MurderBot1/apriltag-processor/site/img/parts/usbc.webp

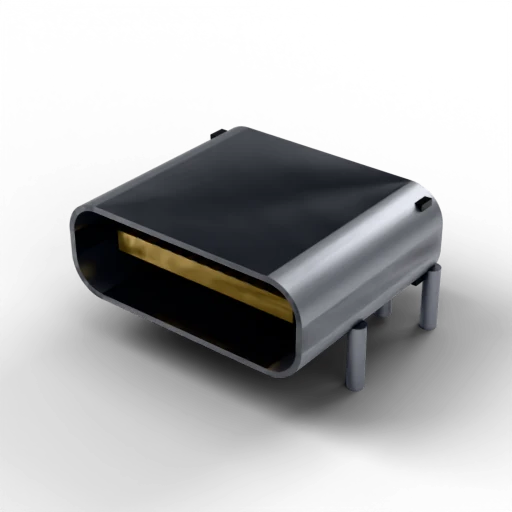
site/img/parts/usbc.webp
