MurderBot1/apriltag-processor/docs/RESUME.md

# Project state (rewritten 2026-11-01)

Rules for agents and the manager are in `CLAUDE.md`. This file is the current state of the project: what is done, how well each item is known, what can still go wrong, and what remains before a production run. Numbers come from the files named next to them; regenerate them with the tool named there.

## 1. What the product is

OV9281 global-shutter sensor (1280x800, 120 fps, 2-lane MIPI) -> ECP5 **LFE5U-25F-8BG381I** (custom RTL: D-PHY/CSI-2 receive, adaptive threshold, despeckle, connected-component labelling, `mask_stream`) -> 8-bit strobed frame bus (21.4 MB/s) -> RP2350A (PIO + DMA into 3 frame buffers, tag unit in C `firmware/core/attpu.c`, pose solve, field map and calibration in flash, USB CDC) -> host. This is architecture "A3" (`docs/architecture.md`, `docs/costdown.md`). The old FPGA processor (TPU) is kept only as the bit-exact reference in `ref/tpu`. All of A3, the sourcing changes, the PCB fixes and the lowcon register are merged into `main` (PRs #9 to #18).

## 2. Done, by how well it is known

### Verified by tests in CI (`tests.yml`, `tests/run_all.py`; about 230 tests, see `docs/verification.md`)

- RTL blocks are bit-exact against Python golden models (threshold, despeckle, labeller, CSI-2, D-PHY with lane skew, mask stream packet format and byte timing, I2C sensor init).
- The C tag unit `attpu.c` equals the instruction-set simulator of the old FPGA processor word for word on all 100 dataset frames.
- Whole-chip RTL chain on the 100-frame dataset at 120 fps timing: 501 of 570 detectable tags detected (87.9 %), no false positives (`results/rtl_chain_results.json`); the reference detector finds 560 of 570. The dataset is rendered with the shipping CIL023 camera model (section 6 of the risks).
- Firmware logic on the PC: COBS/CRC framing, flash storage with simulated power loss at every byte, command handling, host library end to end, pose solver (`test_pose_solver.py`).
- Board data (`tests/test_pcb.py`, `tests/test_pcb_erc.py`): every net has at least two pins, every FPGA power ball is on the right rail (the floating power pads of the earlier layout are connected), pin plan rules, BOM designators agree with `pcb/output/bom.csv`.
- Housing (`tests/test_housing.py`): watertight STLs, screw posts against PCB holes, FOV cone clearance for the 82.2 degree lens.
- Per-category dataset workflows report N/10 per category on PRs.
- Firmware image: `.github/workflows/firmware.yml` builds `apriltag_cam.uf2/.elf/.bin` on Linux with Pico SDK 2.1.1 and arm-none-eabi-gcc 13.2.1 and checks the size. Do not build firmware on Windows (msys `ld` fails).

### Estimated by tools, not signoff (treat as ± a margin)

- FPGA timing and area, LFE5U-25F speed 8 (nextpnr estimates, pinned OSS CAD Suite 2025-09-01, `results/fpga_speed_grades.md`): 13,389 LUT4 (55 %), 56 of 56 block RAM (100 %), core 92.27 - 94.91 MHz against 85.714 MHz needed, D-PHY 206.06 - 226.71 MHz against 200, 7 of 7 seeds close. Only speed grade 8 closes; grades 6 and 7 fail on both clocks. Numbers marked 45F in `docs/fpga.md` (12,227 LUT4, 56 of 108 block RAM, 4 of 6 seeds) are older RTL and older tools on the 45F.
- Tag unit and pose time on the Cortex-M33: emulated cycle counts, not silicon (`results/tpu_c_m33_cycles.md`, `results/pose_m33_cycles.json`): tag unit median about 1.6 ms, worst about 9.3 ms (nominal, 150 MHz, one core). Frame drop model (`results/frame_budget.md`): 3 buffers with early release, 0 % nominal and 1 % pessimistic drops. SRAM about 480 to 488 KB of 520 KiB (computed, not linked here).
- Cost per board (`docs/bom/PRODUCTION.md` section 4, generated by `tools/bom_cost_table.py`): 249.49 USD at 1 board, 106.98 at 10, 85.37 at 100 with the DigiKey 25F. This is a floor: no bare PCB, no OV9281, no shipping or taxes.
- Lens field of view: 82.2 degrees rectilinear HFOV from the focal length and sensor width; with the stated -5 % TV distortion the real value is about 84 to 85 degrees (one published data point). The simulated dataset uses fx 733.33 px, k1 -0.126 (my reading of -5 % TV); calibrate the real lens.

### Needs hardware (nothing below has been run on a real board)

- No board has been built or powered. No bitstream has been loaded on an ECP5; no firmware has run on an RP2350.
- PIO capture of the frame bus and the 21.4 MB/s timing margin (the PIO input synchroniser adds about 13 ns; the data window is 11.7 ns before and 35 ns after the strobe edge, from the model). DMA and CPU SRAM contention while the tag unit runs.
- Bus timing between FPGA and MCU, 3.3 V LVCMOS33 at DRIVE=8, trace delays.
- D-PHY at 800 Mb/s lane rate on the real sensor (the RTL receiver is only tested against a bit-level model), sensor register set and I2C bring-up on a real OV9281.
- Boot chain: flash, ECP5 configuration from SPI flash, MCU boot, power sequencing of the 1.2 V, 1.8 V, 2.5 V, 2.8 V, 3.3 V rails, USB enumeration.
- Real accuracy: the dataset is simulated.

## 3. Remaining risks

1. **25F block RAM is 100 % full (56 of 56).** Any RTL growth in block RAM needs the 45F or 85F. Both are pin- and footprint-compatible (`tools/pin_compat.py`: 31 used balls identical), the 85F closes timing on 6 of 7 seeds (seed 3 fails the D-PHY clock). The 45F speed 8 is out of stock.
2. **U1 supply.** Only 108 authorised LFE5U-25F-8BG381I pieces on 2026-11-01 (DigiKey 18, Mouser 90). Lead time for more is 40 weeks. A 100-board run cannot be built from stock today. Second source: 85F-8BG381C (about 2.5 times the price, DigiKey 17 / Mouser 10 / LCSC 8). Speed 6 and 7 parts do not close timing. The UM (SERDES) variant is not a drop-in (SERDES supply balls are tied to GND on this PCB).
3. **U6/U8 ME6211.** The datasheet was fetched on 2026-11-01 (MICRONE ME6211 V20, PDF copies from chipdip.ru and elecfans.com; the LCSC-hosted PDF could not be downloaded). Verified from it: SOT23-5 pinout 1 VIN, 2 VSS, 3 CE, 4 NC, 5 VOUT (matches the board), maximum output current 400 mA (2.5 V) and 450 mA (2.8 V), dropout typical 110 mV at 100 mA and 220 mV at 200 mA, VIN maximum 6.5 V. Still open: compare the revision with the LCSC-hosted datasheet at order time; the OV9281 AVDD/EVDD current from the OmniVision datasheet is not read, so the 450 mA margin on the 2.8 V rail is unchecked.
4. **OV9281 price is unverified.** No priced seller found (quote-only listings). It blocks a priced production BOM. Fallback: the Camemake module, which needs a PCB re-spin.
5. **Bare PCB price is unverified.** The JLCPCB 4-layer quote page could not be read; the BOM excludes it. Get a live quote (ENIG, impedance control for MIPI).
6. **Simulated dataset uses a modelled lens, not a calibrated one.** Since this update the 100 frames are rendered for CIL023 on the OV9281 (fx 733.33 px at 1280x800, HFOV 82.2 degrees, k1 = -0.126 for -5 % TV distortion, `tools/geom.py`, `config/camera_calibration.json`). The k1 value depends on how TV distortion is defined (see `docs/verification.md`); real optics (focus, vignetting, MTF, tangential error, sensor noise) will still differ. Detection moved from 562 / 647 (86.9 %, 90 degree camera) to 501 / 570 (87.9 %).
7. **lowcon ratio trade-off.** The THRESH `ratio` register fixes `lowcon` (ratio 2: 54 of 54 tags) but costs the `noise` category (19 of 50 at ratio 2) because speckle floods the labeller, so the reset value stays 0 (501 of 570 overall). A per-frame automatic choice is being built by another agent (firmware, host, API); it is not part of this state.
8. **No hardware tests at all** (see the needs-hardware list above): a first board bring-up will find problems that simulation cannot.
9. Y1 crystal (ABM8-272-T3, 10 pF) is out of stock at LCSC (5 at JLC) with the 15 pF load capacitors C15/C16: confirm the load capacitance or change C15/C16, and pick a second source.
10. Y2 oscillator is low stock (114 at LCSC and JLC). LH1 holder CLA021-LCP is in stock (1074 at Commonlands), the earlier CLA020-PC is sold out.
11. Simulation pages (`site/simout/`) were regenerated for the 100-frame dataset in PR #13; they need Icarus Verilog to regenerate (`iverilog`, not installed on the manager machine).
12. Release workflow (`release.yml`) has a dry-run input but no real release has been published. Pushing to `deploy` publishes one; default seed in `tools/build_all.sh` is 1 (closes on the 25F).

## 4. Production checklist (in order)

1. Re-check U1 stock and price at DigiKey, Mouser and LCSC; decide quantity against the 108 piece stock and the 40 week lead time; place the order or choose the 85F fallback.
2. Get a live JLCPCB 4-layer quote for the 48x48 mm board (ENIG, impedance control, 5 or more pieces) and put it in `bom.json` as a verified line.
3. Get a quote for the OV9281 (OmniVision distributor, CSP, MOQ) or decide on the module re-spin.
4. Read the OmniVision datasheet: sensor supply currents (U8 margin), ordering code (H64A or other), MIPI rate, register set.
5. Compare the ME6211 datasheet revision from LCSC with V20 used here; check the C15/C16 against the Y1 load capacitance; choose a Y1 second source.
6. Re-run DRC on the final board, regenerate gerbers, BOM and pick-and-place with the repo scripts; check `pcb/output/bom.csv` against `docs/bom/bom.json` (`tests/test_pcb_erc.py`).
7. Order a small run (5 boards). Before power-up: check rail resistances, then bring up rails one at a time (3.3 V, 1.2 V, 1.8 V, 2.5 V, 2.8 V).
8. Bring-up: JTAG to the ECP5, load the bitstream from the release (`tools/build_all.sh` output), flash the UF2 to the RP2350, enumerate USB, read the sensor ID 0x9281 over I2C, check the D-PHY clock lane, capture one frame, check the PIO capture and packet counters (frames dropped), run the host library.
9. Measure on hardware what is now estimated: FPGA clocks and margin, frame bus timing, tag unit and pose time, drop rate at 120 fps, power.
10. Calibrate the real lens (fx, fy, cx, cy, k1 to k3), recompute HFOV, and build a real image set with ground truth to replace or add to the simulated one (the simulated set already uses the nominal fx and a modelled -5 % TV k1).
11. Tag the release: merge `main` into `deploy` (`git push origin main:deploy`), which builds everything and creates a new GitHub Release; check the release assets.

## 5. Working notes

- Windows `git push` hangs on the credential manager; use the command in `CLAUDE.md` (empty `credential.helper` first, then the `gh` helper).
- Windows reports an agent folder as busy when an agent left a hung `git` process behind: kill only those `git` / `git-credential-manager` processes, then delete the folder.
- `todo.md` in the manager repo is untracked.
- BOM or site changes: edit `docs/bom/bom.json`, run `python docs/bom/build_bom.py` and `py -3.12 site/build_site.py`, commit the generated files, keep `pcb/output/bom.csv` consistent. Cost table: `python tools/bom_cost_table.py`.
