MurderBot1/apriltag-processor/render/out/pcb_layers/pcb_bottom_8192.png

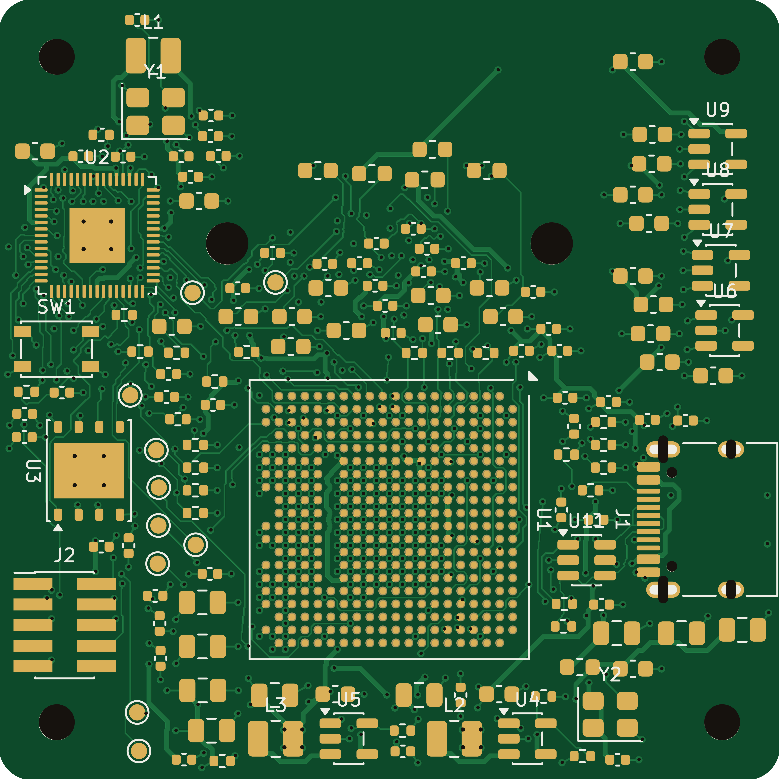
render/out/pcb_layers/pcb_bottom_8192.png
