MurderBot1/apriltag-processor/render/out/pcb_layers/tiles/bcu/3/0_0.png

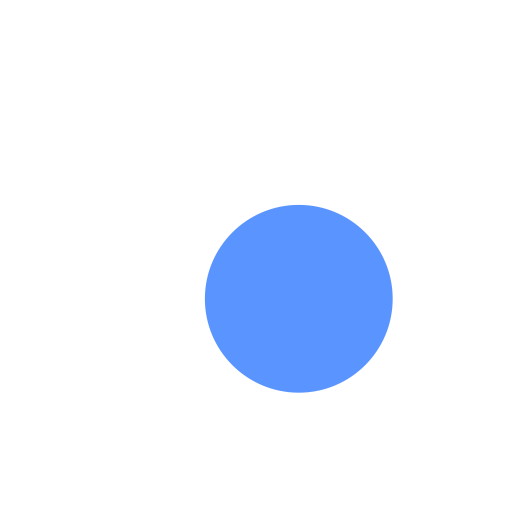
render/out/pcb_layers/tiles/bcu/3/0_0.png
