MurderBot1/apriltag-processor/render/out/pcb_layers/tiles/bcu/3/1_6.png

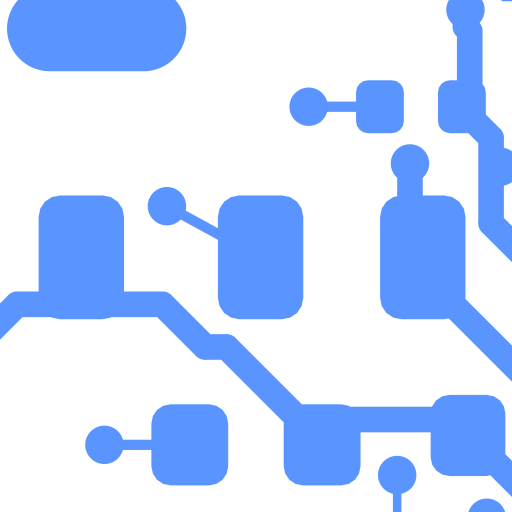
render/out/pcb_layers/tiles/bcu/3/1_6.png
