MurderBot1/apriltag-processor/render/out/pcb_layers/tiles/bcu/3/2_1.png

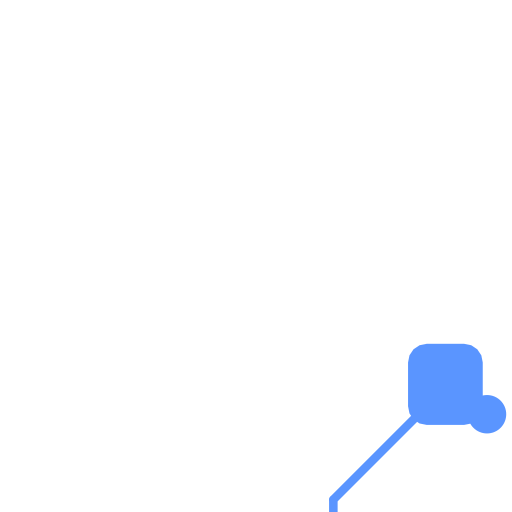
render/out/pcb_layers/tiles/bcu/3/2_1.png
