MurderBot1/apriltag-processor/render/out/pcb_layers/tiles/bcu/3/4_7.png

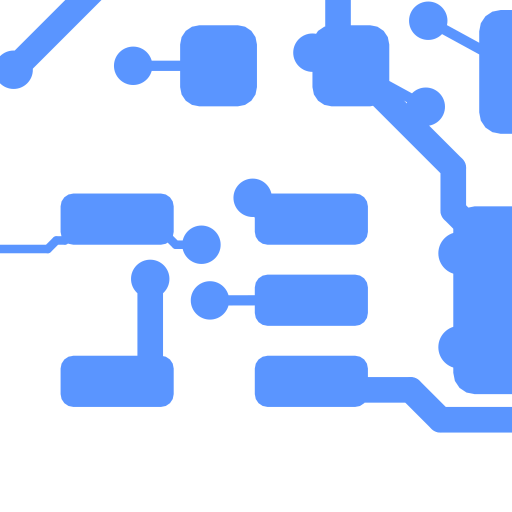
render/out/pcb_layers/tiles/bcu/3/4_7.png
