MurderBot1/apriltag-processor/render/out/pcb_layers/tiles/bmask/3/6_0.png

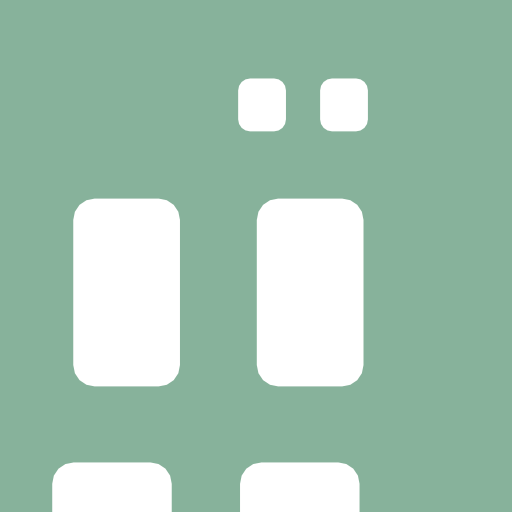
render/out/pcb_layers/tiles/bmask/3/6_0.png
