MurderBot1/apriltag-processor/render/out/pcb_layers/tiles/bmask/3/7_2.png

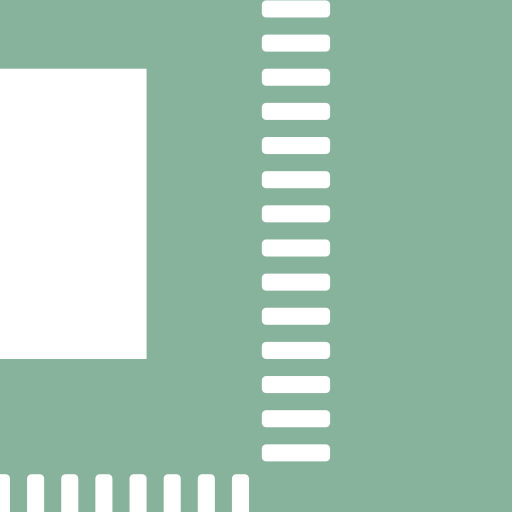
render/out/pcb_layers/tiles/bmask/3/7_2.png
