MurderBot1/apriltag-processor/render/out/pcb_layers/tiles/bsilk/1/1_0.png

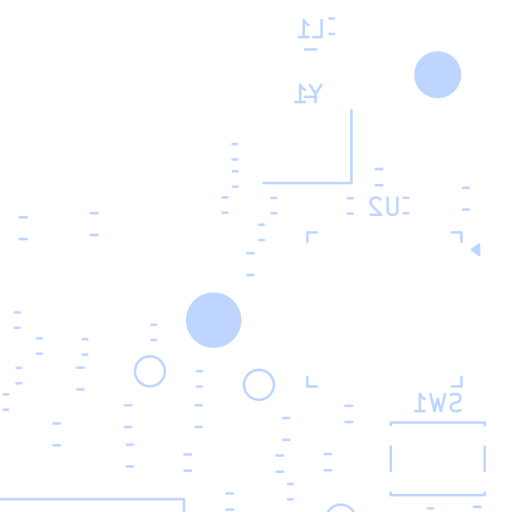
render/out/pcb_layers/tiles/bsilk/1/1_0.png
