MurderBot1/apriltag-processor/render/out/pcb_layers/tiles/bsilk/2/1_3.png

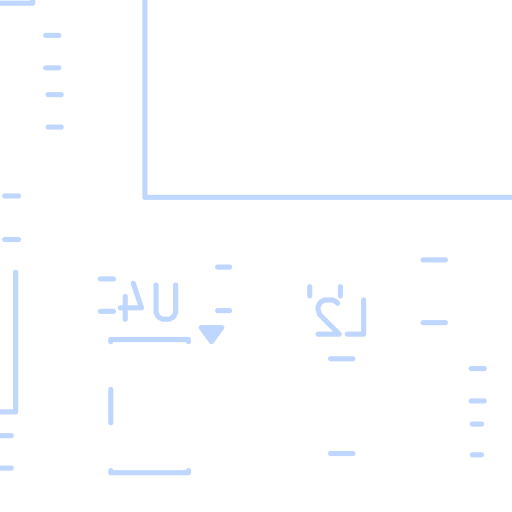
render/out/pcb_layers/tiles/bsilk/2/1_3.png
