MurderBot1/apriltag-processor/render/out/pcb_layers/tiles/bsilk/3/2_4.png

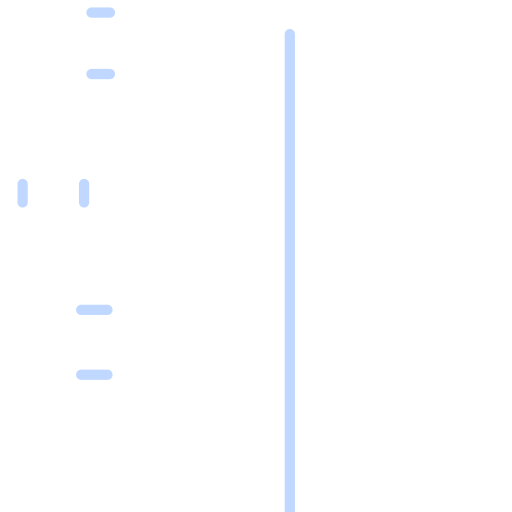
render/out/pcb_layers/tiles/bsilk/3/2_4.png
