MurderBot1/apriltag-processor/render/out/pcb_layers/tiles/bsilk/3/5_5.png

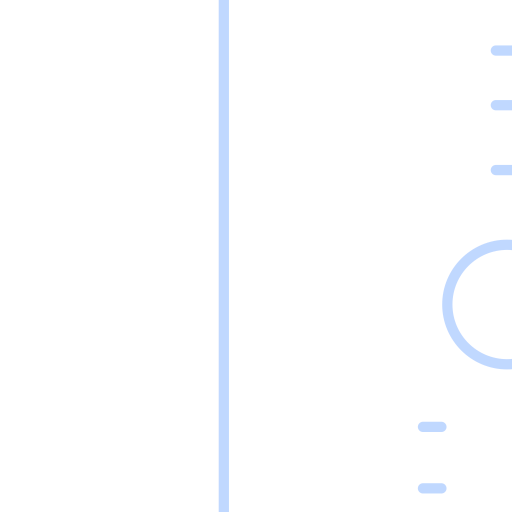
render/out/pcb_layers/tiles/bsilk/3/5_5.png
