MurderBot1/apriltag-processor/render/out/pcb_layers/tiles/bsilk/3/6_1.png

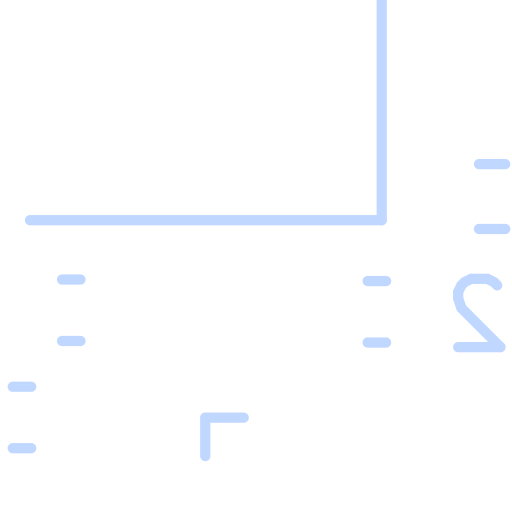
render/out/pcb_layers/tiles/bsilk/3/6_1.png
