MurderBot1/apriltag-processor/render/out/pcb_layers/tiles/fcu/2/2_0.png

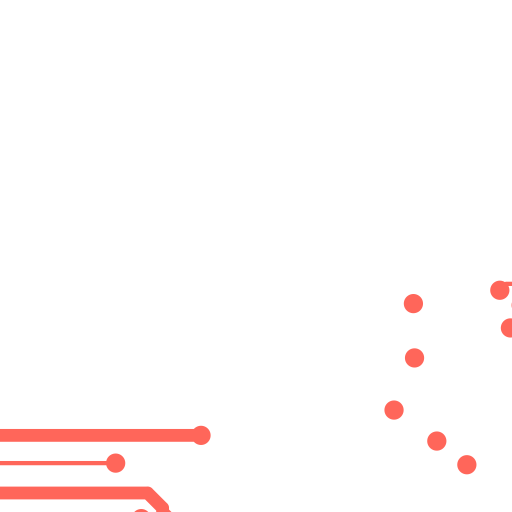
render/out/pcb_layers/tiles/fcu/2/2_0.png
