MurderBot1/apriltag-processor/render/out/pcb_layers/tiles/fcu/2/3_3.png

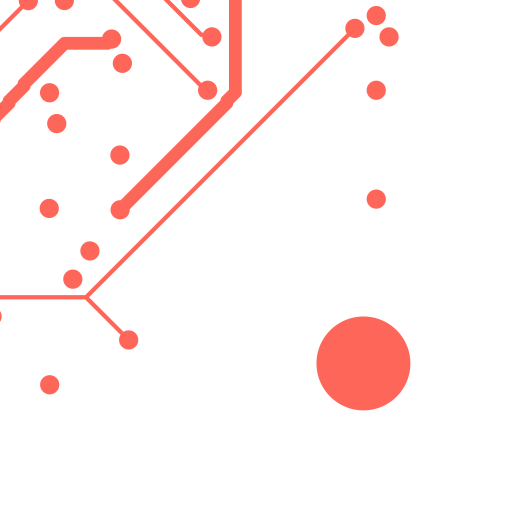
render/out/pcb_layers/tiles/fcu/2/3_3.png
