MurderBot1/apriltag-processor/render/out/pcb_layers/tiles/fcu/3/0_5.png

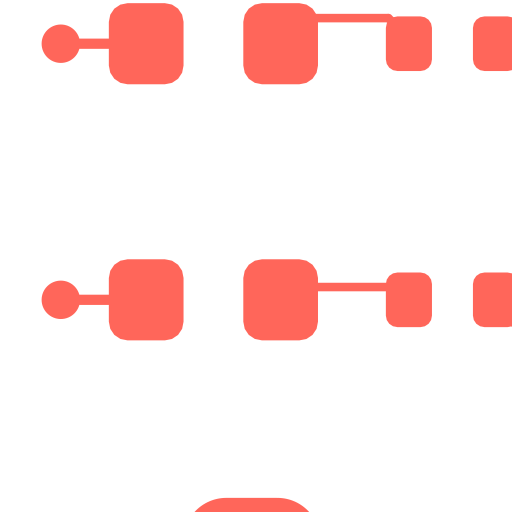
render/out/pcb_layers/tiles/fcu/3/0_5.png
