MurderBot1/apriltag-processor/render/out/pcb_layers/tiles/fcu/3/3_7.png

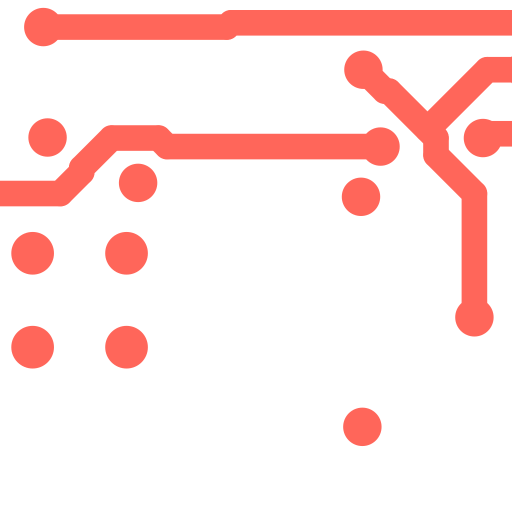
render/out/pcb_layers/tiles/fcu/3/3_7.png
