MurderBot1/apriltag-processor/render/out/pcb_layers/tiles/fcu/3/6_7.png

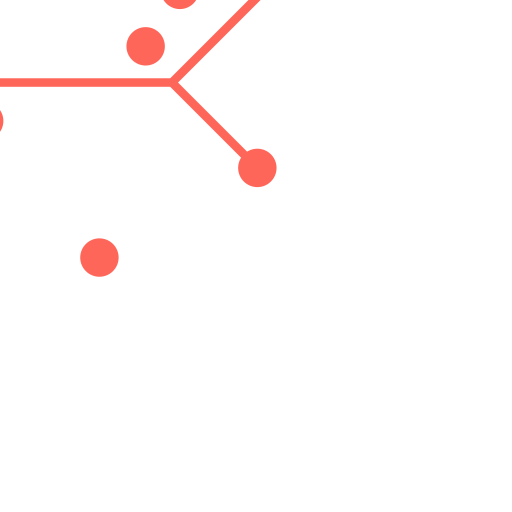
render/out/pcb_layers/tiles/fcu/3/6_7.png
