MurderBot1/apriltag-processor/render/out/pcb_layers/tiles/fmask/3/0_5.png

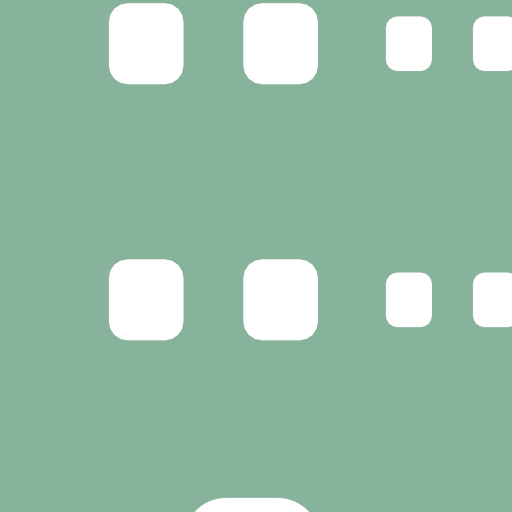
render/out/pcb_layers/tiles/fmask/3/0_5.png
