MurderBot1/apriltag-processor/render/out/pcb_layers/tiles/fsilk/0/0_0.png

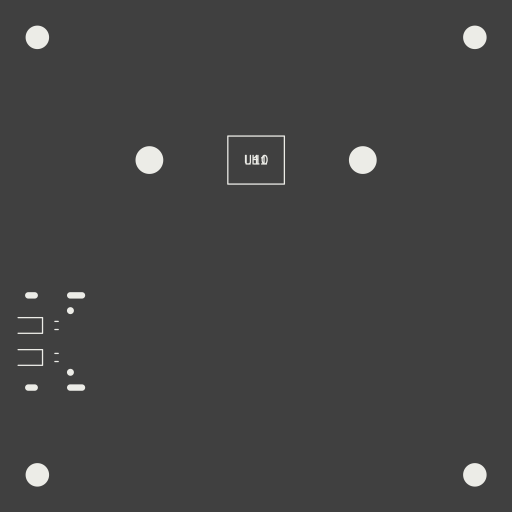
render/out/pcb_layers/tiles/fsilk/0/0_0.png
