MurderBot1/apriltag-processor/render/out/pcb_layers/tiles/fsilk/2/0_2.png

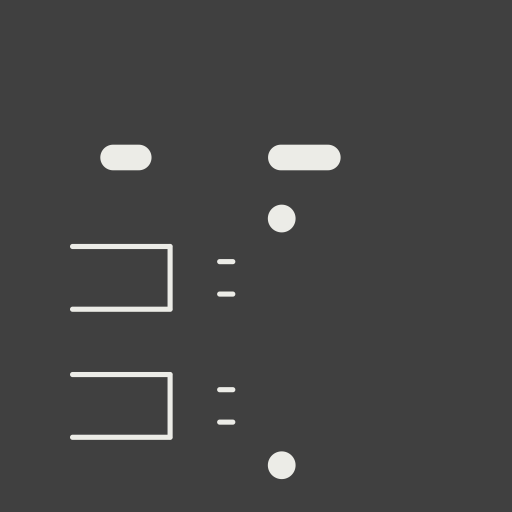
render/out/pcb_layers/tiles/fsilk/2/0_2.png
