MurderBot1/apriltag-processor/render/out/pcb_layers/tiles/fsilk/2/3_0.png

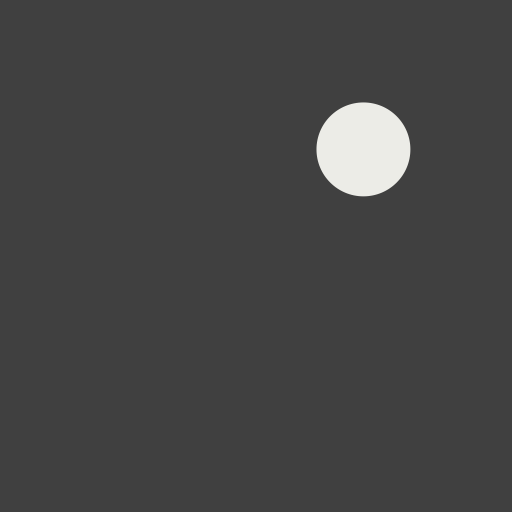
render/out/pcb_layers/tiles/fsilk/2/3_0.png
