MurderBot1/apriltag-processor/render/out/pcb_layers/tiles/fsilk/3/0_7.png

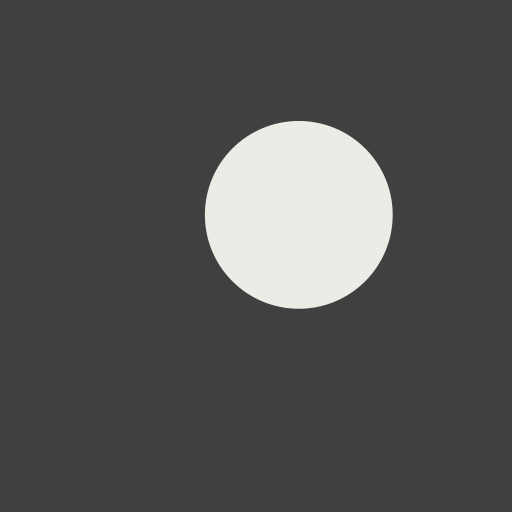
render/out/pcb_layers/tiles/fsilk/3/0_7.png
