MurderBot1/apriltag-processor/render/out/pcb_layers/tiles/fsilk/4/0_15.png

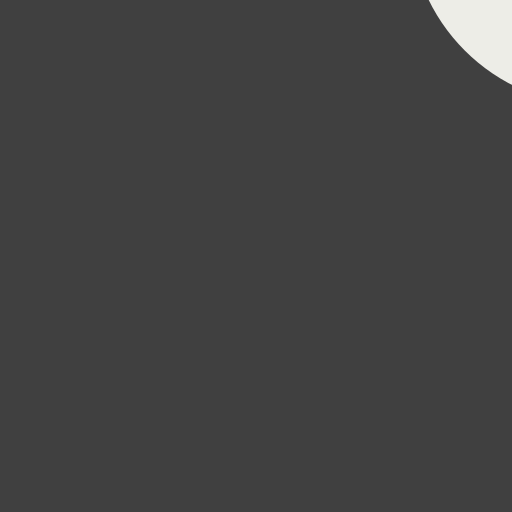
render/out/pcb_layers/tiles/fsilk/4/0_15.png
