MurderBot1/apriltag-processor/render/out/pcb_layers/tiles/fsilk/4/8_5.png

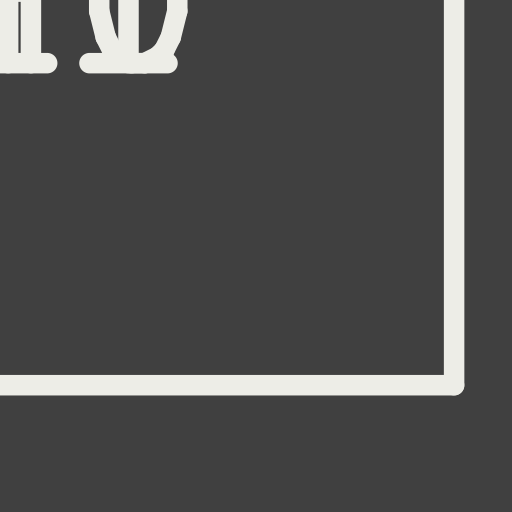
render/out/pcb_layers/tiles/fsilk/4/8_5.png
