MurderBot1/apriltag-processor/render/out/pcb_layers/tiles/fsilk/4/11_4.png

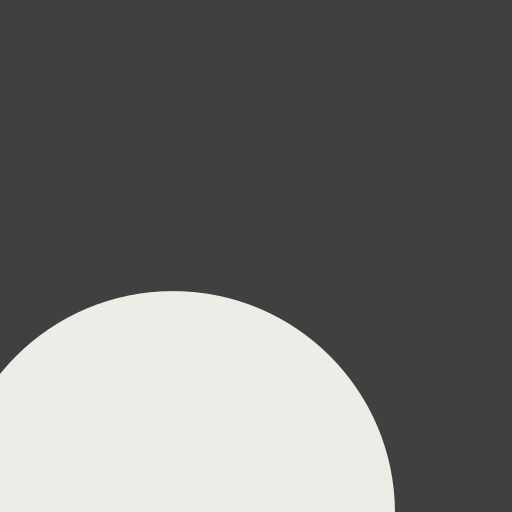
render/out/pcb_layers/tiles/fsilk/4/11_4.png
