MurderBot1/apriltag-processor/render/out/pcb_layers/tiles/in1/3/1_3.png

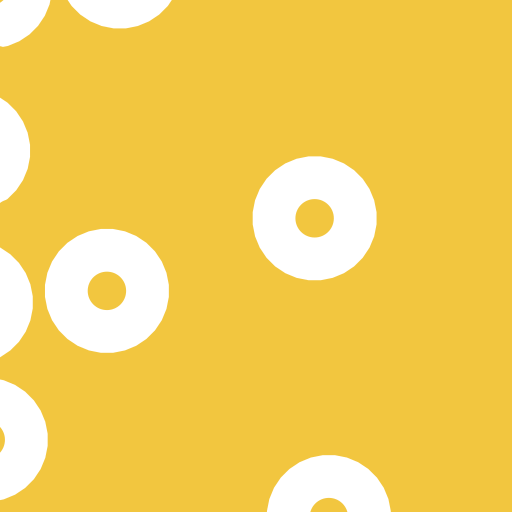
render/out/pcb_layers/tiles/in1/3/1_3.png
