MurderBot1/apriltag-processor/render/out/pcb_layers/tiles/in1/3/2_7.png

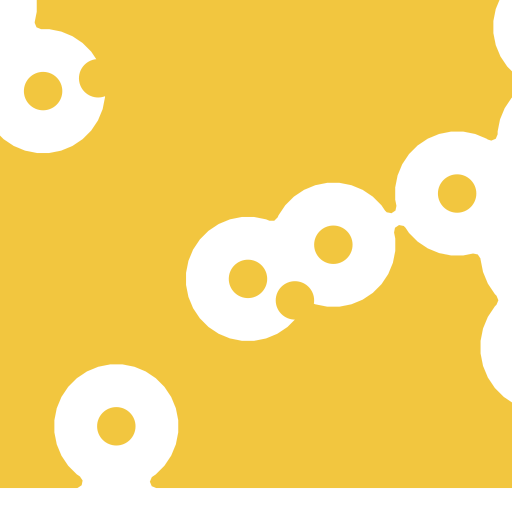
render/out/pcb_layers/tiles/in1/3/2_7.png
