MurderBot1/apriltag-processor/render/out/pcb_layers/tiles/in1/3/3_6.png

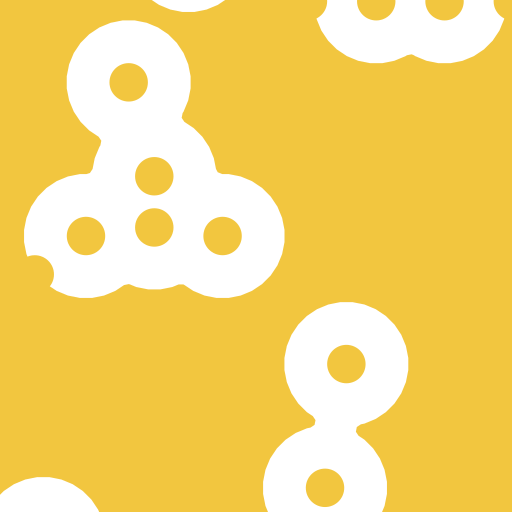
render/out/pcb_layers/tiles/in1/3/3_6.png
