MurderBot1/apriltag-processor/render/out/pcb_layers/tiles/in1/3/4_4.png

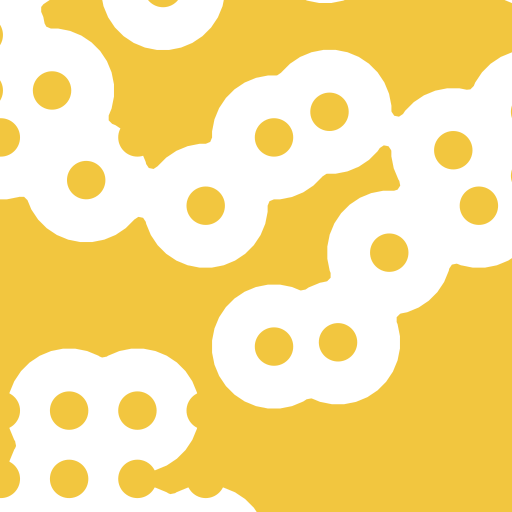
render/out/pcb_layers/tiles/in1/3/4_4.png
