MurderBot1/apriltag-processor/render/out/pcb_layers/tiles/in1/3/6_6.png

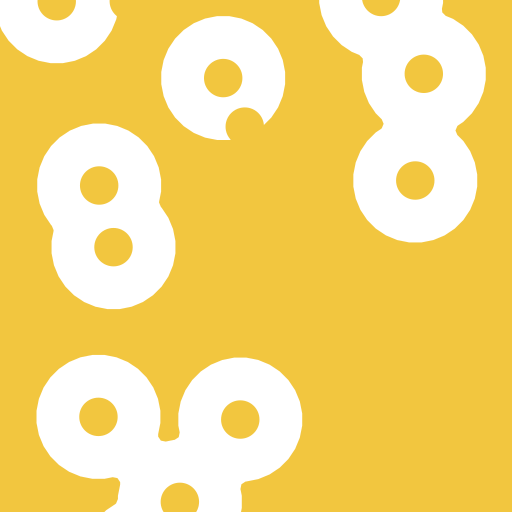
render/out/pcb_layers/tiles/in1/3/6_6.png
