MurderBot1/apriltag-processor/render/out/pcb_layers/tiles/in1/3/7_0.png

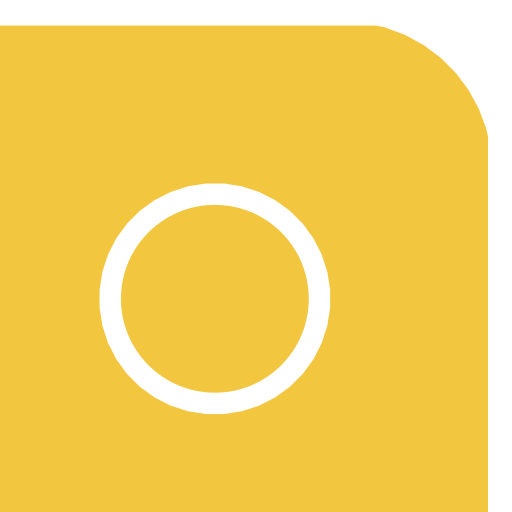
render/out/pcb_layers/tiles/in1/3/7_0.png
