MurderBot1/apriltag-processor/render/out/pcb_layers/tiles/in2/1/0_0.png

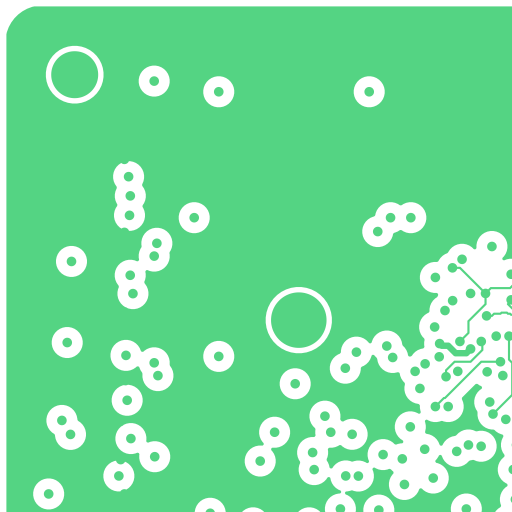
render/out/pcb_layers/tiles/in2/1/0_0.png
