MurderBot1/apriltag-processor/render/out/pcb_layers/tiles/in2/1/1_1.png

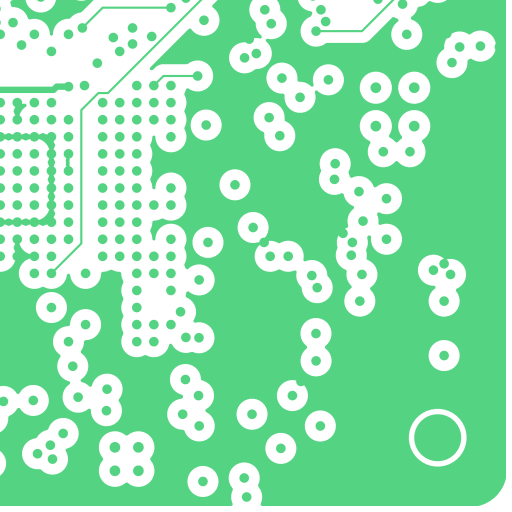
render/out/pcb_layers/tiles/in2/1/1_1.png
