MurderBot1/apriltag-processor/render/out/pcb_layers/tiles/in2/3/0_2.png

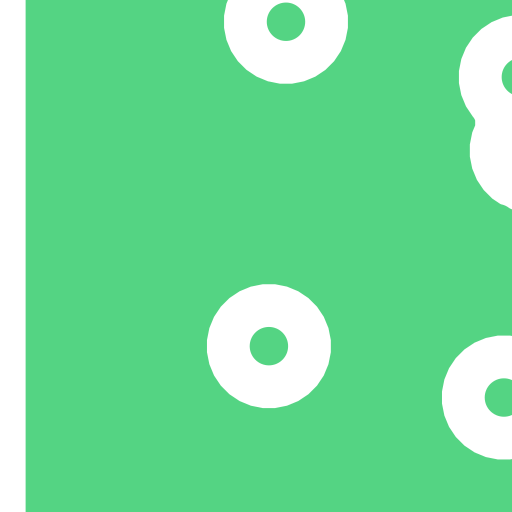
render/out/pcb_layers/tiles/in2/3/0_2.png
