MurderBot1/apriltag-processor/render/out/pcb_layers/tiles/in2/3/2_3.png

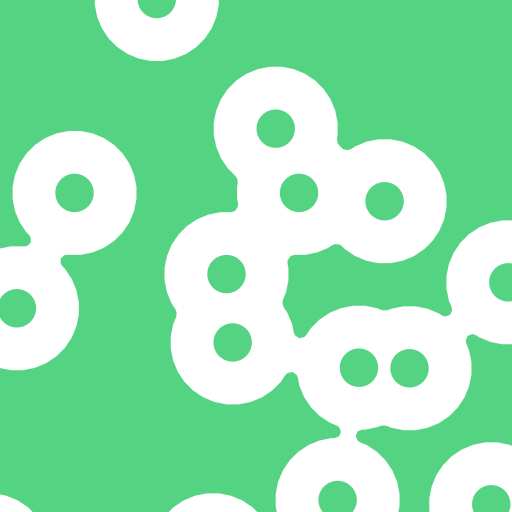
render/out/pcb_layers/tiles/in2/3/2_3.png
