MurderBot1/apriltag-processor/render/out/pcb_layers/tiles/in2/3/7_4.png

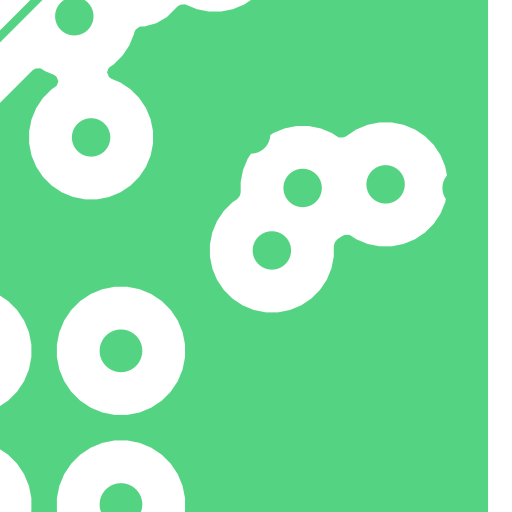
render/out/pcb_layers/tiles/in2/3/7_4.png
