MurderBot1/apriltag-processor/render/out/pcb_layers/tiles/rbot/2/0_1.png

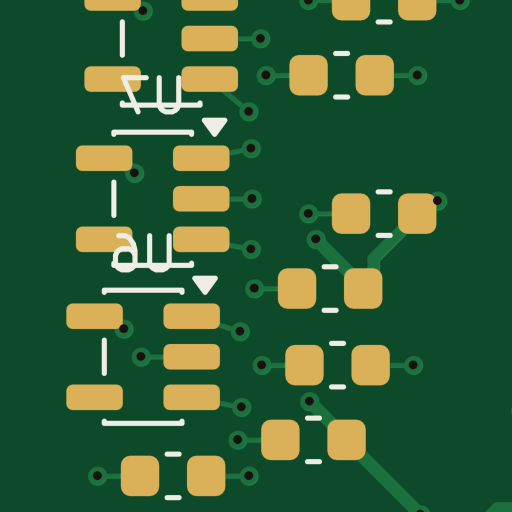
render/out/pcb_layers/tiles/rbot/2/0_1.png
