MurderBot1/apriltag-processor/render/out/pcb_layers/tiles/rbot/3/1_7.png

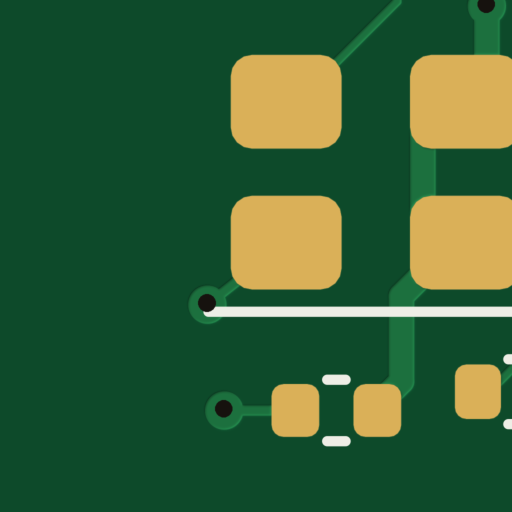
render/out/pcb_layers/tiles/rbot/3/1_7.png
