MurderBot1/apriltag-processor/render/out/pcb_layers/tiles/rbot/3/4_5.png

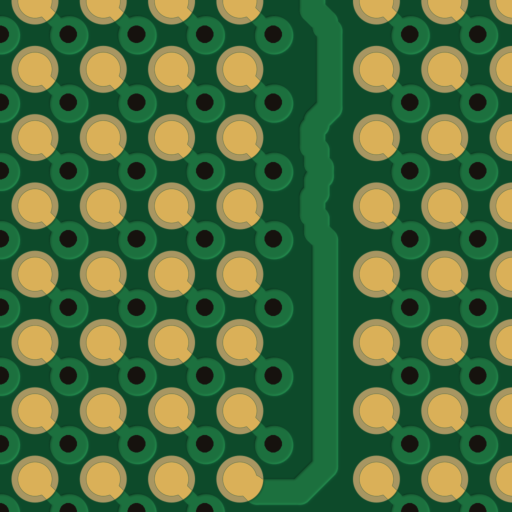
render/out/pcb_layers/tiles/rbot/3/4_5.png
