MurderBot1/apriltag-processor/render/out/pcb_layers/tiles/rbot/3/5_3.png

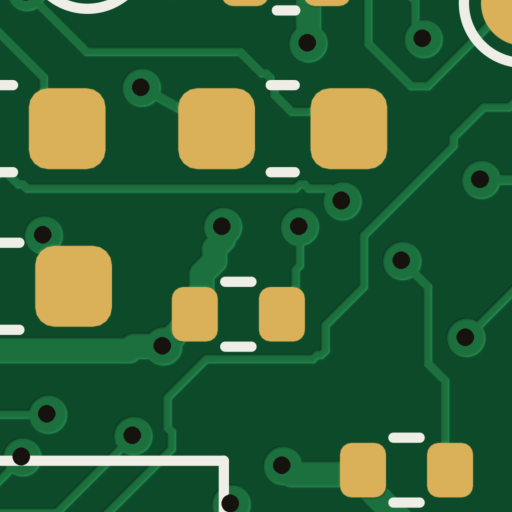
render/out/pcb_layers/tiles/rbot/3/5_3.png
