MurderBot1/apriltag-processor/render/out/pcb_layers/tiles/rbot/3/5_6.png

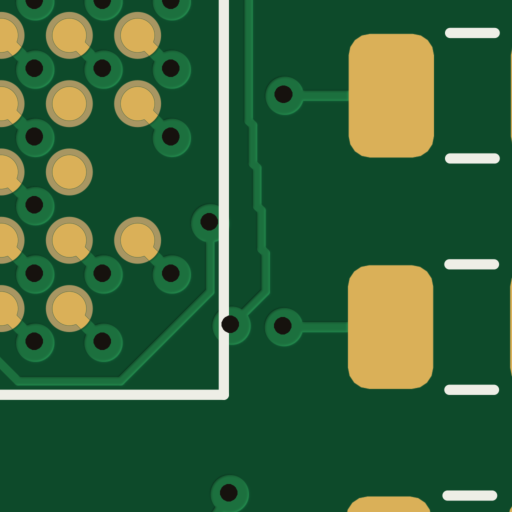
render/out/pcb_layers/tiles/rbot/3/5_6.png
