MurderBot1/apriltag-processor/render/out/pcb_layers/tiles/rtop/2/2_1.png

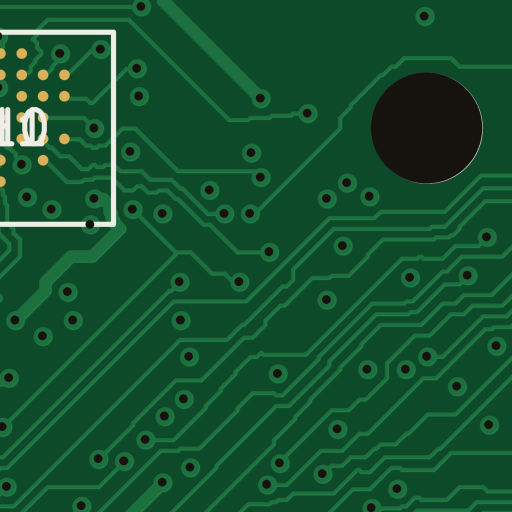
render/out/pcb_layers/tiles/rtop/2/2_1.png
