MurderBot1/apriltag-processor/render/out/pcb_layers/tiles/rtop/3/0_1.png

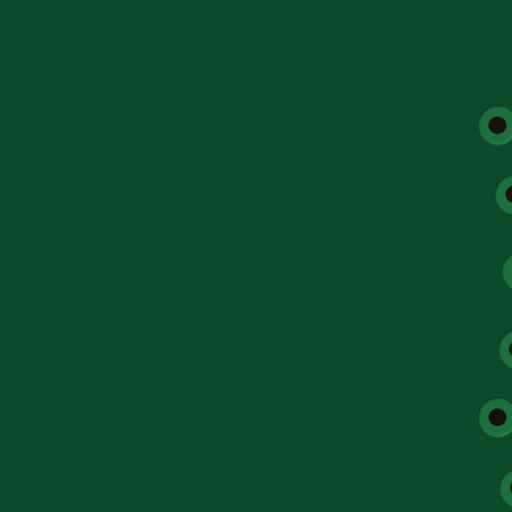
render/out/pcb_layers/tiles/rtop/3/0_1.png
