MurderBot1/apriltag-processor/render/out/pcb_layers/tiles/rtop/3/4_3.png

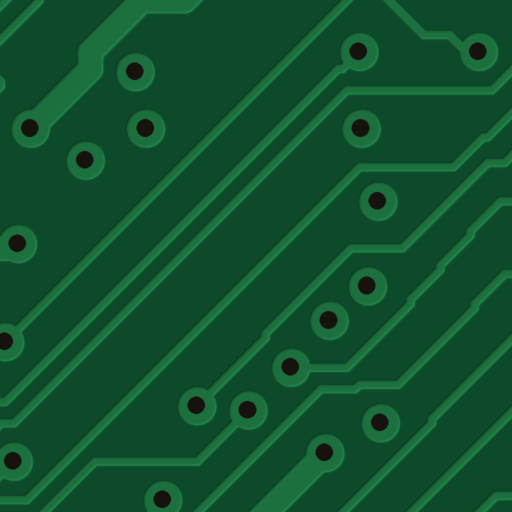
render/out/pcb_layers/tiles/rtop/3/4_3.png
