MurderBot1/apriltag-processor/render/out/pcb_layers/tiles/rtop/3/6_7.png

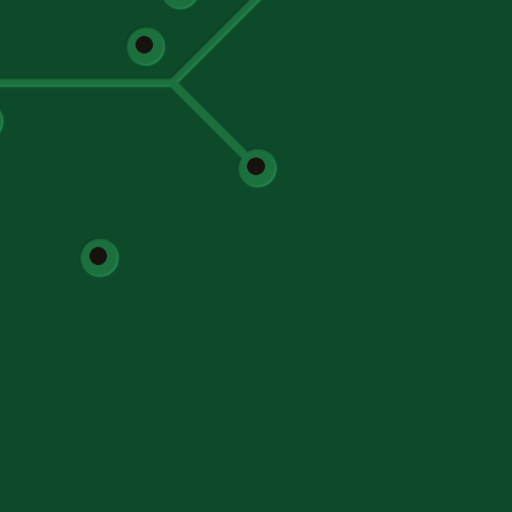
render/out/pcb_layers/tiles/rtop/3/6_7.png
