MurderBot1/apriltag-processor/render/out/turntable.webp

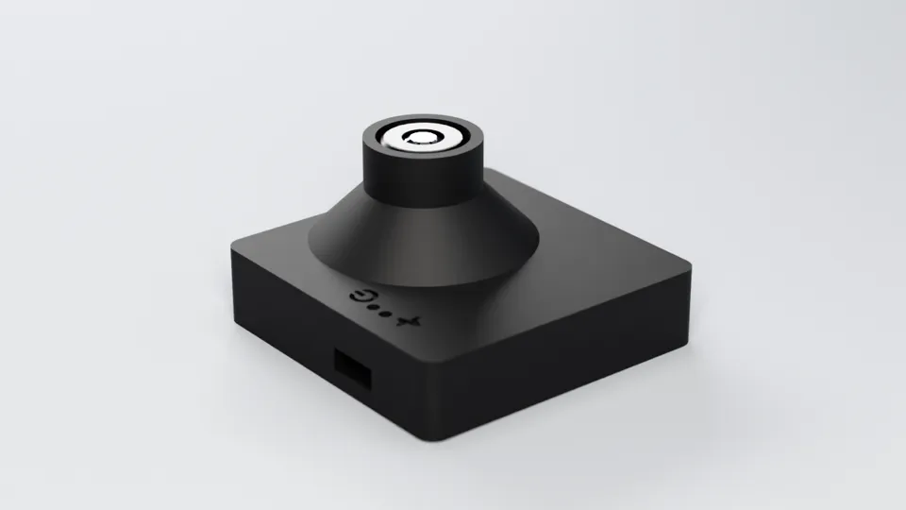
render/out/turntable.webp
