MurderBot1/apriltag-processor/site/img/r_section.png

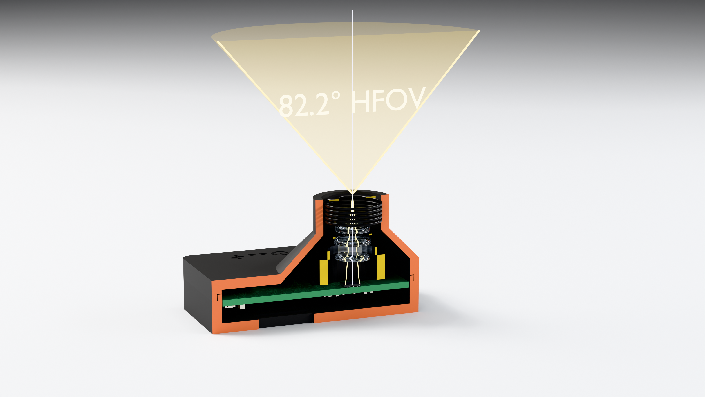
site/img/r_section.png
