MurderBot1/apriltag-processor/pcb/output/bom.csv

Qty | Value | Footprint | References
46 | 100n | C_0402_1005Metric | C1 C2 C3 C4 C5 C6 C7 C8 C9 C13 C14 C17 C38 C39 C40 C41 C42 C43 C44 C45 C46 C47 C48 C49 C50 C51 C52 C53 C54 C55 C56 C57 C58 C59 C60 C61 C62 C63 C64 C65 C70 C72 C74 C76 C77 C78
9 | 4u7 | C_0603_1608Metric | C10 C11 C12 C36 C37 C66 C67 C68 C69
2 | 15p | C_0402_1005Metric | C15 C16
4 | 10u | C_0805_2012Metric | C18 C19 C21 C24
12 | 1u | C_0603_1608Metric | C20 C28 C30 C32 C34 C71 C73 C75 C79 C80 C81 C82
5 | 22u | C_0805_2012Metric | C22 C23 C25 C26 C27
4 | 2u2 | C_0603_1608Metric | C29 C31 C33 C35
1 | PWR | LED_0603_1608Metric | D1
1 | STAT | LED_0603_1608Metric | D2
1 | BLM18 600R | L_0603_1608Metric | FB1
5 | BLM18 120R | L_0603_1608Metric | FB2 FB3 FB4 FB5 FB6
1 | USB-C | USB_C_Receptacle_HRO_TYPE-C-31-M-12 | J1
1 | JTAG | PinHeader_2x05_P1.27mm_Vertical_SMD | J2
1 | 3u3 | L_1008_2520Metric | L1
2 | 2u2 | L_1008_2520Metric | L2 L3
2 | 33R | R_0402_1005Metric | R1 R2
1 | 453k | R_0402_1005Metric | R10
2 | 100k | R_0402_1005Metric | R11 R13
1 | 82k5 | R_0402_1005Metric | R12
3 | 4k7 | R_0402_1005Metric | R16 R17 R18
3 | 100R | R_0402_1005Metric | R24 R25 R26
2 | 2k2 | R_0402_1005Metric | R27 R28
6 | 10k | R_0402_1005Metric | R3 R19 R20 R21 R22 R23
4 | 1k | R_0402_1005Metric | R4 R5 R14 R15
2 | 5k1 | R_0402_1005Metric | R6 R7
2 | 27R | R_0402_1005Metric | R8 R9
1 | BOOTSEL | SW_SPST_PTS810 | SW1
1 | LFE5U-25F-8BG381I | Lattice_caBGA-381_17x17mm_Layout20x20_P0.8mm | U1
1 | USBLC6-2SC6 | SOT-23-6 | U11
1 | RP2350A | QFN-60-1EP_7x7mm_P0.4mm_EP3.4x3.4mm | U2
1 | W25Q128JVPIQ | WSON-8-1EP_6x5mm_P1.27mm_EP3.4x4.3mm | U3
2 | TLV62569 | SOT-23-5 | U4 U5
1 | ME6211C25 | SOT-23-5 | U6
1 | TLV75518 | SOT-23-5 | U7
1 | ME6211C28 | SOT-23-5 | U8
1 | TLV75512 | SOT-23-5 | U9
1 | 12MHz 10pF | Crystal_SMD_3225-4Pin_3.2x2.5mm | Y1
1 | 24MHz 1.8V | Oscillator_SMD_Abracon_ASE-4Pin_3.2x2.5mm | Y2
