MurderBot1/apriltag-processor/render/out/parts/c0402.webp

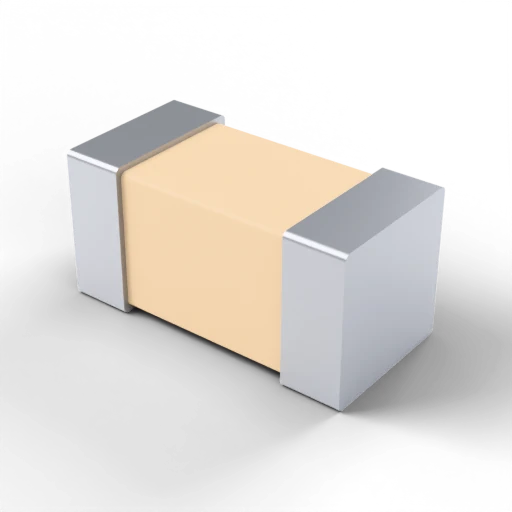
render/out/parts/c0402.webp
