MurderBot1/apriltag-processor/render/out/parts/c0805.webp

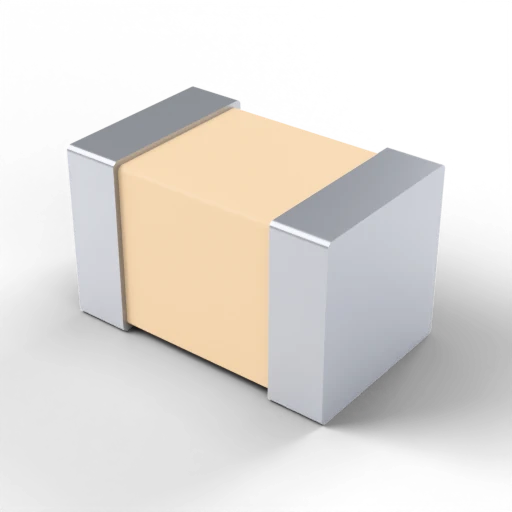
render/out/parts/c0805.webp
