MurderBot1/apriltag-processor/render/out/parts/ecp5.webp

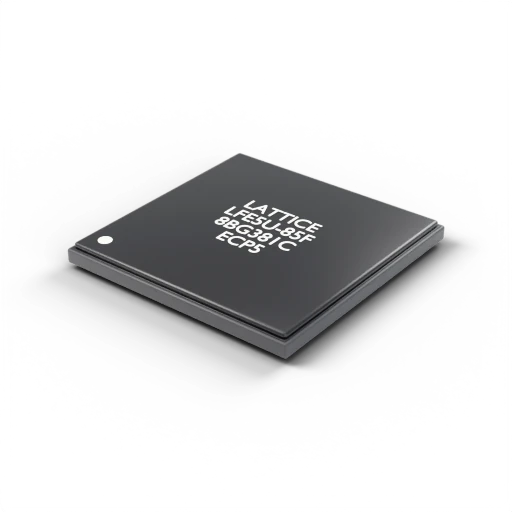
render/out/parts/ecp5.webp
