MurderBot1/apriltag-processor/render/out/parts/filament.webp

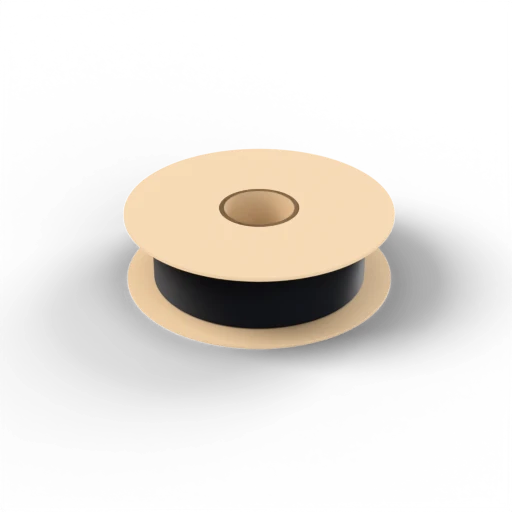
render/out/parts/filament.webp
