MurderBot1/apriltag-processor/render/out/parts/flash.webp

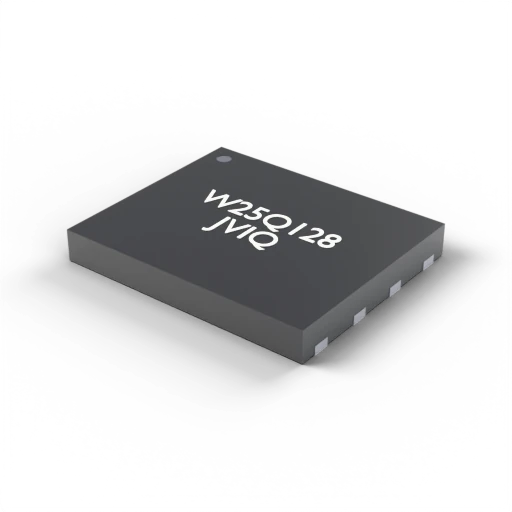
render/out/parts/flash.webp
