MurderBot1/apriltag-processor/render/out/parts/hdr.webp

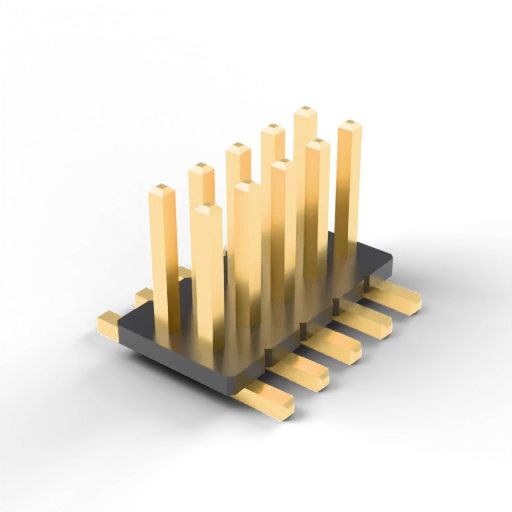
render/out/parts/hdr.webp
