MurderBot1/apriltag-processor/render/out/parts/holder.webp

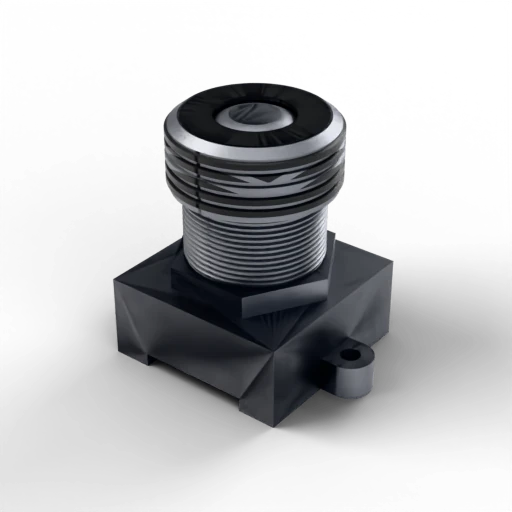
render/out/parts/holder.webp
