MurderBot1/apriltag-processor/render/out/parts/insert.webp

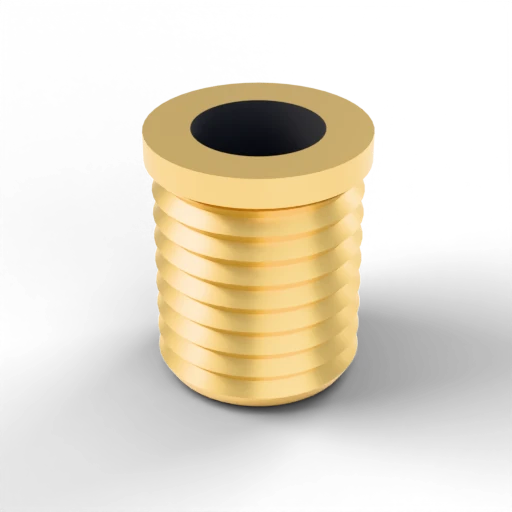
render/out/parts/insert.webp
