MurderBot1/apriltag-processor/render/out/parts/l0603.webp

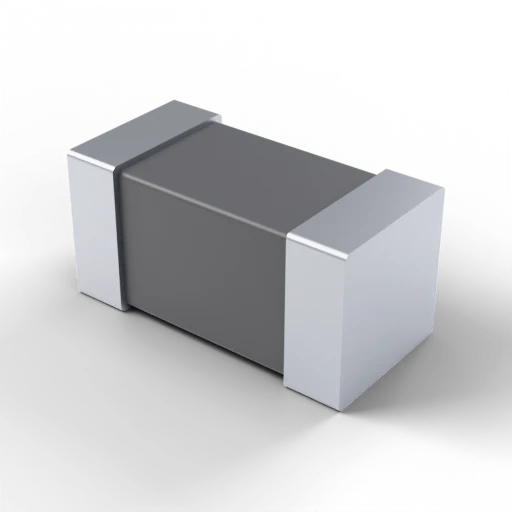
render/out/parts/l0603.webp
