MurderBot1/apriltag-processor/render/out/parts/l1008.webp

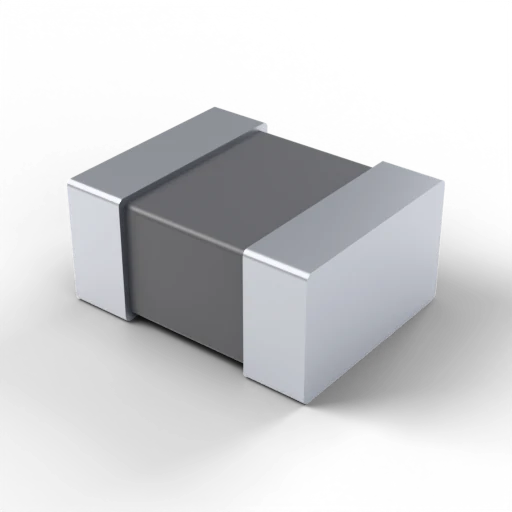
render/out/parts/l1008.webp
