MurderBot1/apriltag-processor/render/out/parts/led.webp

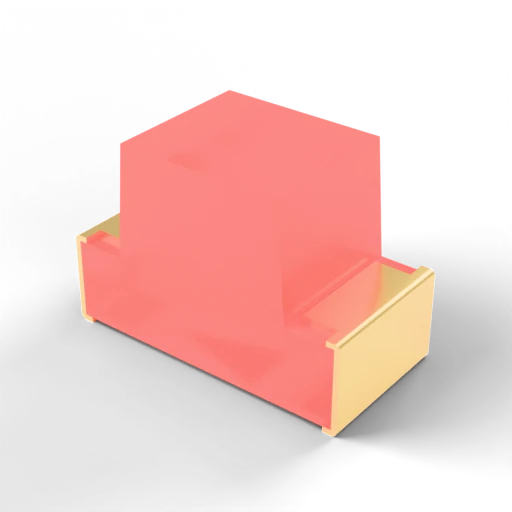
render/out/parts/led.webp
