MurderBot1/apriltag-processor/render/out/parts/lens.webp

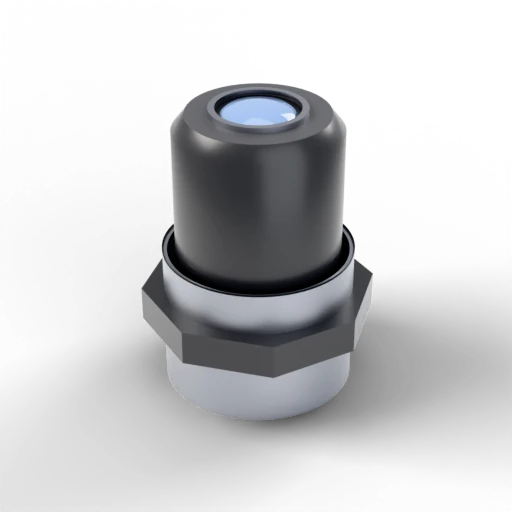
render/out/parts/lens.webp
