MurderBot1/apriltag-processor/render/out/parts/osc.webp

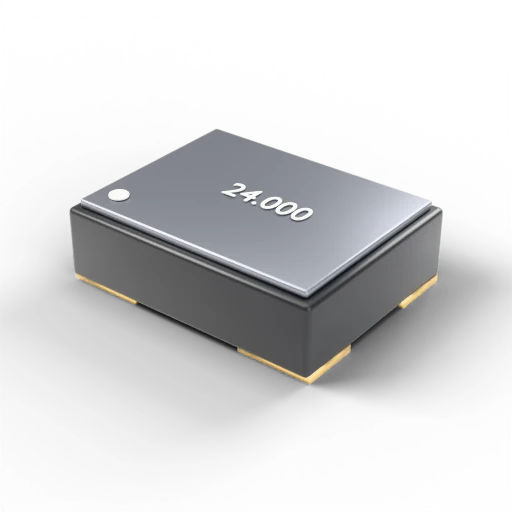
render/out/parts/osc.webp
