MurderBot1/apriltag-processor/render/out/parts/ov9281.webp

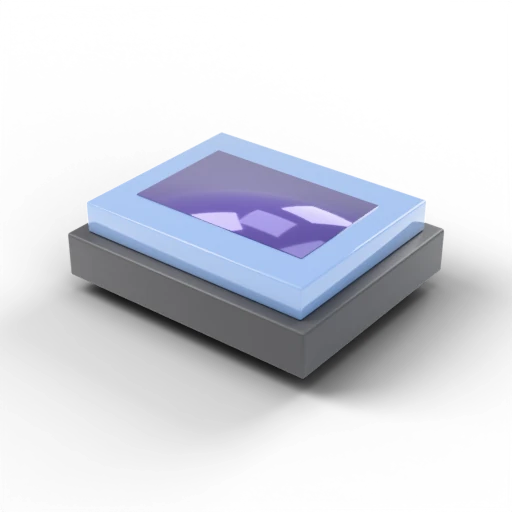
render/out/parts/ov9281.webp
