MurderBot1/apriltag-processor/render/out/parts/pcb.webp

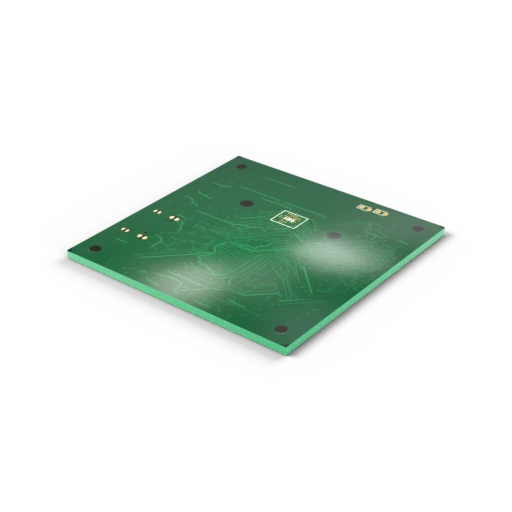
render/out/parts/pcb.webp
