MurderBot1/apriltag-processor/render/out/parts/r0402.webp

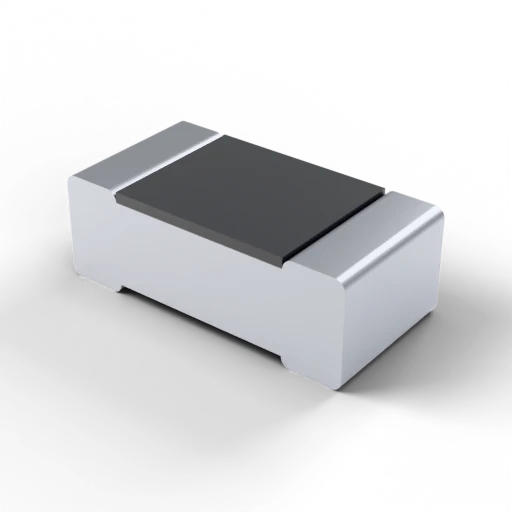
render/out/parts/r0402.webp
