MurderBot1/apriltag-processor/render/out/parts/rp2350.webp

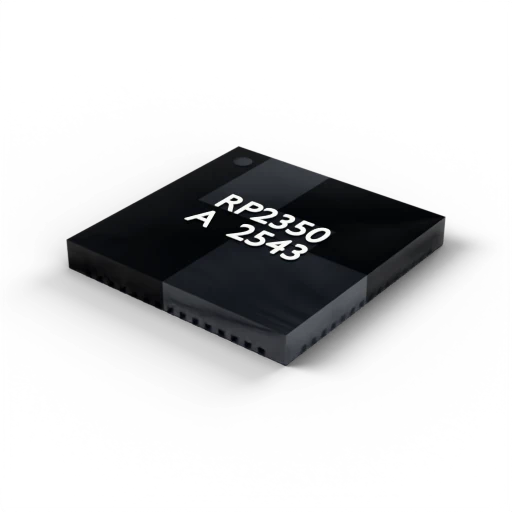
render/out/parts/rp2350.webp
