MurderBot1/apriltag-processor/render/out/parts/screw.webp

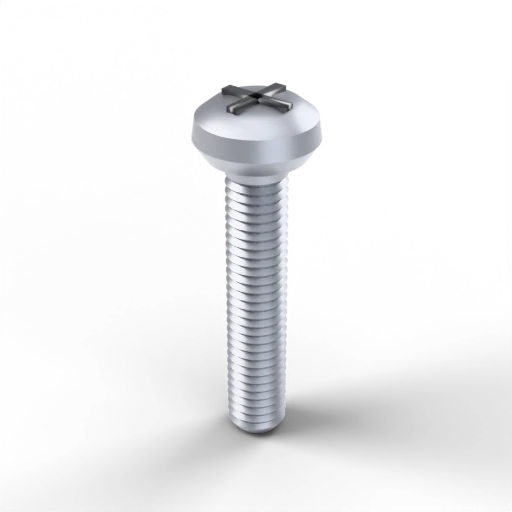
render/out/parts/screw.webp
