MurderBot1/apriltag-processor/render/out/parts/sw.webp

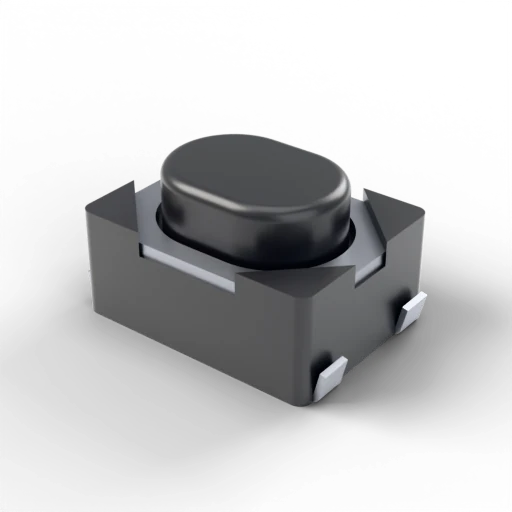
render/out/parts/sw.webp
