MurderBot1/apriltag-processor/render/out/parts/tlv62569.webp

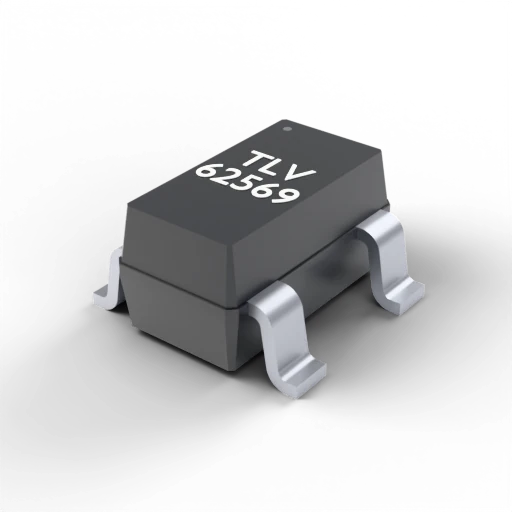
render/out/parts/tlv62569.webp
