MurderBot1/apriltag-processor/render/out/parts/xtal.webp

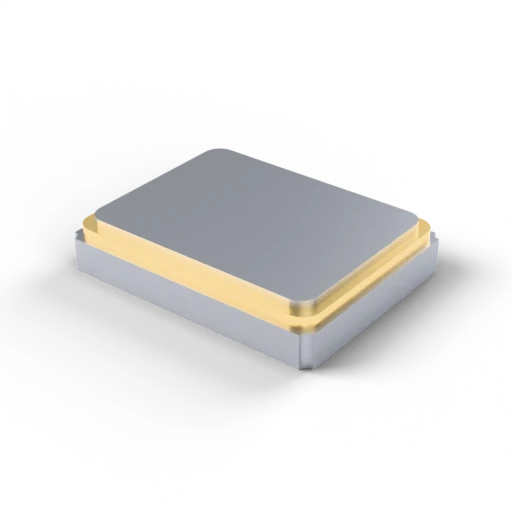
render/out/parts/xtal.webp
