MurderBot1/apriltag-processor/site/screenshots/bom2/bom-desktop-dark-cards.png

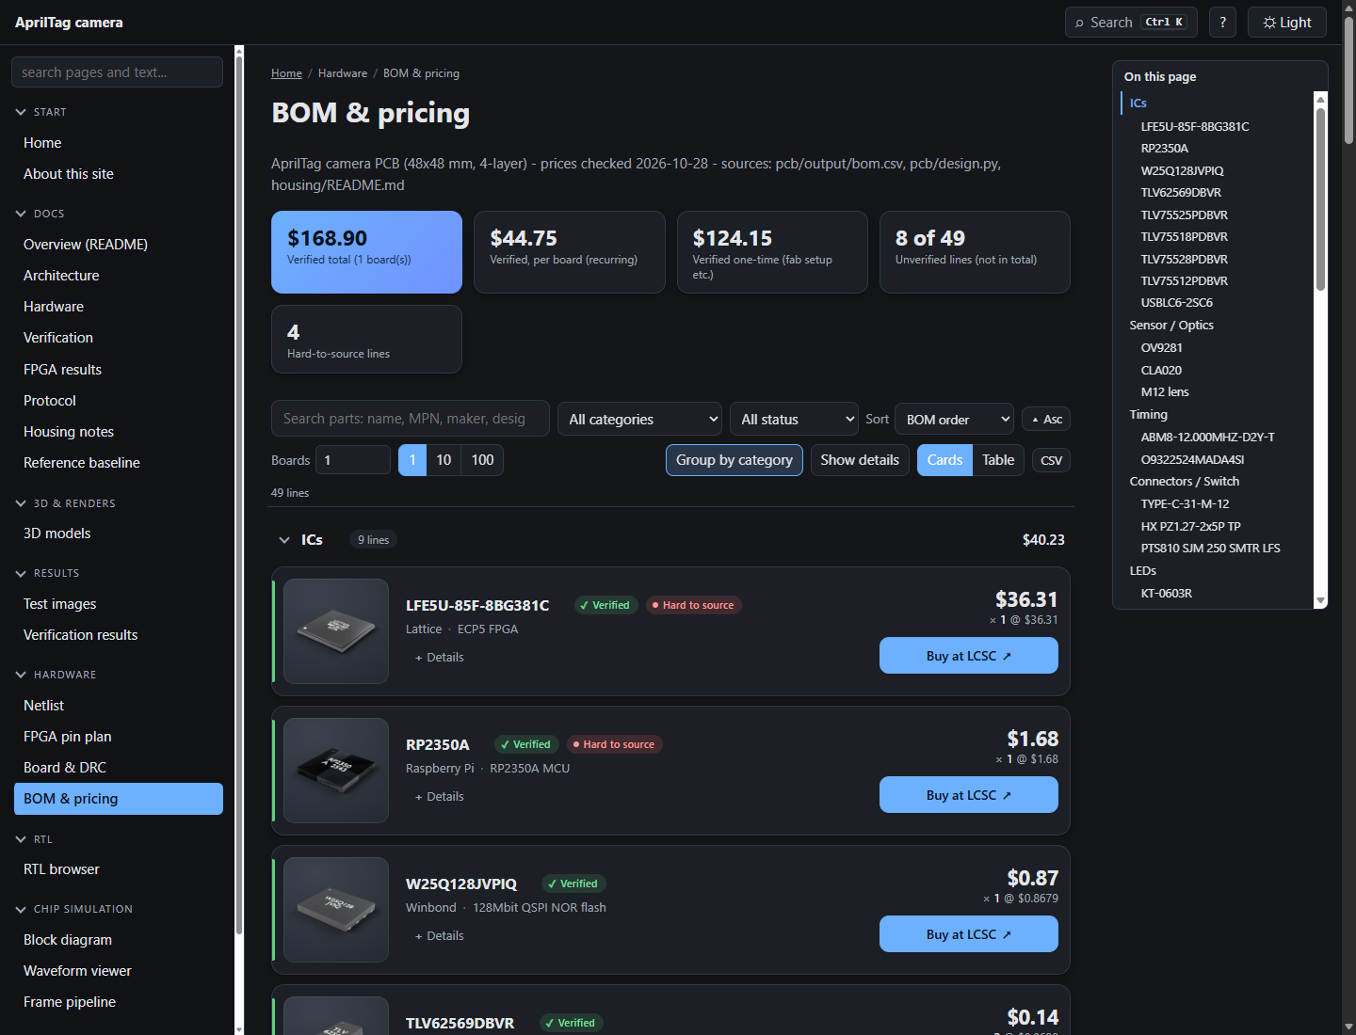
site/screenshots/bom2/bom-desktop-dark-cards.png
