MurderBot1/apriltag-processor/site/screenshots/bom2/bom-desktop-dark-table.png

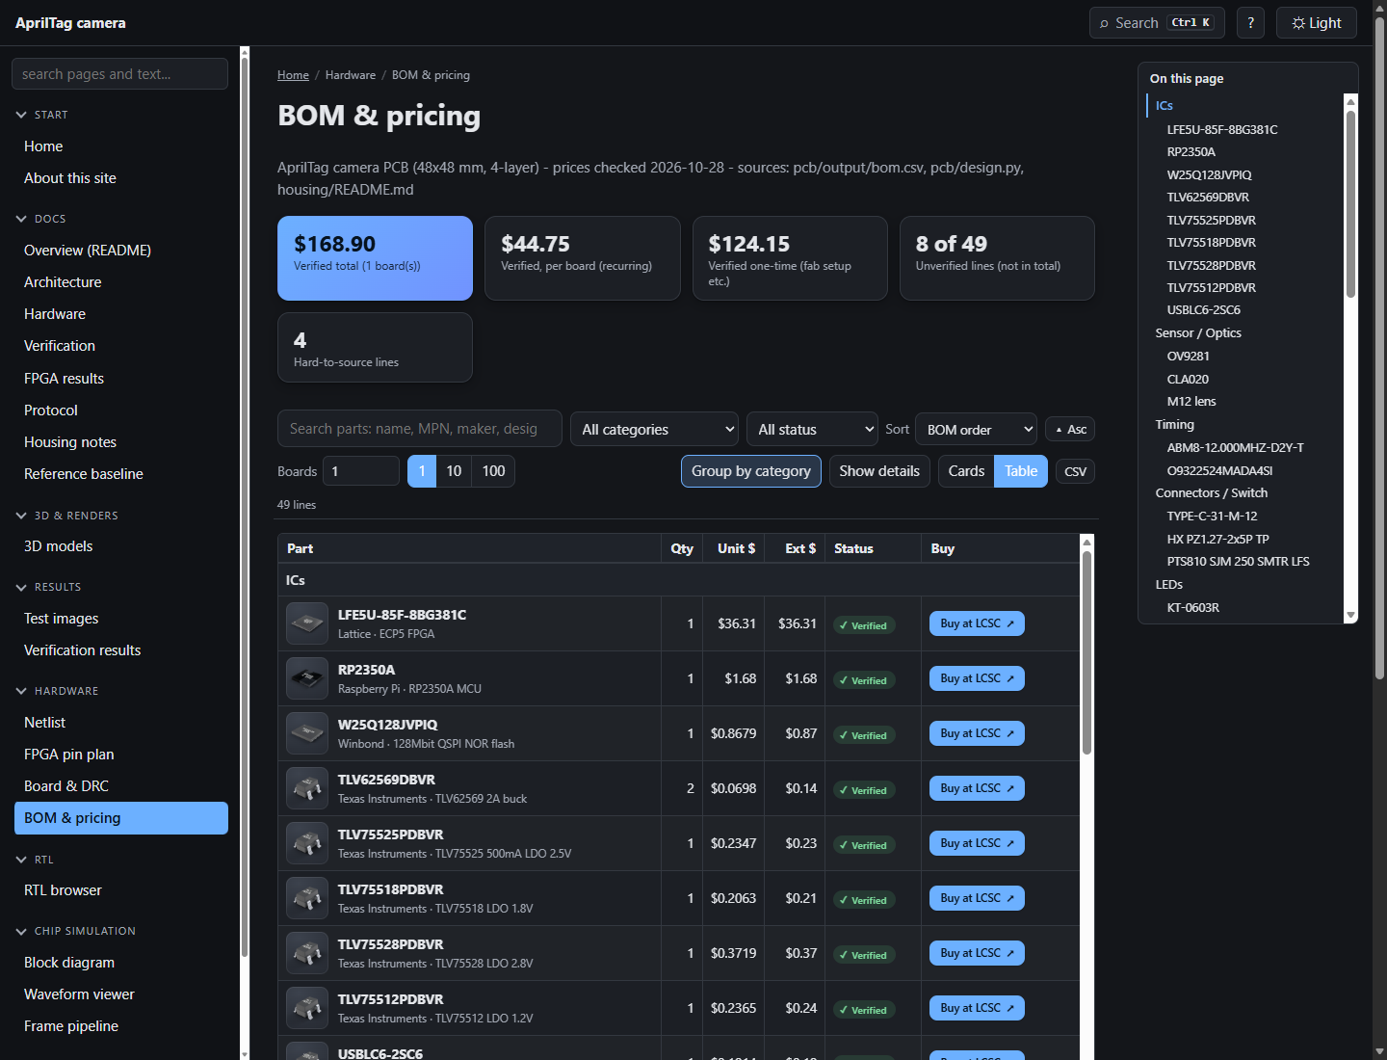
site/screenshots/bom2/bom-desktop-dark-table.png
