MurderBot1/apriltag-processor/site/screenshots/bom2/bom-desktop-light.png

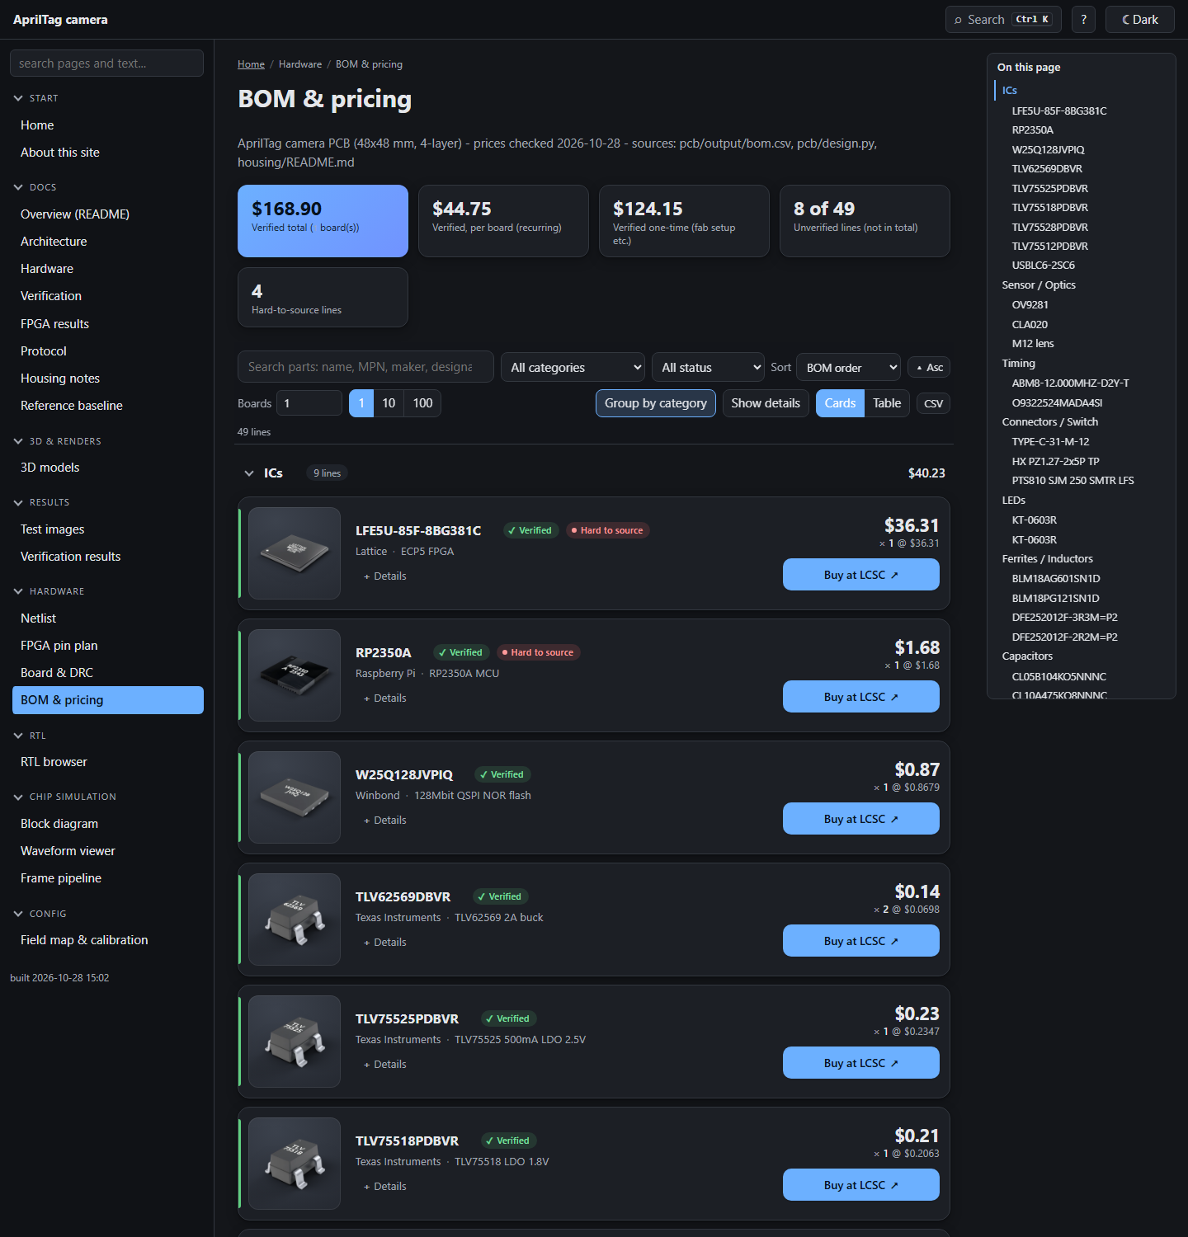
site/screenshots/bom2/bom-desktop-light.png
