MurderBot1/apriltag-processor/site/screenshots/bom2/bom-phone-dark-cards.png

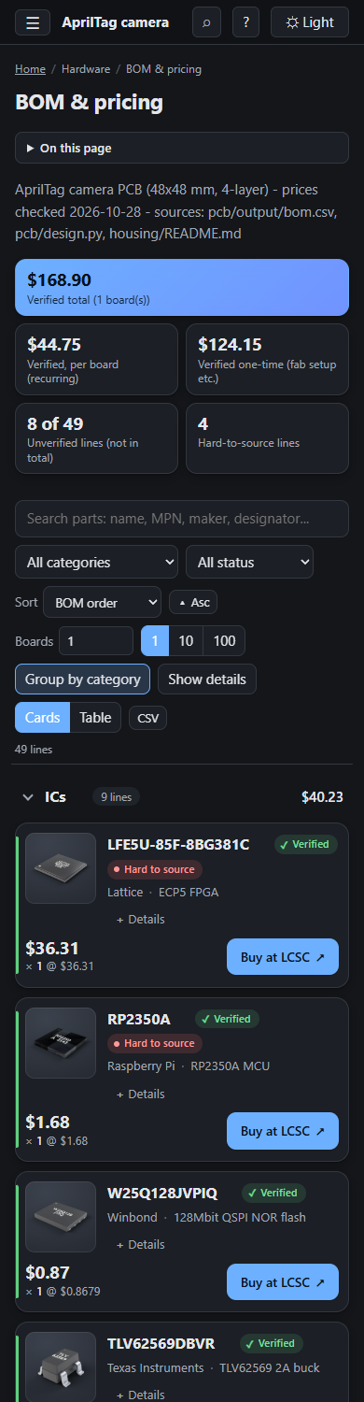
site/screenshots/bom2/bom-phone-dark-cards.png
