MurderBot1/apriltag-processor/site/screenshots/bom2/bom-phone-dark-table.png

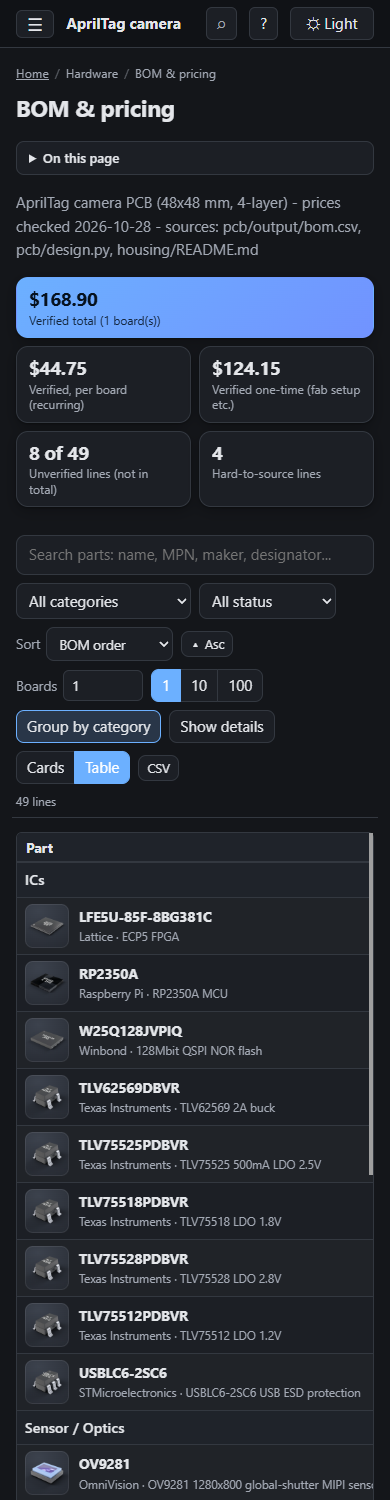
site/screenshots/bom2/bom-phone-dark-table.png
