MurderBot1/apriltag-processor/site/screenshots/bom2/bom-phone-light-cards.png

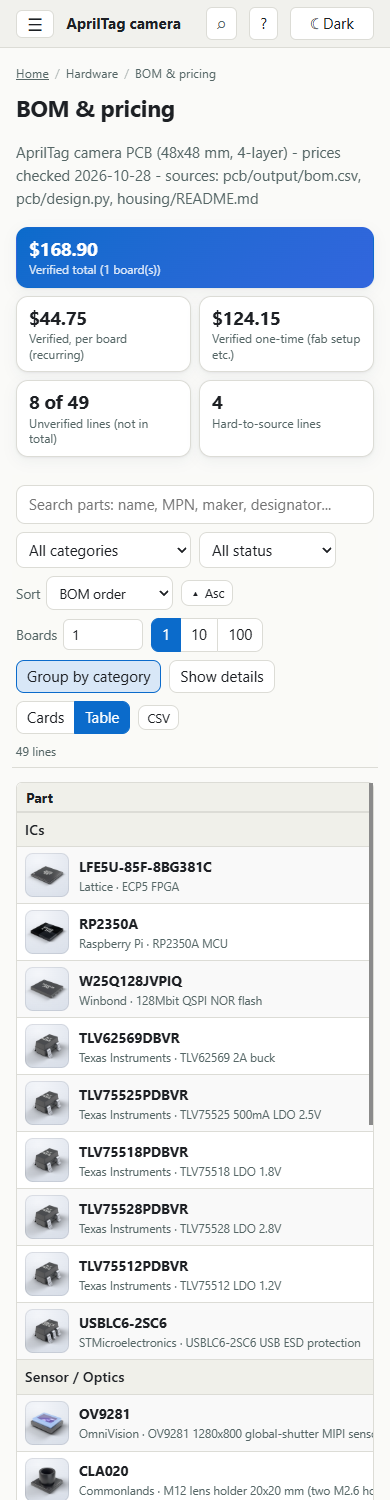
site/screenshots/bom2/bom-phone-light-cards.png
