MurderBot1/apriltag-processor/site/screenshots/bom2/bom-phone-light.png

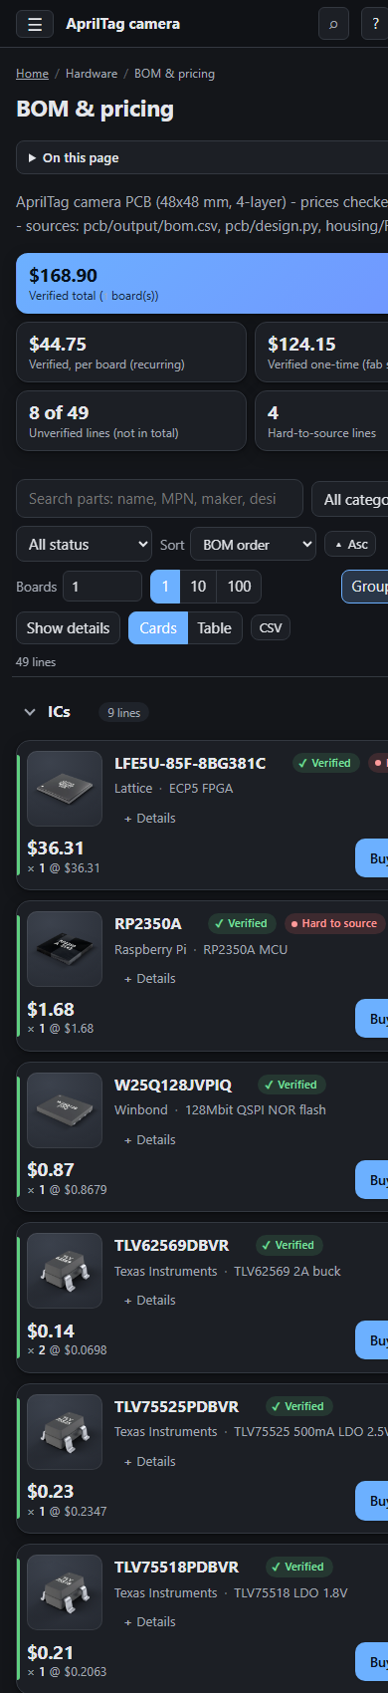
site/screenshots/bom2/bom-phone-light.png
