MurderBot1/apriltag-processor/site/screenshots/bom2/pcb-info-desktop-cap.png

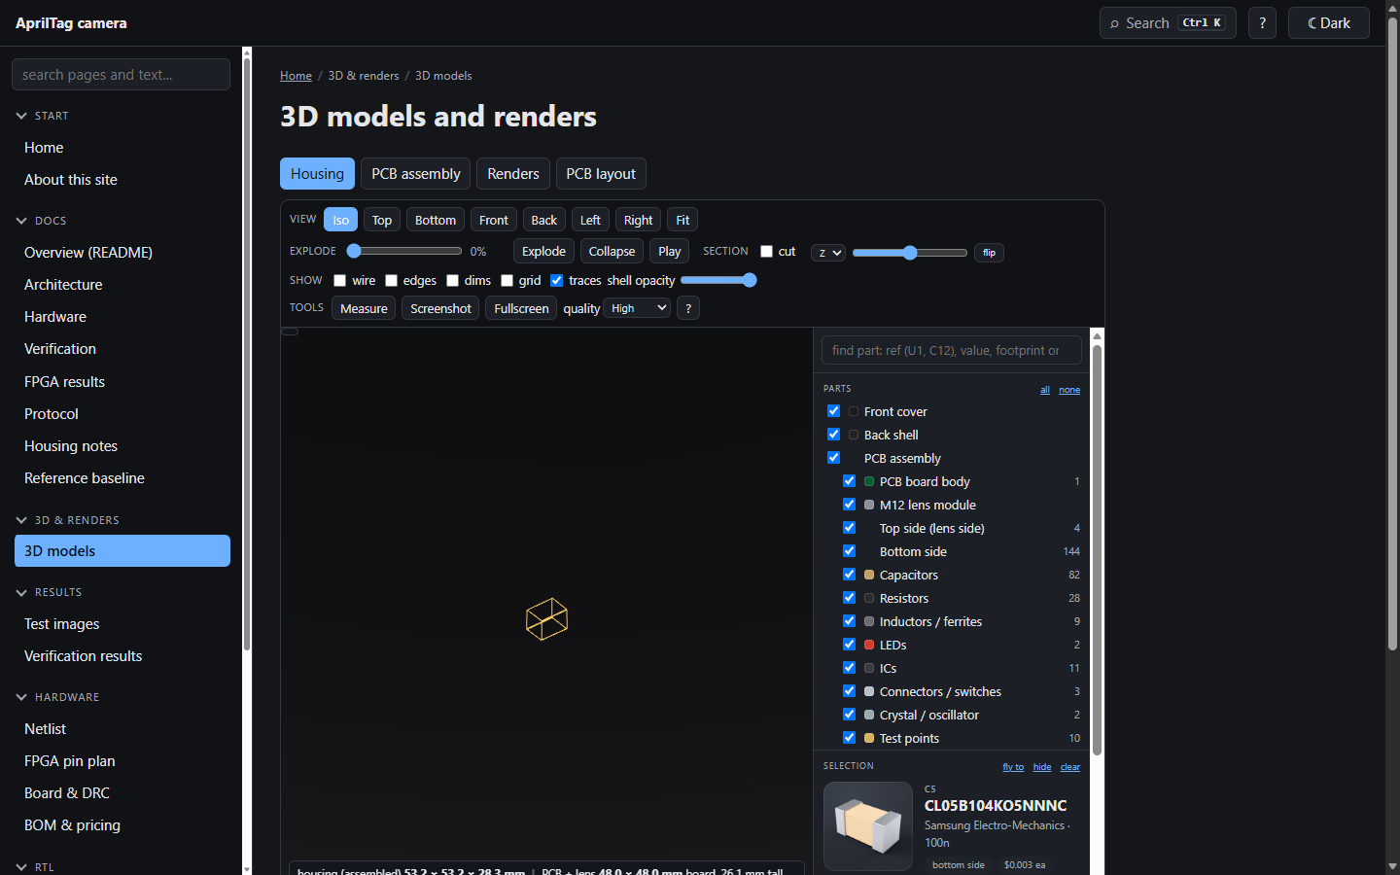
site/screenshots/bom2/pcb-info-desktop-cap.png
