MurderBot1/apriltag-processor/site/screenshots/bom2/pcb-info-desktop-dark.png

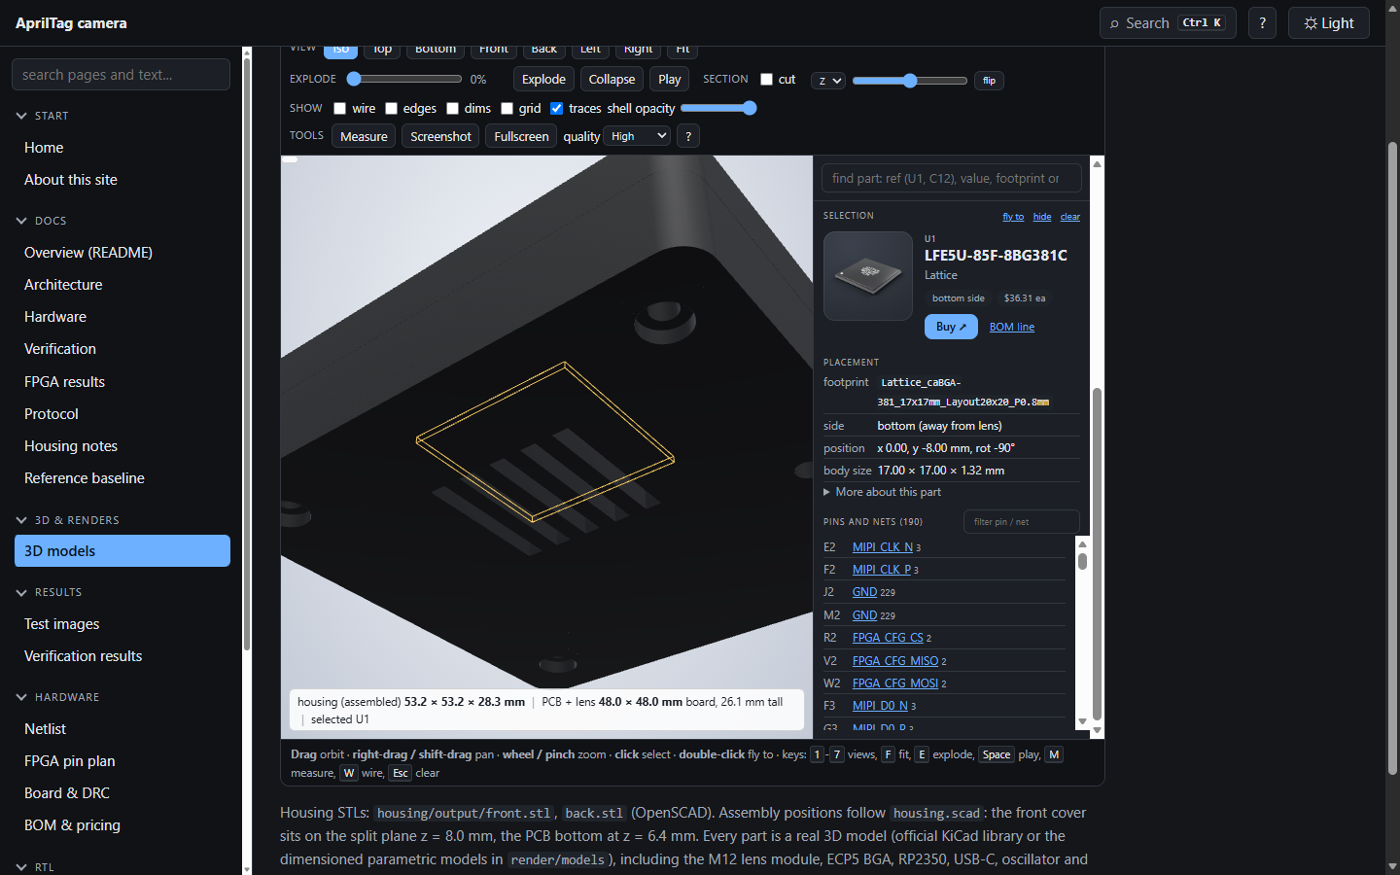
site/screenshots/bom2/pcb-info-desktop-dark.png
