MurderBot1/apriltag-processor/site/screenshots/bom2/pcb-info-desktop-light.png

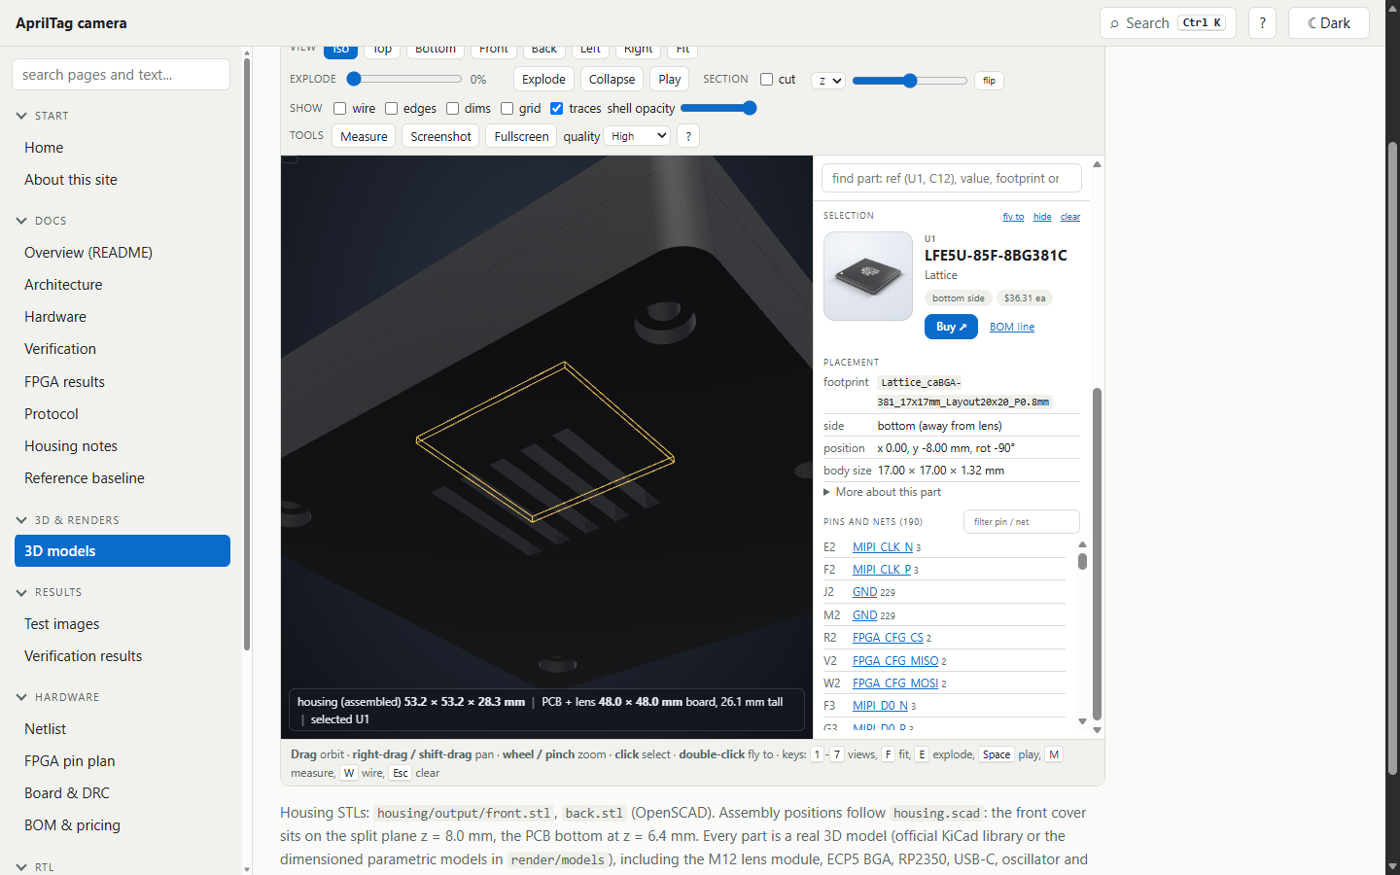
site/screenshots/bom2/pcb-info-desktop-light.png
