MurderBot1/apriltag-processor/site/screenshots/bom2/pcb-info-phone-dark.png

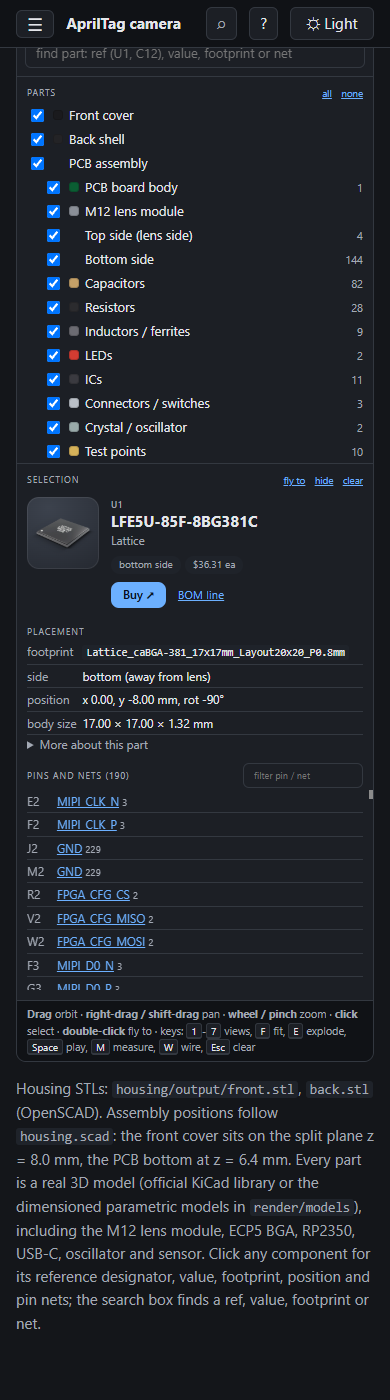
site/screenshots/bom2/pcb-info-phone-dark.png
