MurderBot1/apriltag-processor/site/screenshots/bom2/pcb-info-phone-light.png

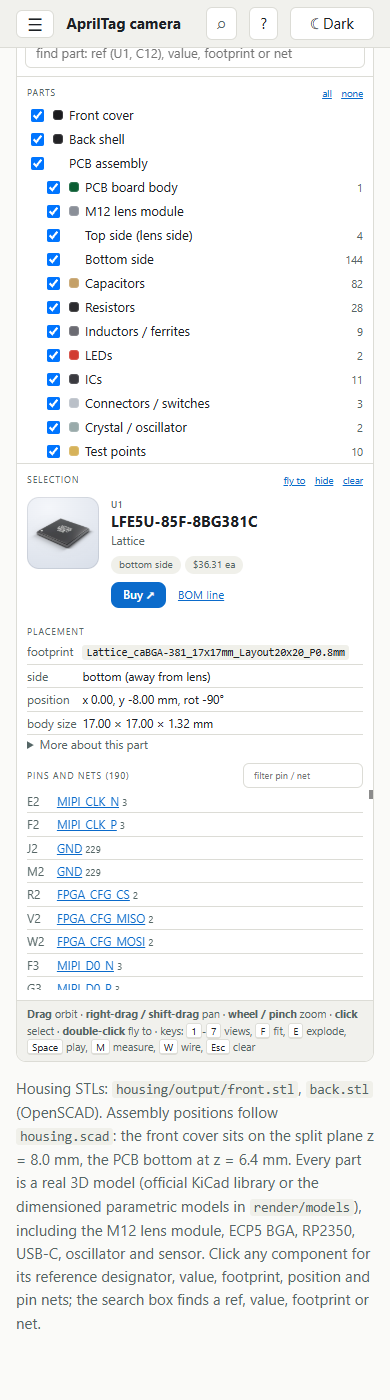
site/screenshots/bom2/pcb-info-phone-light.png
