MurderBot1/apriltag-processor/site/screenshots/bom-390.png

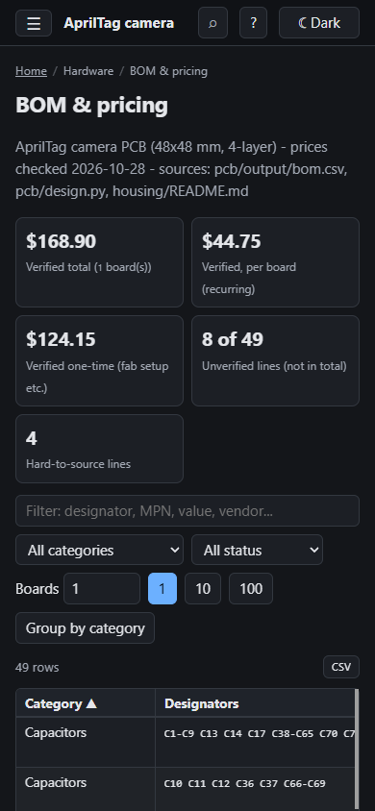
site/screenshots/bom-390.png
