MurderBot1/apriltag-processor/site/screenshots/bom-1440.png

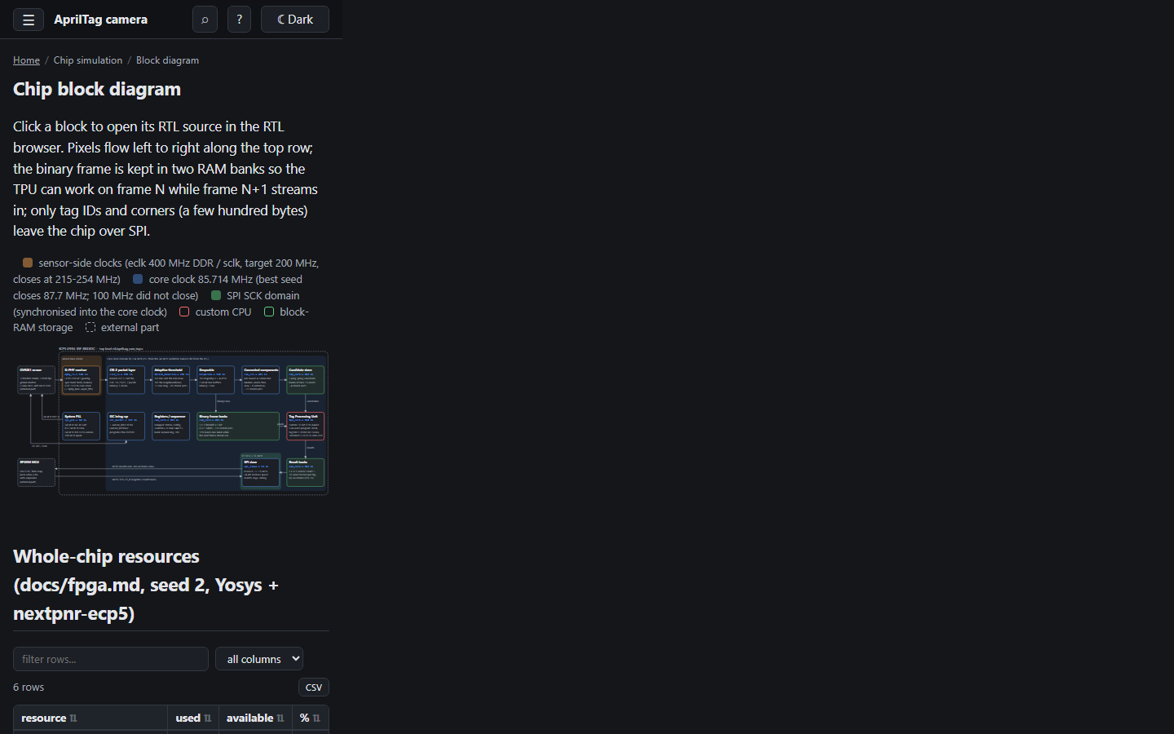
site/screenshots/bom-1440.png
