MurderBot1/apriltag-processor/housing/output/front.stl

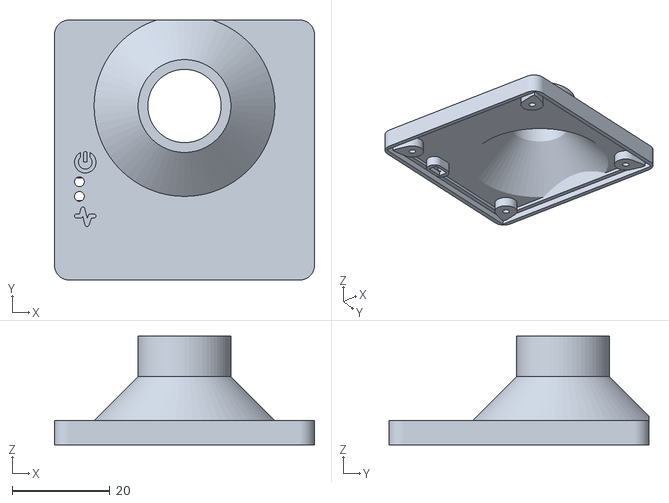
[picture p137: CAD file, 2026-11-01]
housing/output/front.stl
53.2 x 53.2 x 22.3
