MurderBot1/apriltag-processor/render/models/M12_LENS_MOUNT.step

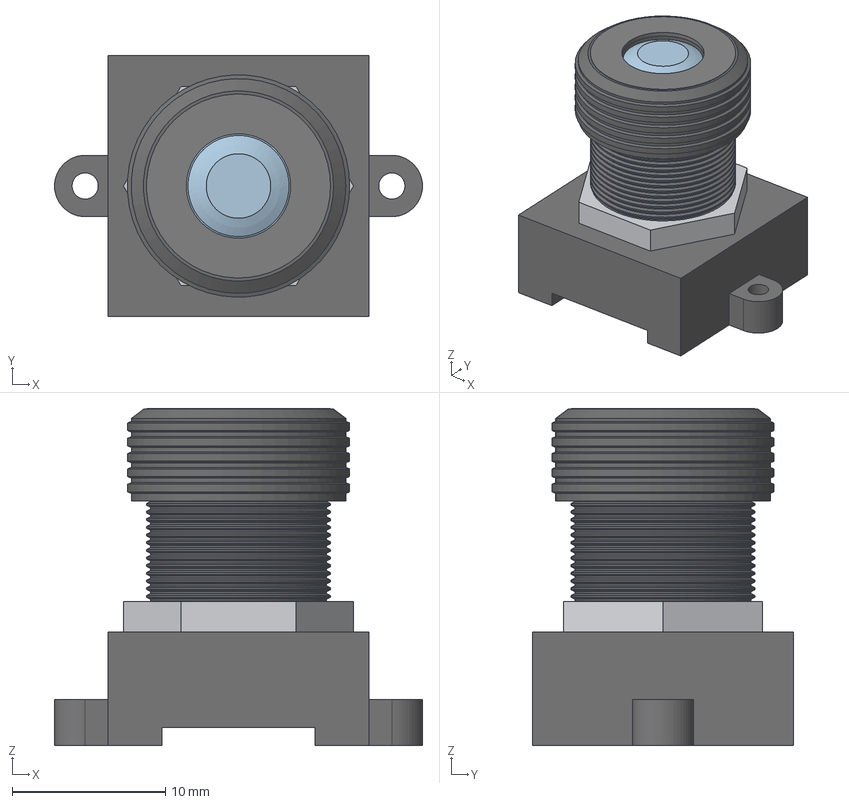
[picture p139: CAD file, 2026-11-01]
render/models/M12_LENS_MOUNT.step
24.0 x 17.0 x 22.0 mm
c0
c1
c2
c3
c4
c5
