MurderBot1/apriltag-processor/render/out/apriltag_housing_pcb_lens.step

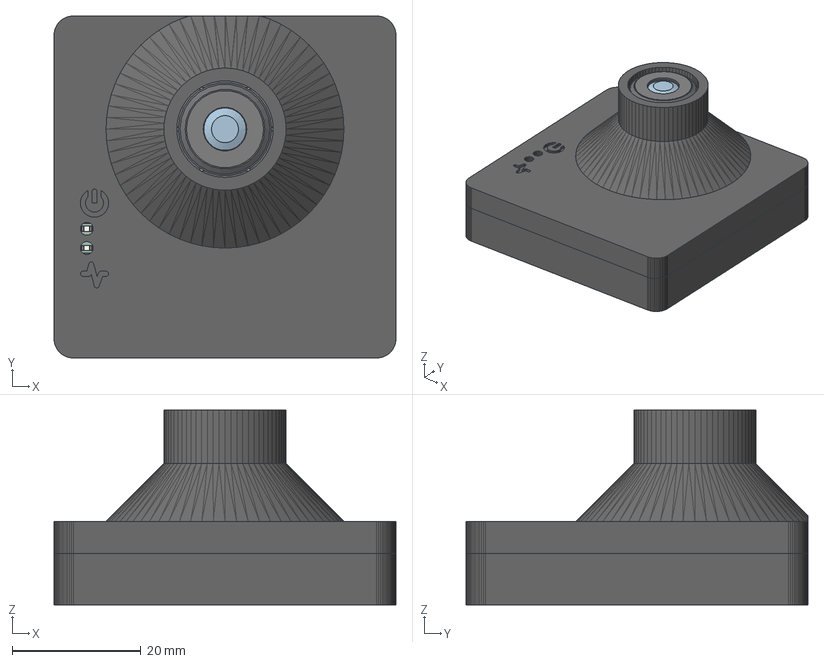
[picture p140: CAD file, 2026-11-01]
render/out/apriltag_housing_pcb_lens.step
53.2 x 53.2 x 30.3 mm
c0 x 16
c1 x 6
c2 x 6
c3 x 6
c4 x 2
c5
LED_0603_1608Metric x 2
R_0402_1005Metric x 28
SOT-23-5 x 6
C_0402_1005Metric x 48
L_0603_1608Metric x 6
SOT-23-6
C_0603_1608Metric x 25
Crystal_SMD_3225-4Pin_3.2x2.5mm
WSON-8-1EP_6x5mm_P1.27mm_EP3.4x4.3mm
C_0805_2012Metric x 9
L_1008_2520Metric x 3
SW_SPST_PTS810
PinHeader_2x05_P127mm_Vertical_SMD
apriltag_cam_assembly_PCB
