MurderBot1/apriltag-processor/housing/output/housing_back.step

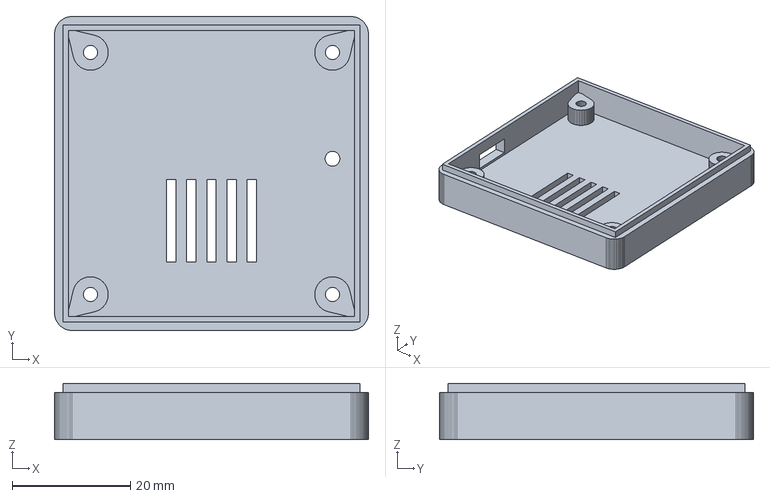
[picture p141: CAD file, 2026-11-01]
housing/output/housing_back.step
53.2 x 53.2 x 9.50 mm
