MurderBot1/apriltag-processor/render/models/OV9281_CSP.step

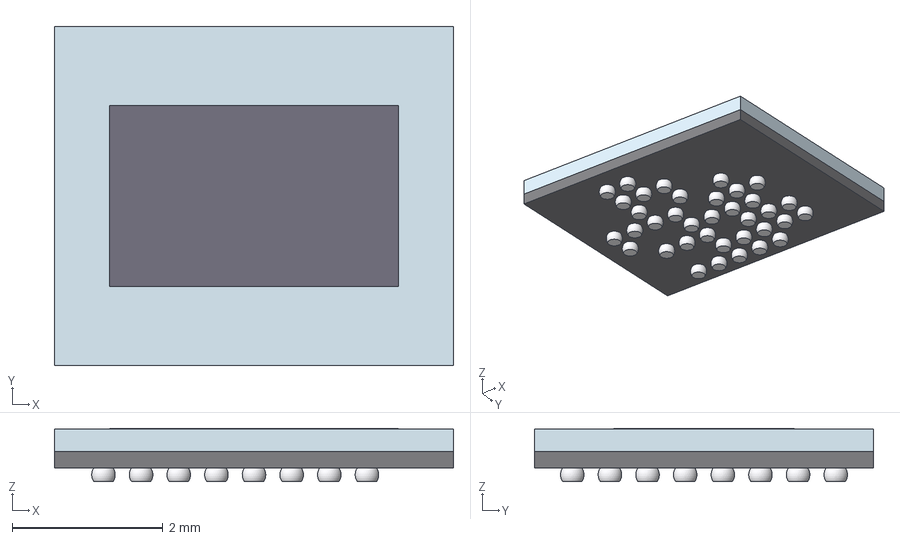
[picture p142: CAD file, 2026-10-31]
render/models/OV9281_CSP.step
5.30 x 4.50 x 0.705 mm
c0
c1
c2
c3
