MurderBot1/apriltag-processor/housing/output/housing.step

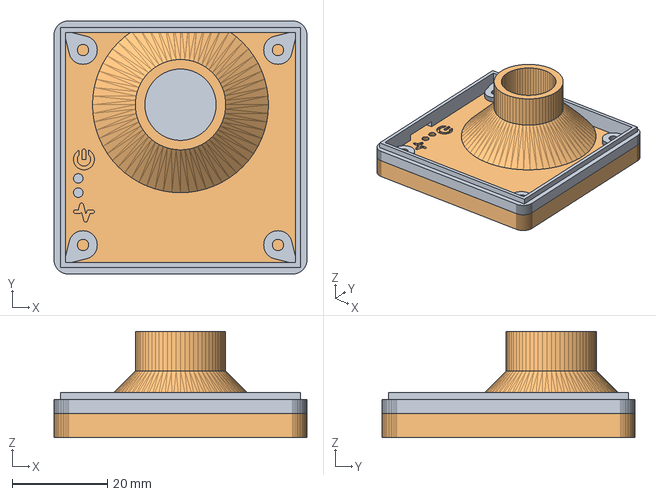
[picture p143: CAD file, 2026-11-01]
housing/output/housing.step
53.2 x 53.2 x 22.3 mm
