MurderBot1/apriltag-processor/render/models/QFN-60-1EP_7x7mm_P0.4mm_EP3.4x3.4mm.step

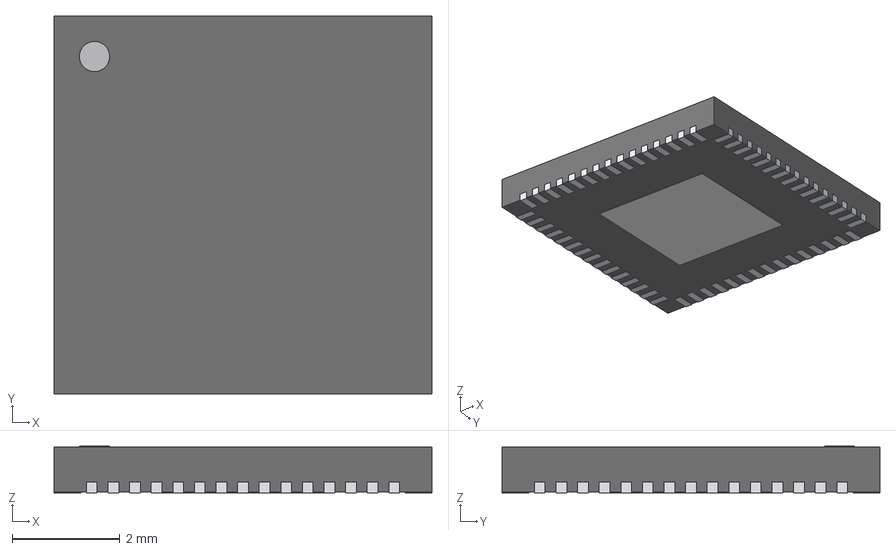
[picture p144: CAD file, 2026-10-31]
render/models/QFN-60-1EP_7x7mm_P0.4mm_EP3.4x3.4mm.step
7.00 x 7.00 x 0.87 mm
c0
c1
c2
c3
