MurderBot1/apriltag-processor/render/models/USB_C_Receptacle_HRO_TYPE-C-31-M-12.step

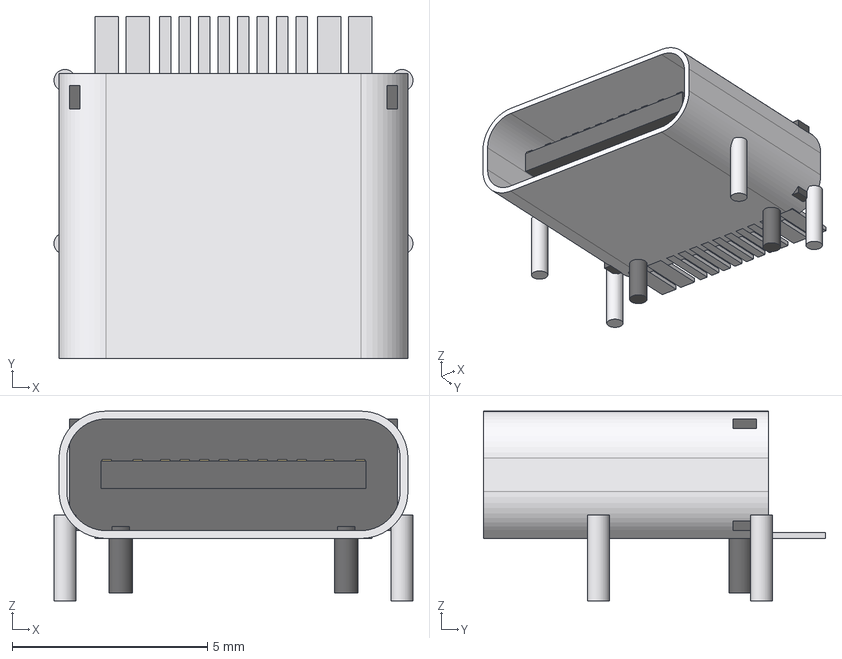
[picture p145: CAD file, 2026-10-31]
render/models/USB_C_Receptacle_HRO_TYPE-C-31-M-12.step
9.20 x 8.77 x 4.86 mm
c0
c1
c2
c3
c4
