MurderBot1/apriltag-processor/render/models/Oscillator_SMD_Abracon_ASE-4Pin_3.2x2.5mm.step

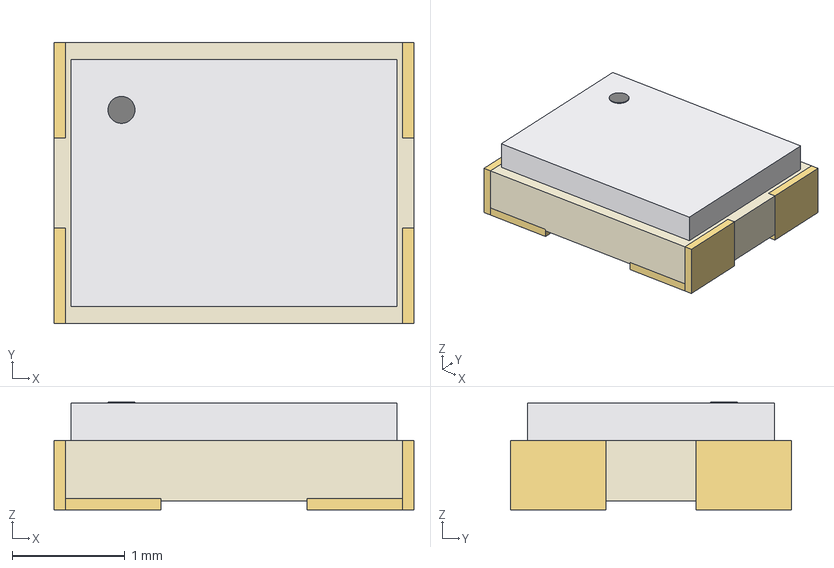
[picture p146: CAD file, 2026-10-31]
render/models/Oscillator_SMD_Abracon_ASE-4Pin_3.2x2.5mm.step
3.20 x 2.50 x 0.96 mm
c0
c1
c2
c3
