MurderBot1/apriltag-processor/render/models/Lattice_caBGA-381_17x17mm_Layout20x20_P0.8mm.step

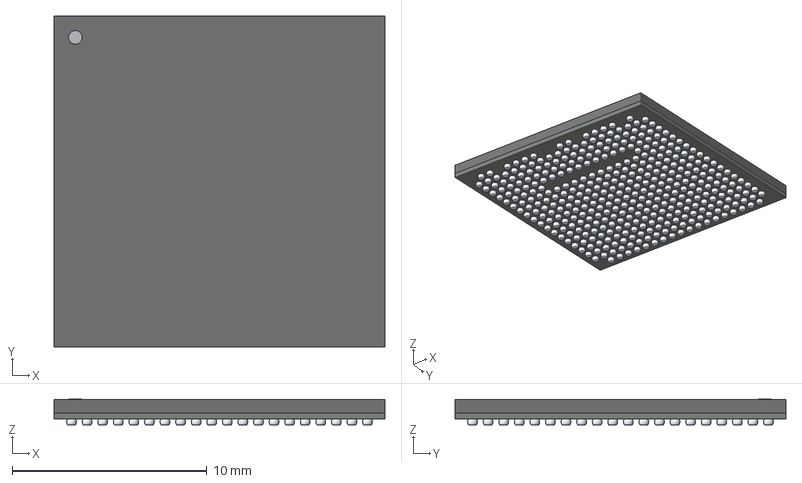
[picture p147: CAD file, 2026-10-31]
render/models/Lattice_caBGA-381_17x17mm_Layout20x20_P0.8mm.step
17.0 x 17.0 x 1.32 mm
c0
c1
c2
c3
