MurderBot1/apriltag-processor/render/models/TestPoint_Pad_D1.0mm.step

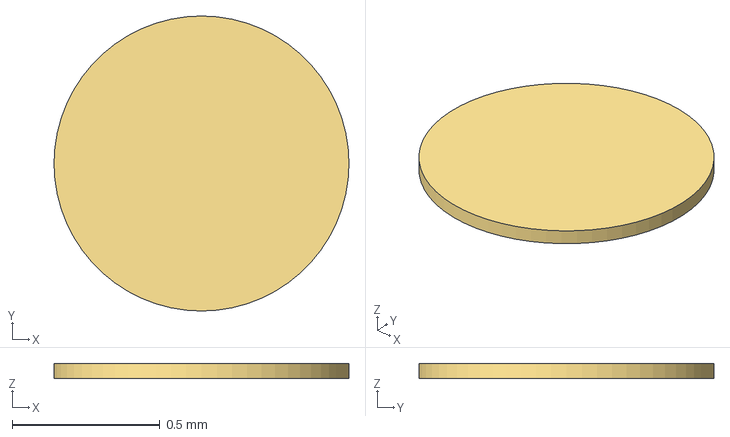
[picture p148: CAD file, 2026-10-31]
render/models/TestPoint_Pad_D1.0mm.step
1.00 x 1.00 x 0.05 mm
