MurderBot1/apriltag-processor/housing/pcb_params.scad

// AUTO-GENERATED by gen_params.py from pcb/pcb_params.json - do not edit
pcb_w = 48.0; pcb_h = 48.0; pcb_t = 1.6;
hole_xy = 20.5; hole_d = 2.2; pad_d = 4.2;
sensor_c = [0.0, 9.0];
sensor_pkg = [5.3, 4.5, 0.7];
holder = [17.0, 17.0, 7.4];
holder_ears = [23.0, 6.0];
barrel_d = 14.0; barrel_h = 14.6;
bot_h = 3.2;
usb_w = 8.94; usb_h = 3.26; usb_c = [-24.0, -8.0];
led_pos = [[-21.5, -6.5], [-21.5, -9.5]];
boot_pos = [20.5, 2.5];
