MurderBot1/apriltag-processor/(list of files, cad)

Other CAD files:
housing/output/housing_front.step
housing/output/back.stl
