MurderBot1/apriltag-processor/housing/output/assembly.png

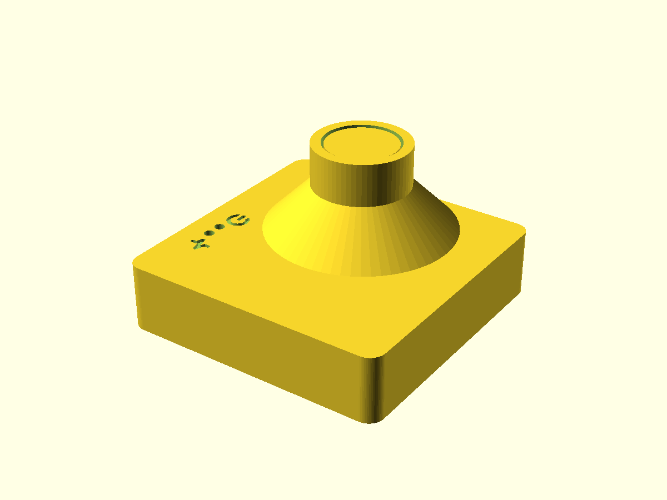
housing/output/assembly.png
