MurderBot1/apriltag-processor/results/ci/bright.md

### category bright: 10/10 detected

over-exposed (light x2-x5.5). Reference detector (pupil-apriltags tag36h11 after undistortion); a frame passes when every ground-truth-detectable tag is found and no false id is reported. The RTL chain is not run in CI (about 40 s per frame).

| image | detectable tags | found | false ids | corner err px | pose err mm | result |
|---|---|---|---|---|---|---|
| bright_000 | 8 | 8 | 0 | 0.40 | 0.7 | pass |
| bright_001 | 9 | 9 | 0 | 0.49 | 0.7 | pass |
| bright_002 | 8 | 8 | 0 | 0.60 | 1.8 | pass |
| bright_003 | 8 | 8 | 0 | 0.67 | 1.2 | pass |
| bright_004 | 8 | 8 | 0 | 0.70 | 1.7 | pass |
| bright_005 | 4 | 4 | 0 | 0.70 | 0.8 | pass |
| bright_006 | 7 | 7 | 0 | 0.91 | 1.1 | pass |
| bright_007 | 9 | 9 | 0 | 0.86 | 1.2 | pass |
| bright_008 | 8 | 8 | 0 | 0.88 | 3.0 | pass |
| bright_009 | 9 | 9 | 0 | 0.95 | 2.6 | pass |
