MurderBot1/apriltag-processor/results/ci/grad.md

### category grad: 10/10 detected

uneven illumination (strong left/right gradient). Reference detector (pupil-apriltags tag36h11 after undistortion); a frame passes when every ground-truth-detectable tag is found and no false id is reported. The RTL chain is not run in CI (about 40 s per frame).

| image | detectable tags | found | false ids | corner err px | pose err mm | result |
|---|---|---|---|---|---|---|
| grad_000 | 6 | 6 | 0 | 0.28 | 0.6 | pass |
| grad_001 | 8 | 8 | 0 | 0.28 | 0.5 | pass |
| grad_002 | 4 | 4 | 0 | 0.29 | 0.4 | pass |
| grad_003 | 8 | 8 | 0 | 0.29 | 0.6 | pass |
| grad_004 | 8 | 8 | 0 | 0.29 | 0.5 | pass |
| grad_005 | 9 | 9 | 0 | 0.31 | 0.6 | pass |
| grad_006 | 6 | 6 | 0 | 0.29 | 0.7 | pass |
| grad_007 | 4 | 4 | 0 | 0.27 | 0.3 | pass |
| grad_008 | 6 | 6 | 0 | 0.27 | 0.2 | pass |
| grad_009 | 7 | 7 | 0 | 0.29 | 0.7 | pass |
