MurderBot1/apriltag-processor/results/ci/normal.md

### category normal: 10/10 detected

clean baseline, nominal light, 0.8-3.8 m. Reference detector (pupil-apriltags tag36h11 after undistortion); a frame passes when every ground-truth-detectable tag is found and no false id is reported. The RTL chain is not run in CI (about 40 s per frame).

| image | detectable tags | found | false ids | corner err px | pose err mm | result |
|---|---|---|---|---|---|---|
| normal_000 | 3 | 3 | 0 | 0.30 | 0.3 | pass |
| normal_001 | 1 | 1 | 0 | 0.23 | 4.8 | pass |
| normal_002 | 2 | 2 | 0 | 0.24 | 5.0 | pass |
| normal_003 | 2 | 2 | 0 | 0.27 | 6.1 | pass |
| normal_004 | 4 | 4 | 0 | 0.29 | 0.5 | pass |
| normal_005 | 8 | 8 | 0 | 0.26 | 0.6 | pass |
| normal_006 | 6 | 6 | 0 | 0.28 | 0.5 | pass |
| normal_007 | 8 | 8 | 0 | 0.27 | 0.8 | pass |
| normal_008 | 9 | 9 | 0 | 0.29 | 0.8 | pass |
| normal_009 | 9 | 9 | 0 | 0.28 | 2.0 | pass |
