MurderBot1/apriltag-processor/results/reference_baseline.md

# Reference pipeline baseline

undistort -> pupil-apriltags tag36h11 -> SQPnP + LM over all detected tag corners.

A tag is *detectable* when it faces the camera, is fully inside the frame, is >= 10 px wide, is within 75 deg of the camera axis, is <= 50 % occluded and is not washed out / flat in the image (tools/dataset_gt.py). Rates are detected / detectable; `vis` = legacy geometric visibility (facing + inside the frame) is kept for comparison with the old geometric-visibility numbers.

Overall: 560 / 570 detectable tags detected (98.2%); legacy vis: 560 / 575; false-ID detections 5.

## Per category

| cat | imgs | detectable | det | rate (detectable) | vis | rate (vis) | false | corner mean/med/max px | pose imgs | t mean/max mm | rot mean/max deg |
|---|---|---|---|---|---|---|---|---|---|---|---|
| blur | 10 | 52 | 49 | 0.94 | 52 | 0.94 | 0 | 0.35/0.29/1.65 | 10 | 2.0/7.9 | 0.065/0.257 |
| bright | 10 | 78 | 78 | 1.00 | 78 | 1.00 | 0 | 0.72/0.72/2.32 | 10 | 1.5/3.0 | 0.026/0.061 |
| clutter | 10 | 51 | 51 | 1.00 | 52 | 0.98 | 2 | 0.29/0.28/0.74 | 10 | 1.7/8.7 | 0.057/0.296 |
| dark | 10 | 59 | 59 | 1.00 | 59 | 1.00 | 1 | 0.28/0.27/0.65 | 10 | 0.7/2.6 | 0.023/0.137 |
| grad | 10 | 66 | 66 | 1.00 | 66 | 1.00 | 0 | 0.29/0.29/0.70 | 10 | 0.5/0.7 | 0.012/0.019 |
| lowcon | 10 | 54 | 54 | 1.00 | 54 | 1.00 | 1 | 0.33/0.31/0.75 | 10 | 1.8/8.7 | 0.064/0.392 |
| noise | 10 | 50 | 50 | 1.00 | 50 | 1.00 | 0 | 0.30/0.30/0.91 | 10 | 1.6/4.0 | 0.058/0.176 |
| normal | 10 | 52 | 52 | 1.00 | 52 | 1.00 | 0 | 0.28/0.28/0.61 | 10 | 2.1/6.1 | 0.079/0.254 |
| persp | 10 | 66 | 62 | 0.94 | 70 | 0.89 | 1 | 0.32/0.31/2.55 | 10 | 1.1/3.7 | 0.030/0.144 |
| shadow | 10 | 42 | 39 | 0.93 | 42 | 0.93 | 0 | 0.30/0.28/1.22 | 10 | 5.7/19.8 | 0.134/0.368 |

## Detectable tags the reference missed (10)

| image | tag | px width | incidence deg | occ | sat | contrast |
|---|---|---|---|---|---|---|
| blur_009 | 3 | 40.0 | 41.5 | 0.00 | 0.00 | 102 |
| blur_009 | 77 | 39.8 | 43.4 | 0.00 | 0.00 | 97 |
| blur_009 | 101 | 50.4 | 31.1 | 0.00 | 0.00 | 103 |
| persp_008 | 17 | 16.4 | 74.5 | 0.00 | 0.00 | 145 |
| persp_008 | 101 | 12.2 | 74.0 | 0.00 | 0.00 | 136 |
| persp_009 | 77 | 42.1 | 73.9 | 0.00 | 0.00 | 141 |
| persp_009 | 101 | 40.0 | 74.1 | 0.00 | 0.00 | 138 |
| shadow_002 | 311 | 44.2 | 49.4 | 0.00 | 0.00 | 176 |
| shadow_006 | 58 | 54.6 | 35.9 | 0.13 | 0.00 | 138 |
| shadow_008 | 250 | 67.7 | 33.6 | 0.00 | 0.00 | 183 |

## Detections of tags not geometrically visible / unknown ids (n_false > 0): [('clutter_000', 1), ('clutter_007', 1), ('dark_004', 1), ('lowcon_003', 1), ('persp_000', 1)]

Tags flagged undetectable but still found by the reference: 0

## Per image

| image | vis | detectable | det | corner mean px | rms px | t err mm | rot err deg |
|---|---|---|---|---|---|---|---|
| blur_000 | 8 | 8 | 8 | 0.33 | 0.32 | 0.6 | 0.016 |
| blur_001 | 2 | 2 | 2 | 0.19 | 0.21 | 0.9 | 0.040 |
| blur_002 | 7 | 7 | 7 | 0.37 | 0.32 | 0.4 | 0.015 |
| blur_003 | 5 | 5 | 5 | 0.28 | 0.27 | 0.7 | 0.019 |
| blur_004 | 8 | 8 | 8 | 0.36 | 0.32 | 1.1 | 0.027 |
| blur_005 | 3 | 3 | 3 | 0.55 | 0.39 | 7.9 | 0.257 |
| blur_006 | 2 | 2 | 2 | 0.19 | 0.20 | 1.9 | 0.093 |
| blur_007 | 2 | 2 | 2 | 0.24 | 0.22 | 2.2 | 0.087 |
| blur_008 | 7 | 7 | 7 | 0.32 | 0.35 | 0.7 | 0.013 |
| blur_009 | 8 | 8 | 5 | 0.47 | 0.50 | 3.3 | 0.084 |
| bright_000 | 8 | 8 | 8 | 0.40 | 0.40 | 0.7 | 0.014 |
| bright_001 | 9 | 9 | 9 | 0.49 | 0.50 | 0.7 | 0.012 |
| bright_002 | 8 | 8 | 8 | 0.60 | 0.61 | 1.8 | 0.030 |
| bright_003 | 8 | 8 | 8 | 0.67 | 0.67 | 1.2 | 0.020 |
| bright_004 | 8 | 8 | 8 | 0.70 | 0.71 | 1.7 | 0.035 |
| bright_005 | 4 | 4 | 4 | 0.70 | 0.71 | 0.8 | 0.016 |
| bright_006 | 7 | 7 | 7 | 0.91 | 0.80 | 1.1 | 0.024 |
| bright_007 | 9 | 9 | 9 | 0.86 | 0.86 | 1.2 | 0.015 |
| bright_008 | 8 | 8 | 8 | 0.88 | 0.89 | 3.0 | 0.061 |
| bright_009 | 9 | 9 | 9 | 0.95 | 0.98 | 2.6 | 0.037 |
| clutter_000 | 4 | 4 | 4 | 0.28 | 0.29 | 0.6 | 0.012 |
| clutter_001 | 2 | 2 | 2 | 0.22 | 0.21 | 8.7 | 0.296 |
| clutter_002 | 5 | 5 | 5 | 0.32 | 0.28 | 0.4 | 0.008 |
| clutter_003 | 6 | 6 | 6 | 0.27 | 0.26 | 0.4 | 0.005 |
| clutter_004 | 2 | 2 | 2 | 0.37 | 0.37 | 5.2 | 0.204 |
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
| shadow_005 | 9 | 9 | 9 | 0.32 | 0.31 | 0.3 | 0.002 |
| shadow_006 | 6 | 6 | 5 | 0.29 | 0.28 | 0.6 | 0.010 |
| shadow_007 | 8 | 8 | 8 | 0.27 | 0.28 | 0.6 | 0.009 |
| shadow_008 | 2 | 2 | 1 | 0.26 | 0.05 | 6.4 | 0.227 |
| shadow_009 | 1 | 1 | 1 | 0.30 | 0.02 | 6.5 | 0.054 |
