MurderBot1/apriltag-processor/results/dataset_contact_sheet.png

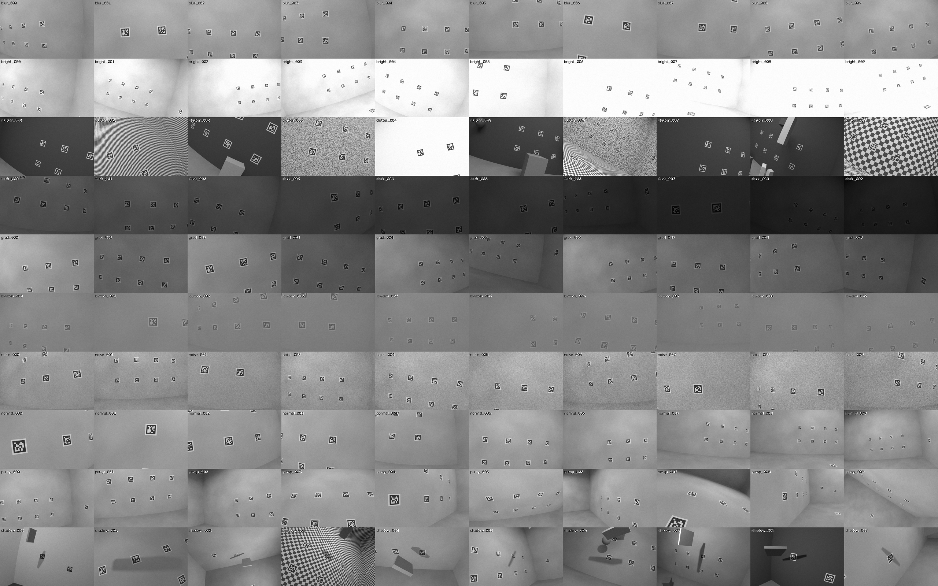
results/dataset_contact_sheet.png
