MurderBot1/apriltag-processor/test_images/sensor/blur_000.png

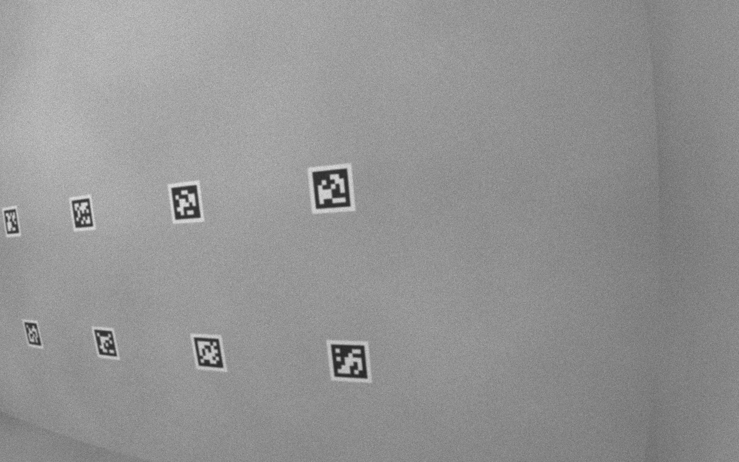
test_images/sensor/blur_000.png
