MurderBot1/apriltag-processor/test_images/sensor/blur_001.png

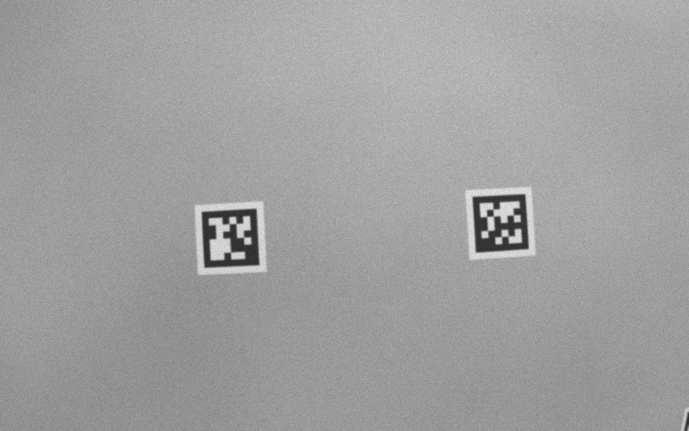
test_images/sensor/blur_001.png
