MurderBot1/apriltag-processor/test_images/sensor/blur_002.png

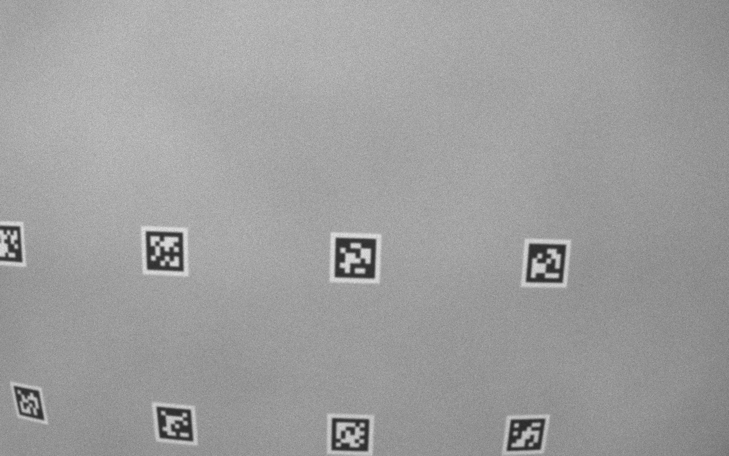
test_images/sensor/blur_002.png
