MurderBot1/apriltag-processor/test_images/sensor/blur_003.png

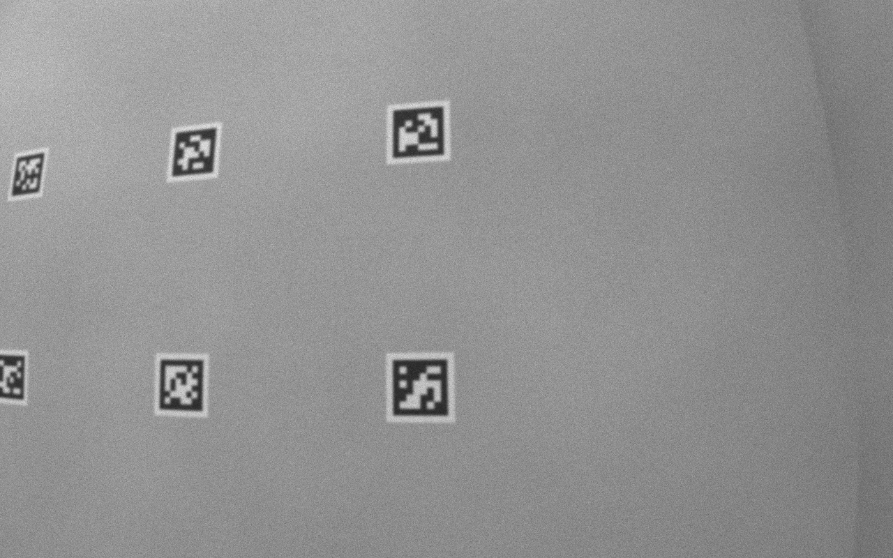
test_images/sensor/blur_003.png
