MurderBot1/apriltag-processor/test_images/sensor/blur_004.png

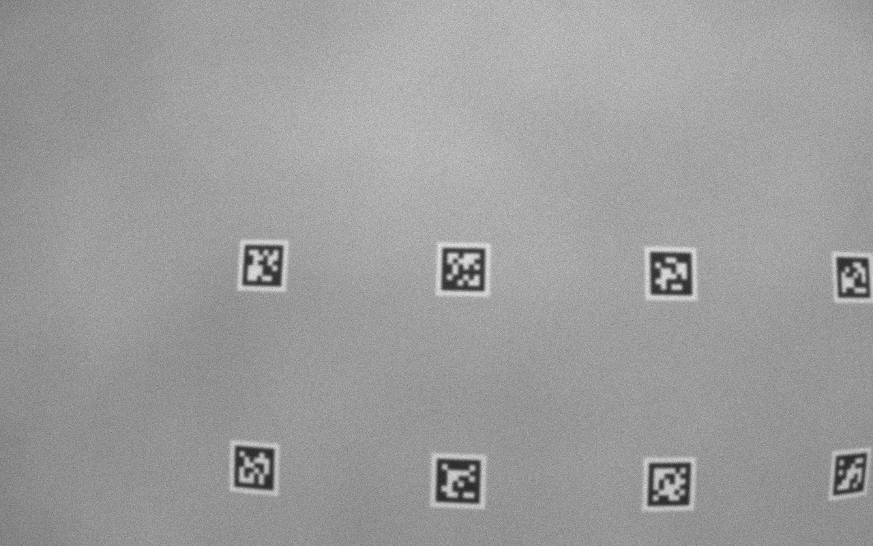
test_images/sensor/blur_004.png
