MurderBot1/apriltag-processor/test_images/sensor/blur_005.png

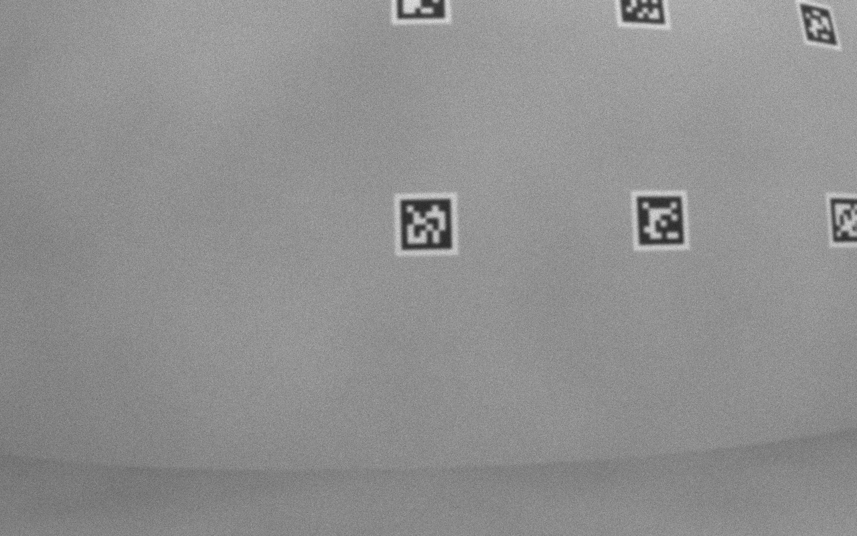
test_images/sensor/blur_005.png
