MurderBot1/apriltag-processor/test_images/sensor/blur_006.png

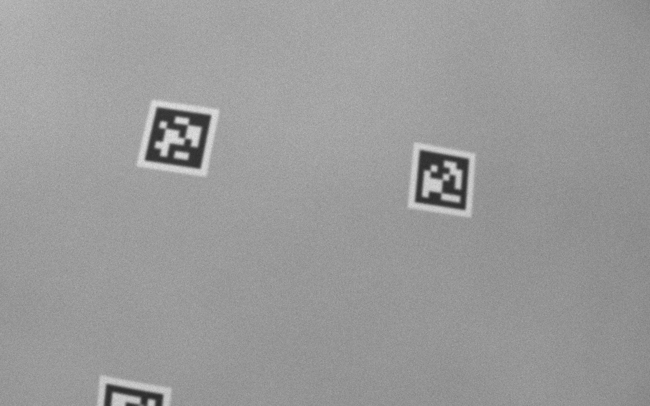
test_images/sensor/blur_006.png
