MurderBot1/apriltag-processor/test_images/sensor/blur_007.png

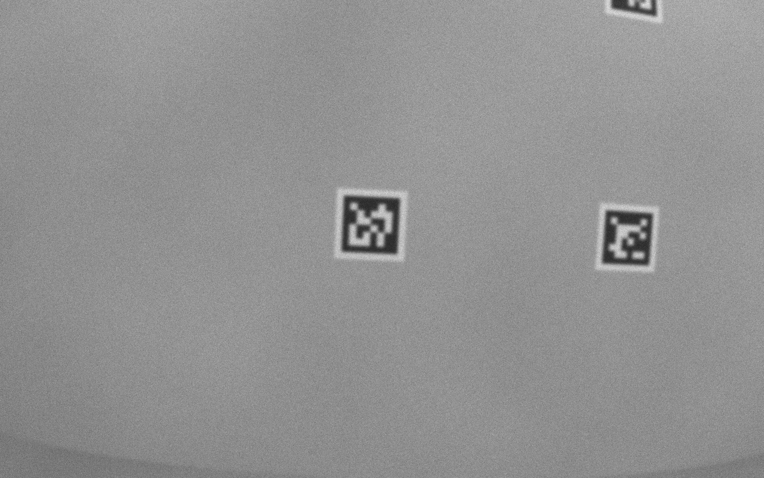
test_images/sensor/blur_007.png
