MurderBot1/apriltag-processor/test_images/sensor/blur_008.png

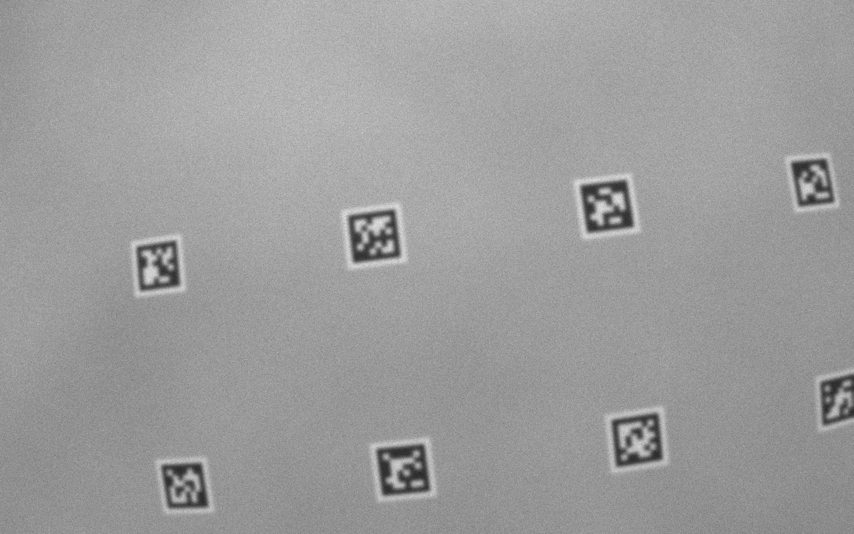
test_images/sensor/blur_008.png
