MurderBot1/apriltag-processor/test_images/sensor/blur_009.png

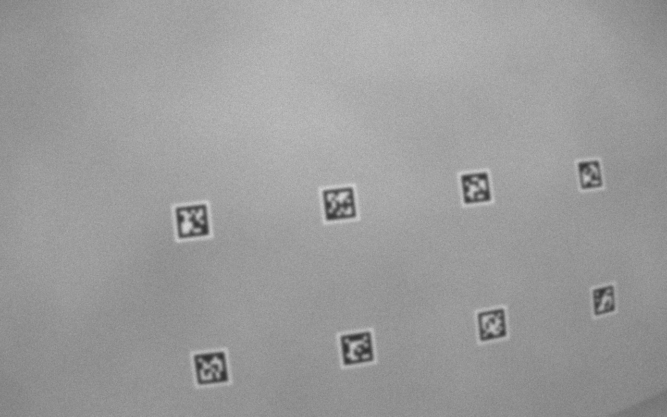
test_images/sensor/blur_009.png
