MurderBot1/apriltag-processor/test_images/sensor/bright_000.png

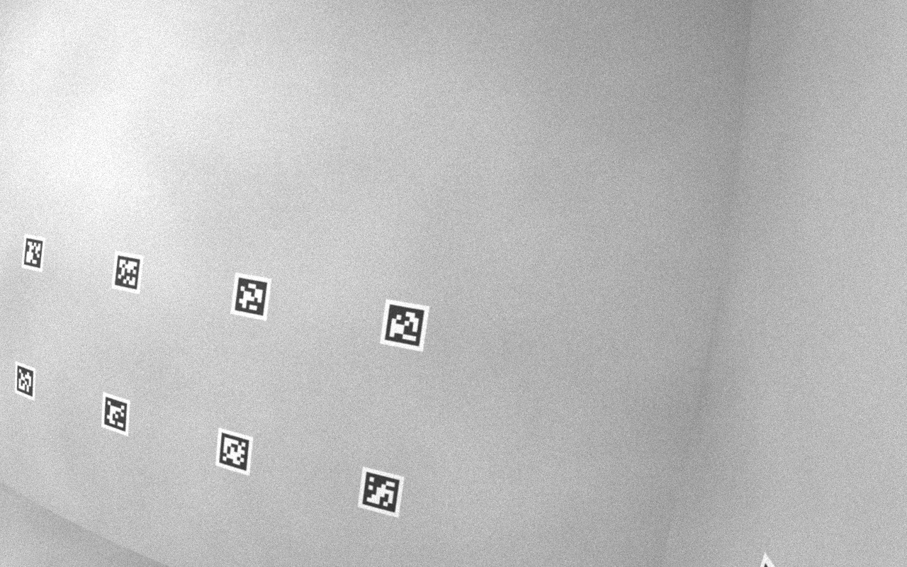
test_images/sensor/bright_000.png
