MurderBot1/apriltag-processor/test_images/sensor/bright_001.png

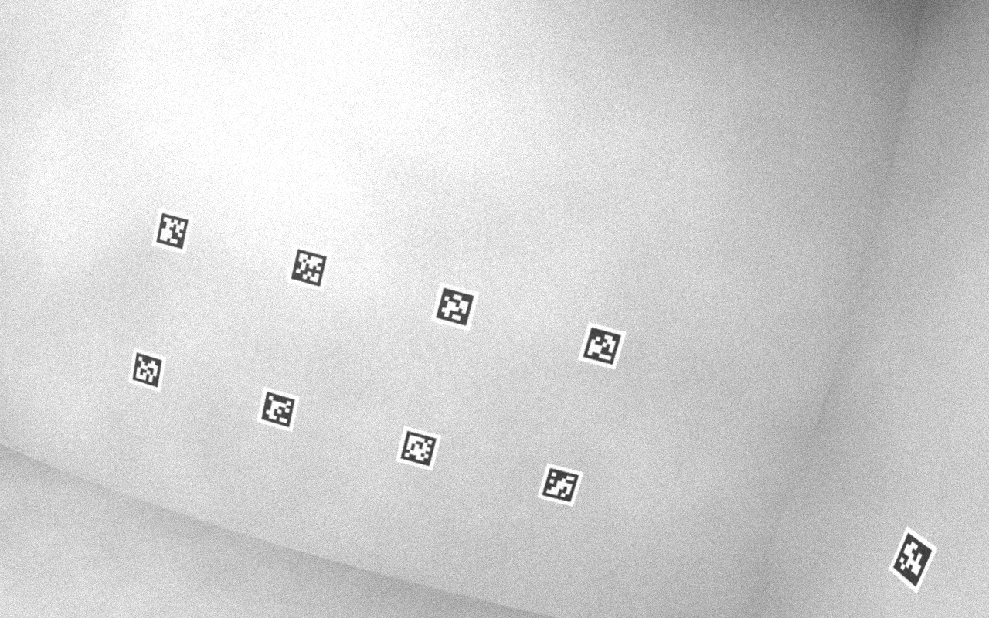
test_images/sensor/bright_001.png
