MurderBot1/apriltag-processor/test_images/sensor/bright_002.png

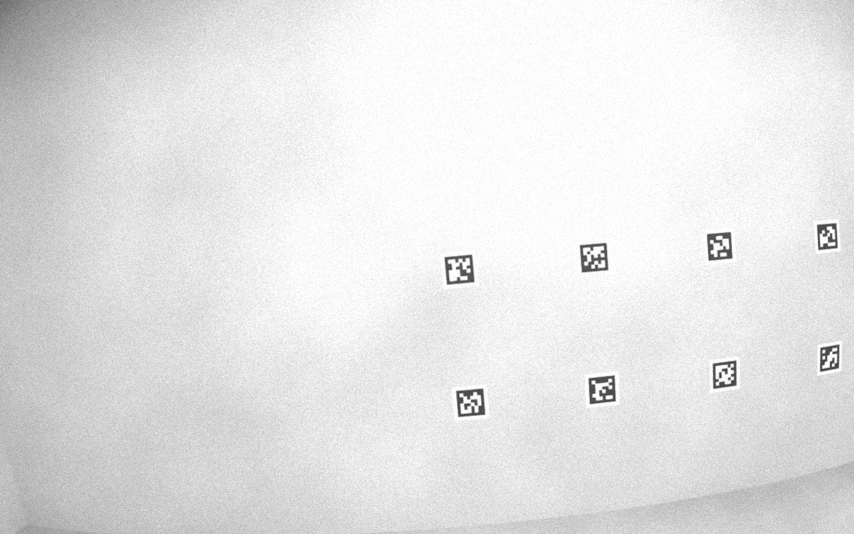
test_images/sensor/bright_002.png
