MurderBot1/apriltag-processor/test_images/sensor/bright_003.png

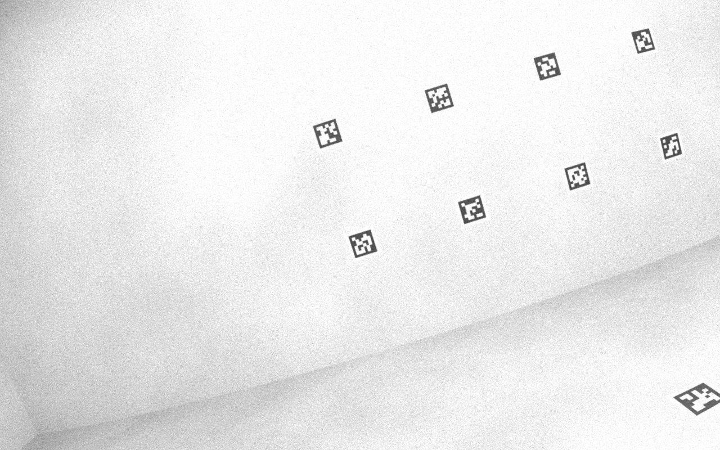
test_images/sensor/bright_003.png
