MurderBot1/apriltag-processor/test_images/sensor/bright_004.png

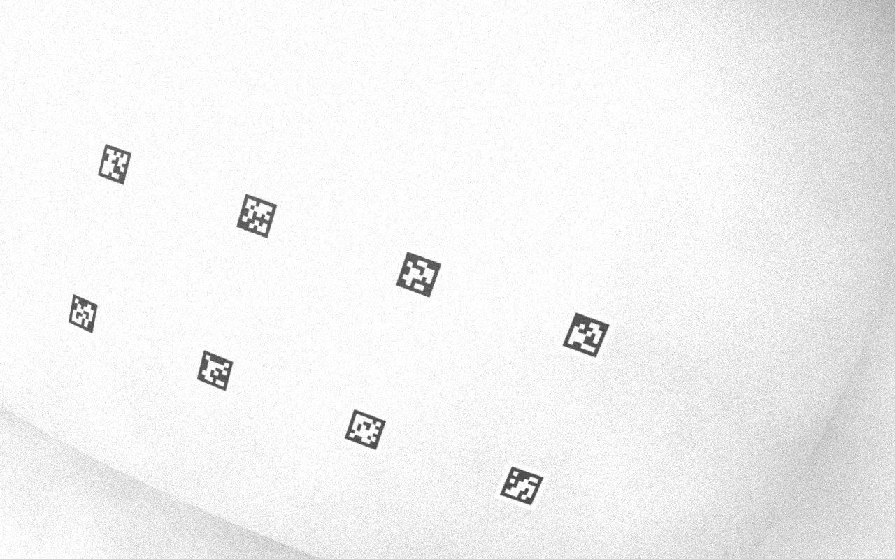
test_images/sensor/bright_004.png
