MurderBot1/apriltag-processor/test_images/sensor/bright_005.png

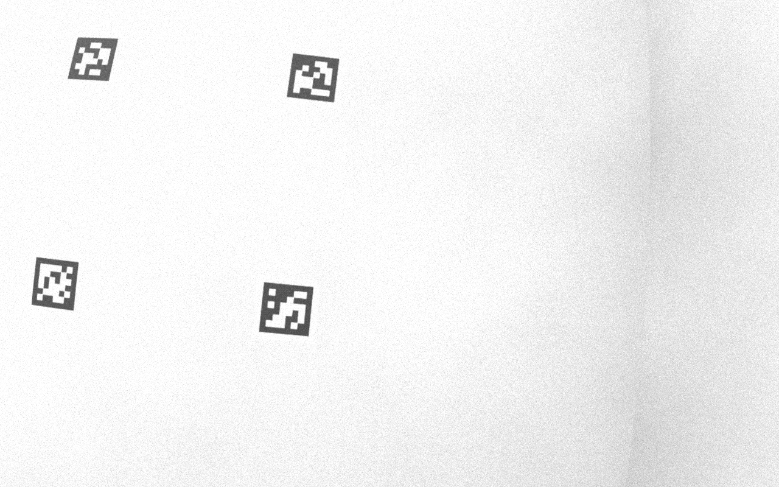
test_images/sensor/bright_005.png
