MurderBot1/apriltag-processor/test_images/sensor/bright_006.png

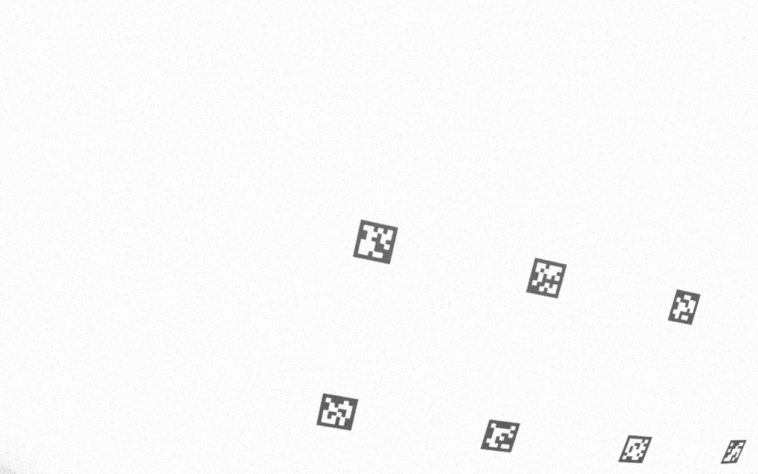
test_images/sensor/bright_006.png
