MurderBot1/apriltag-processor/test_images/sensor/bright_007.png

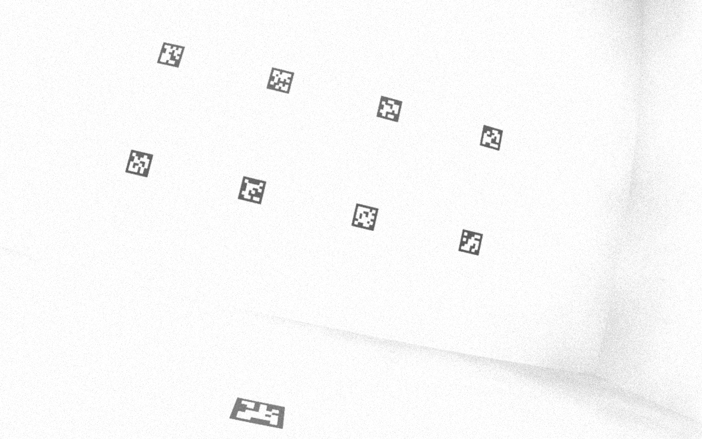
test_images/sensor/bright_007.png
