MurderBot1/apriltag-processor/test_images/sensor/bright_008.png

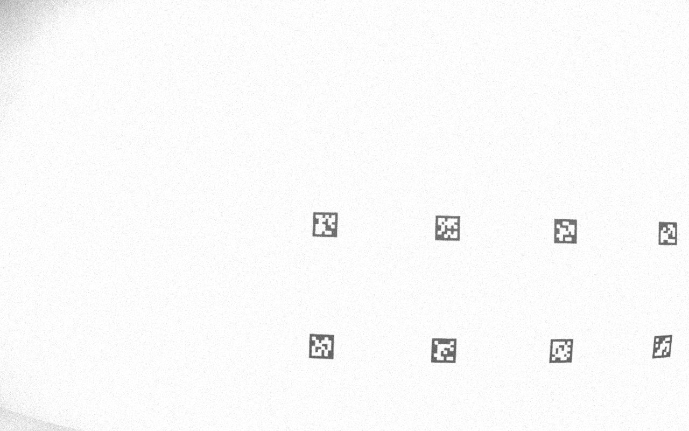
test_images/sensor/bright_008.png
