MurderBot1/apriltag-processor/test_images/sensor/bright_009.png

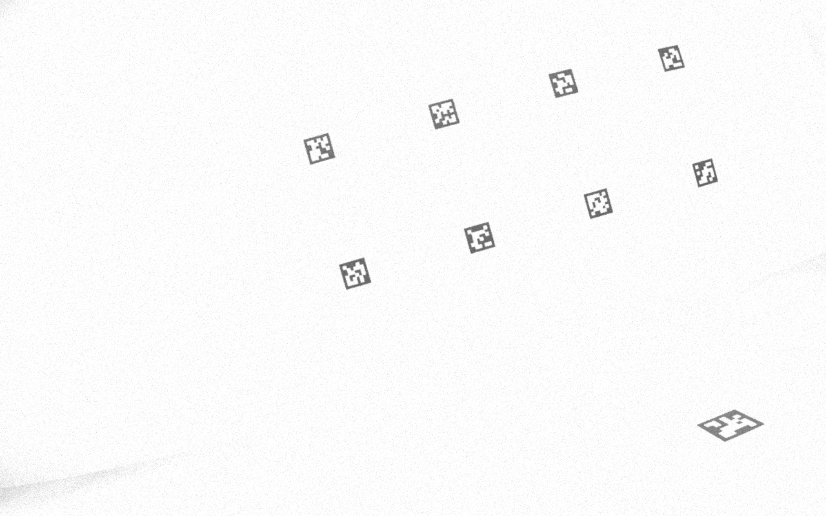
test_images/sensor/bright_009.png
