MurderBot1/apriltag-processor/test_images/sensor/clutter_000.png

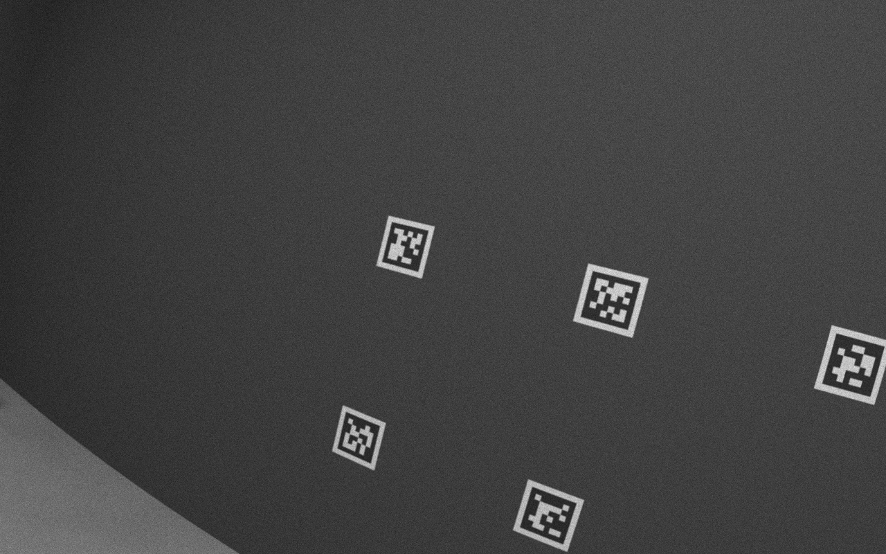
test_images/sensor/clutter_000.png
