MurderBot1/apriltag-processor/test_images/sensor/clutter_002.png

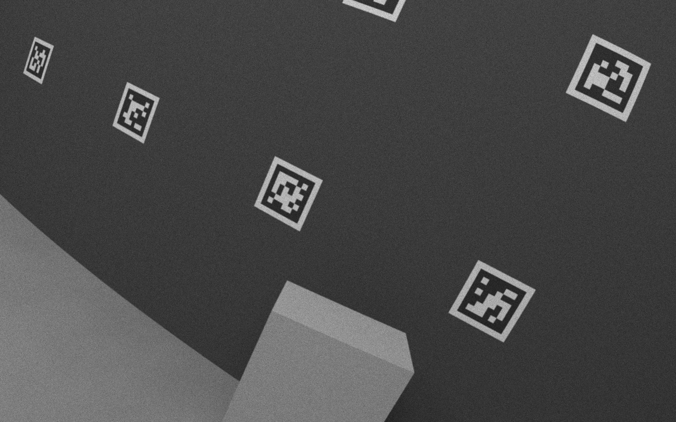
test_images/sensor/clutter_002.png
