MurderBot1/apriltag-processor/test_images/sensor/clutter_003.png

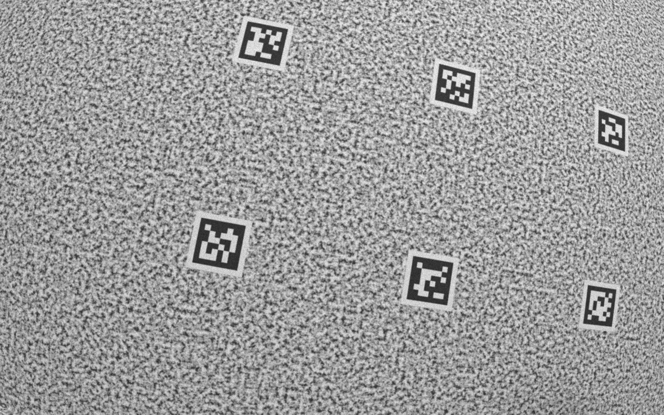
test_images/sensor/clutter_003.png
