MurderBot1/apriltag-processor/test_images/sensor/clutter_004.png

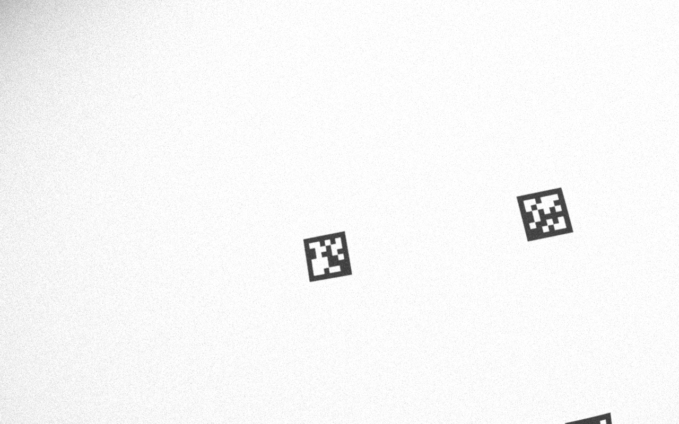
test_images/sensor/clutter_004.png
