MurderBot1/apriltag-processor/test_images/sensor/clutter_005.png

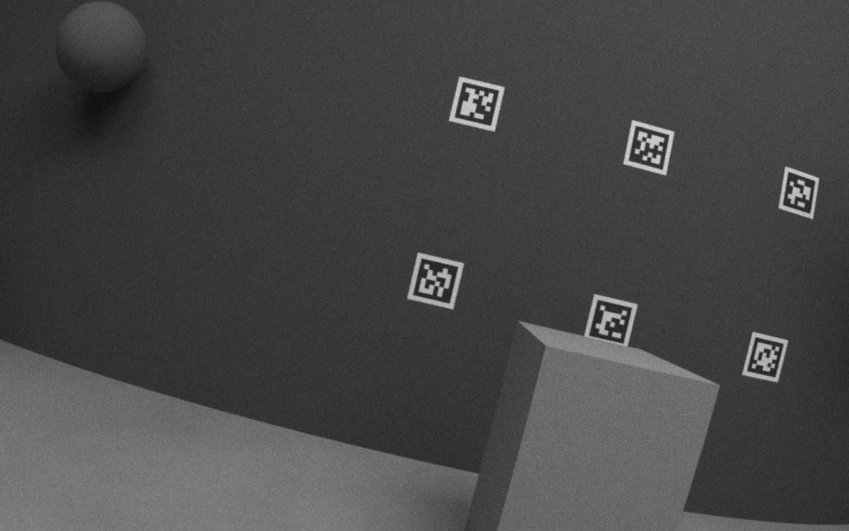
test_images/sensor/clutter_005.png
