MurderBot1/apriltag-processor/test_images/sensor/clutter_006.png

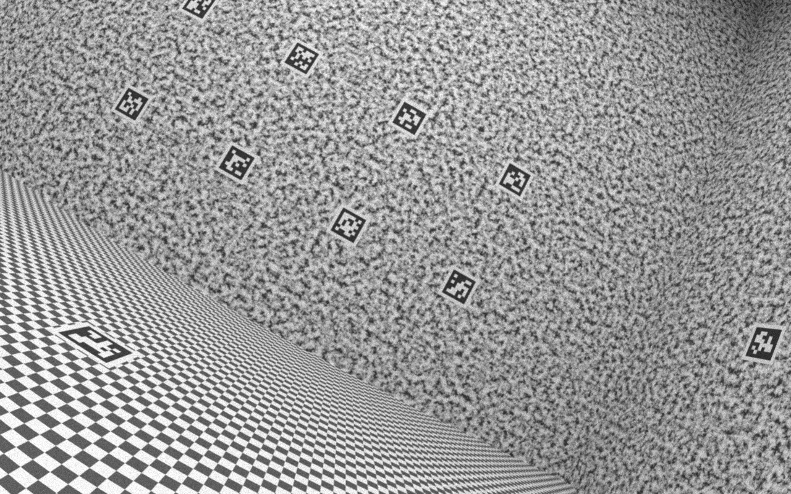
test_images/sensor/clutter_006.png
