MurderBot1/apriltag-processor/test_images/sensor/clutter_007.png

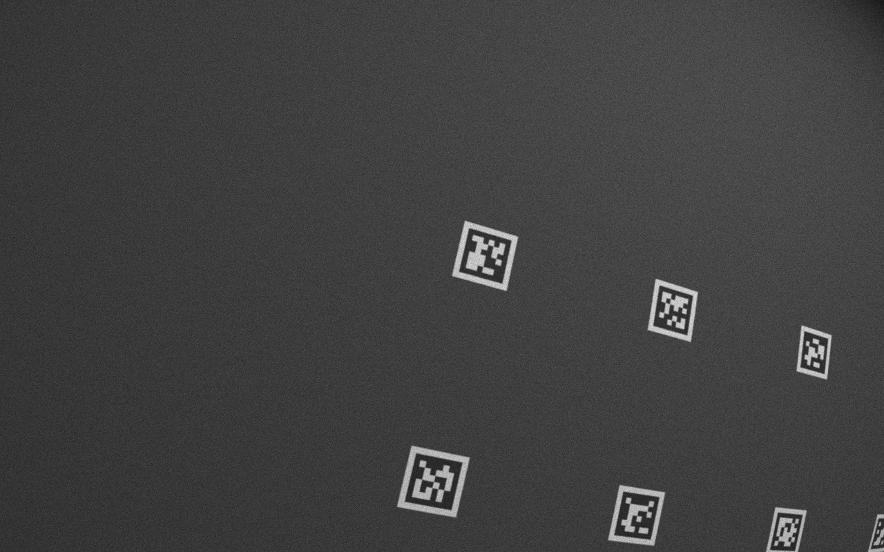
test_images/sensor/clutter_007.png
