MurderBot1/apriltag-processor/test_images/sensor/clutter_008.png

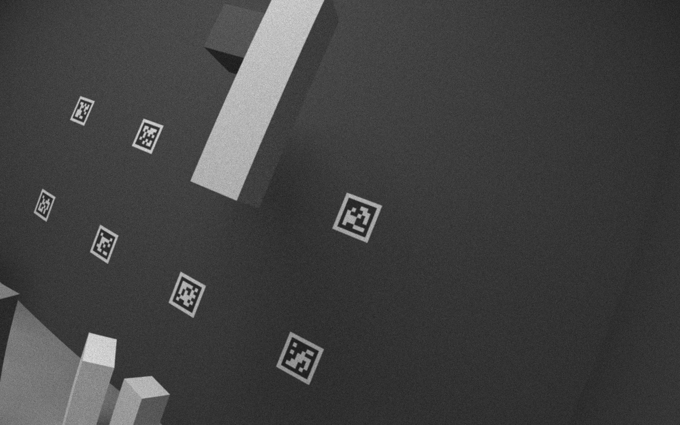
test_images/sensor/clutter_008.png
