MurderBot1/apriltag-processor/test_images/sensor/clutter_009.png

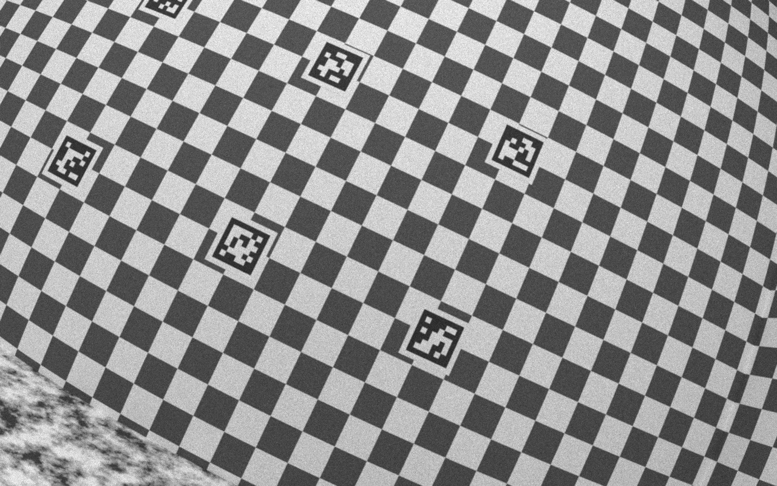
test_images/sensor/clutter_009.png
