MurderBot1/apriltag-processor/test_images/sensor/dark_000.png

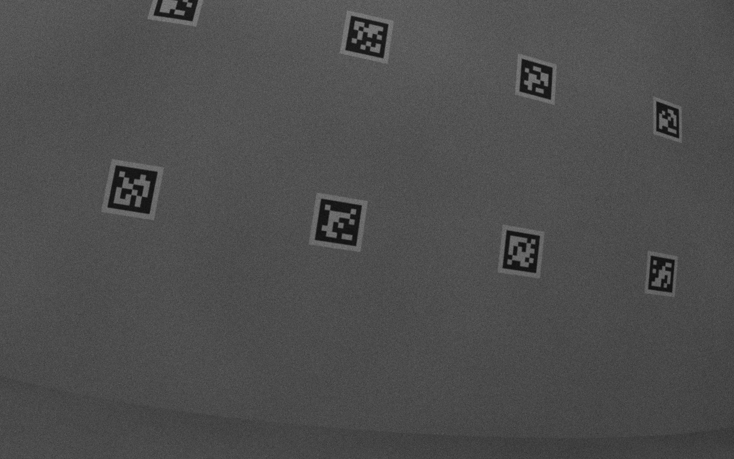
test_images/sensor/dark_000.png
