MurderBot1/apriltag-processor/test_images/sensor/dark_001.png

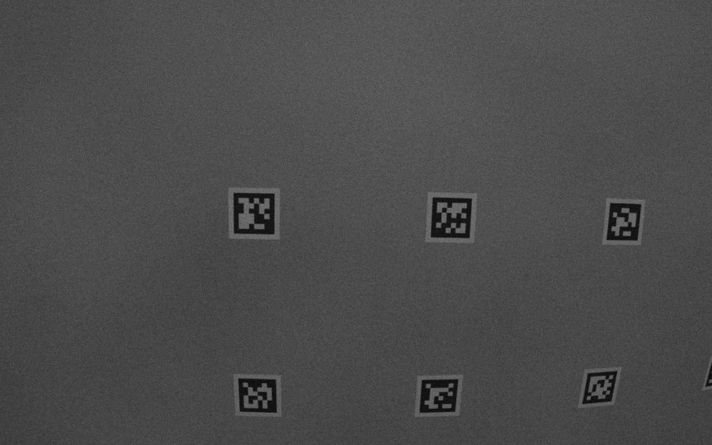
test_images/sensor/dark_001.png
