MurderBot1/apriltag-processor/test_images/sensor/dark_002.png

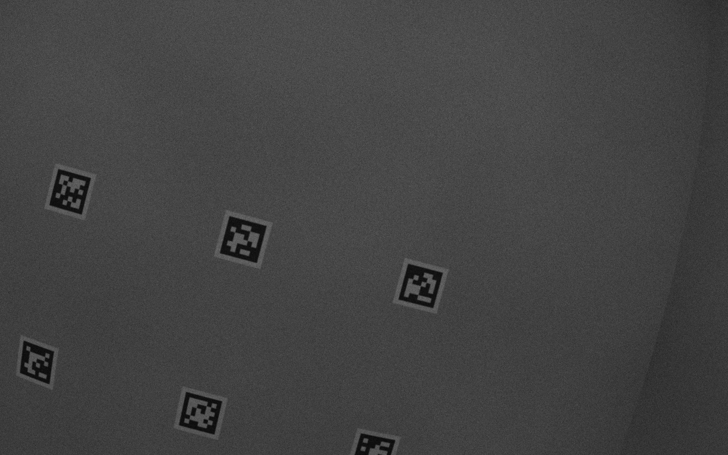
test_images/sensor/dark_002.png
