MurderBot1/apriltag-processor/test_images/sensor/dark_003.png

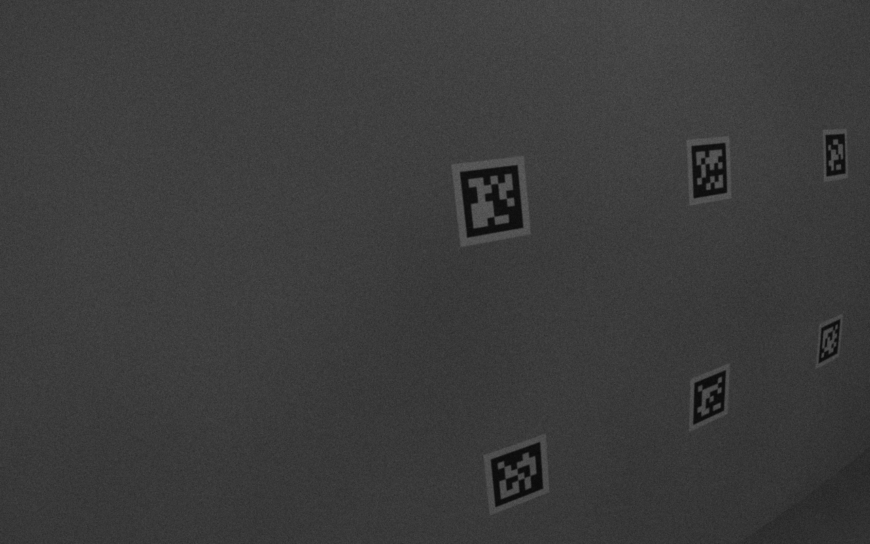
test_images/sensor/dark_003.png
