MurderBot1/apriltag-processor/test_images/sensor/dark_004.png

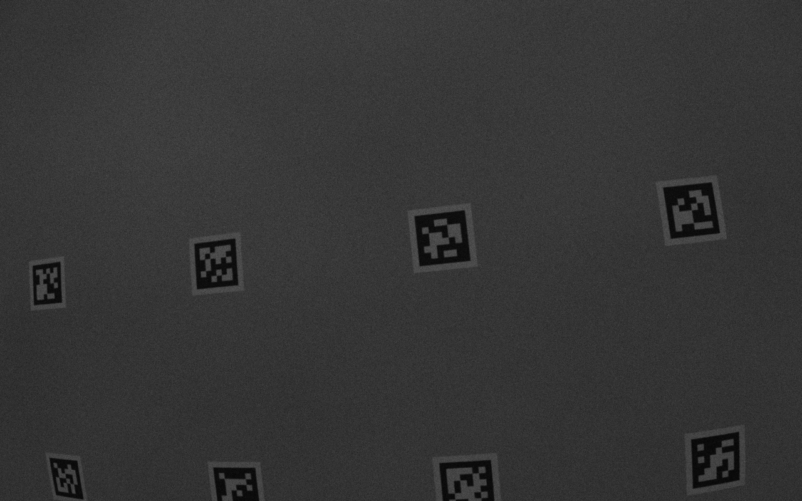
test_images/sensor/dark_004.png
