MurderBot1/apriltag-processor/test_images/sensor/dark_005.png

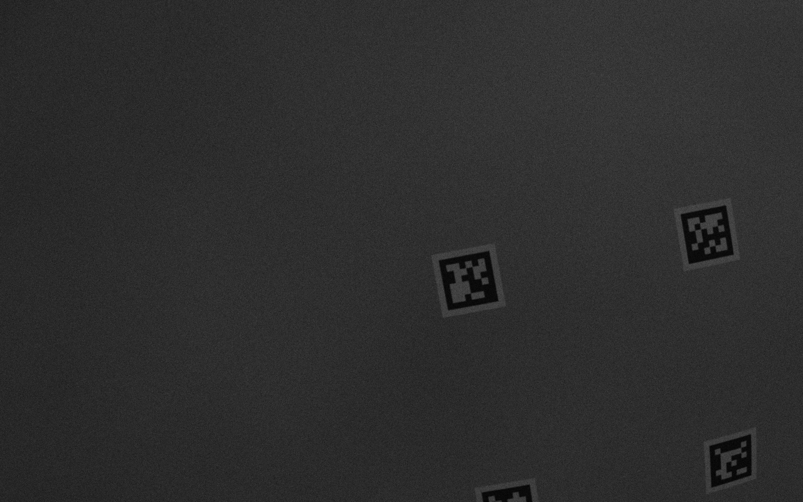
test_images/sensor/dark_005.png
