MurderBot1/apriltag-processor/test_images/sensor/dark_006.png

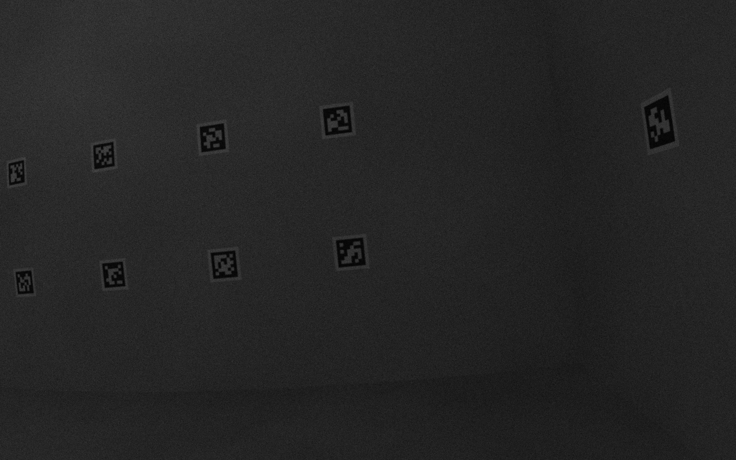
test_images/sensor/dark_006.png
