MurderBot1/apriltag-processor/test_images/sensor/dark_007.png

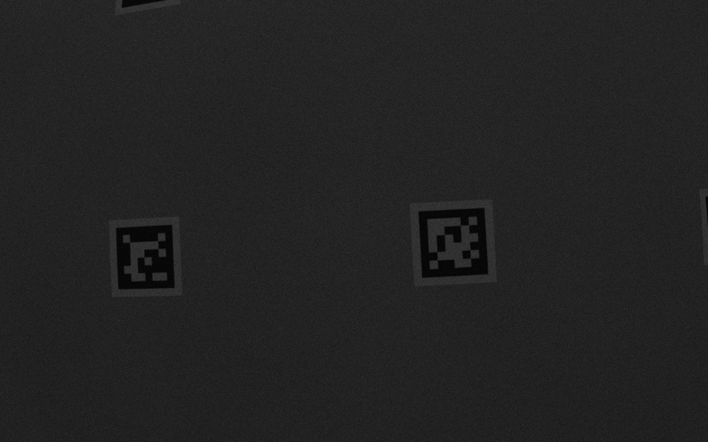
test_images/sensor/dark_007.png
