MurderBot1/apriltag-processor/test_images/sensor/dark_008.png

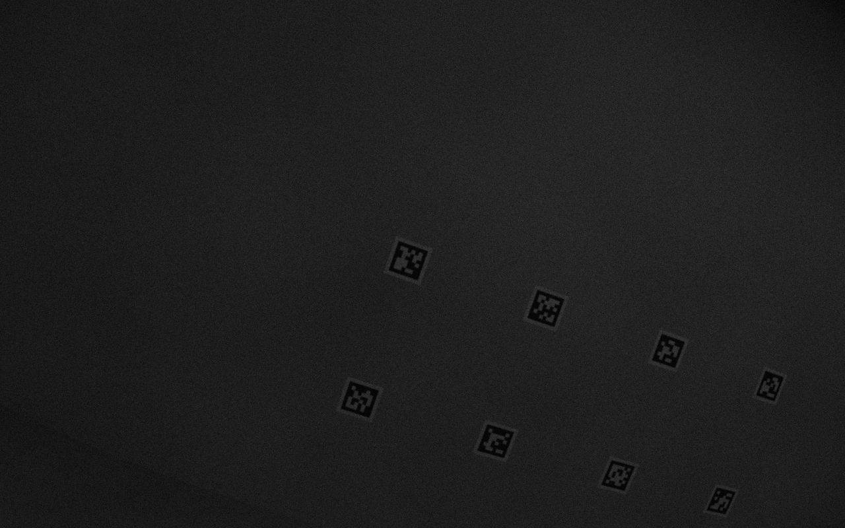
test_images/sensor/dark_008.png
