MurderBot1/apriltag-processor/test_images/sensor/dark_009.png

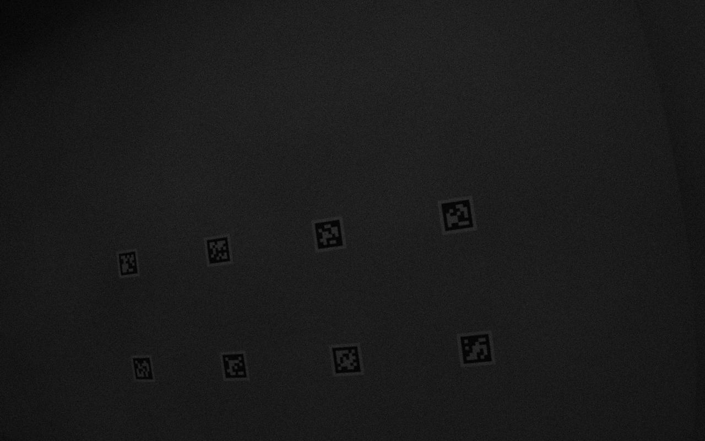
test_images/sensor/dark_009.png
