MurderBot1/apriltag-processor/test_images/sensor/grad_000.png

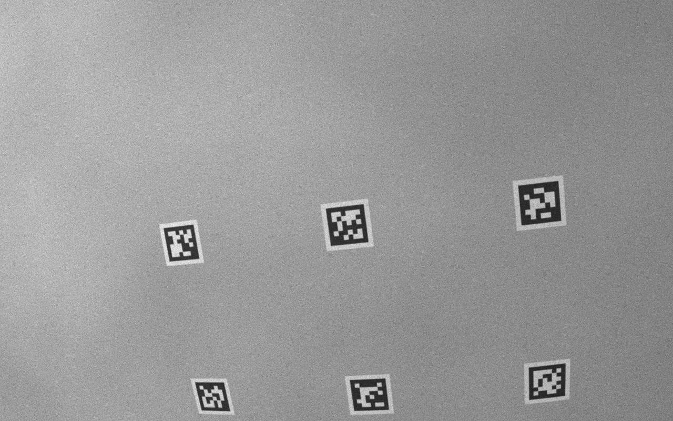
test_images/sensor/grad_000.png
