MurderBot1/apriltag-processor/test_images/sensor/grad_001.png

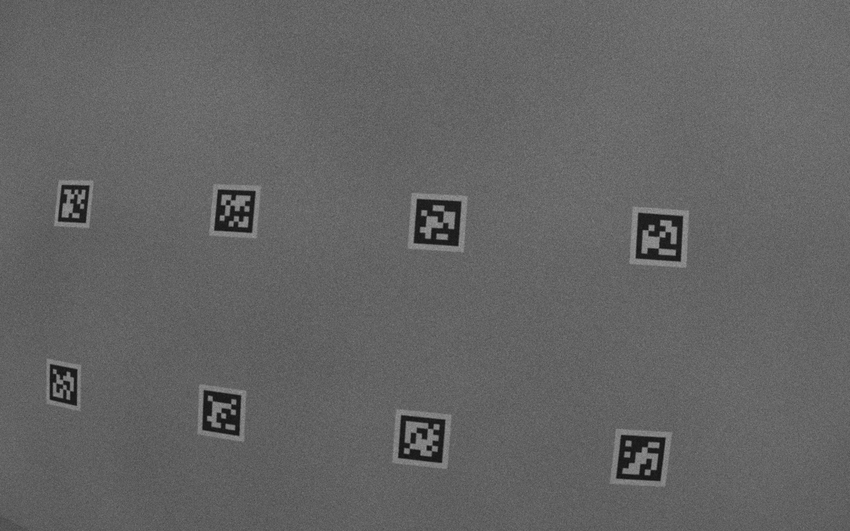
test_images/sensor/grad_001.png
