MurderBot1/apriltag-processor/test_images/sensor/grad_002.png

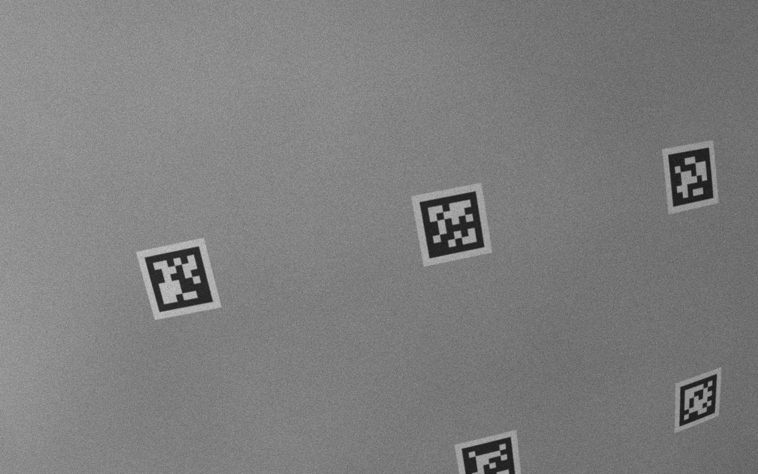
test_images/sensor/grad_002.png
