MurderBot1/apriltag-processor/test_images/sensor/grad_003.png

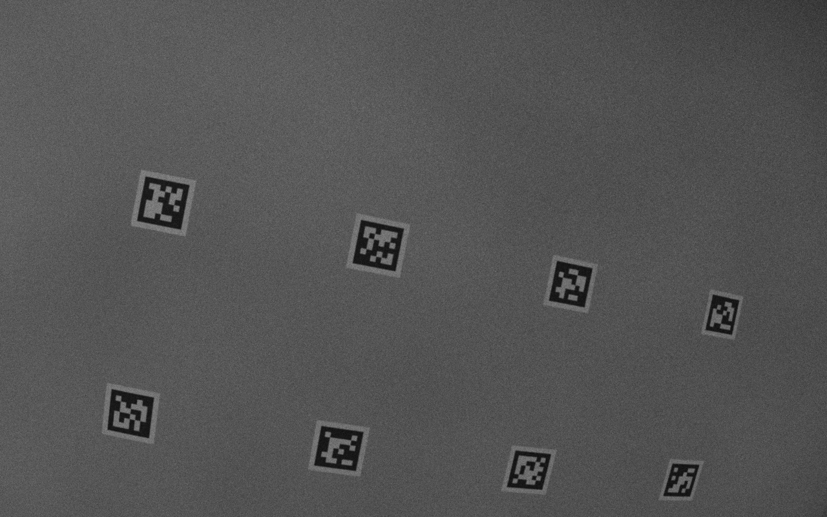
test_images/sensor/grad_003.png
