MurderBot1/apriltag-processor/test_images/sensor/grad_005.png

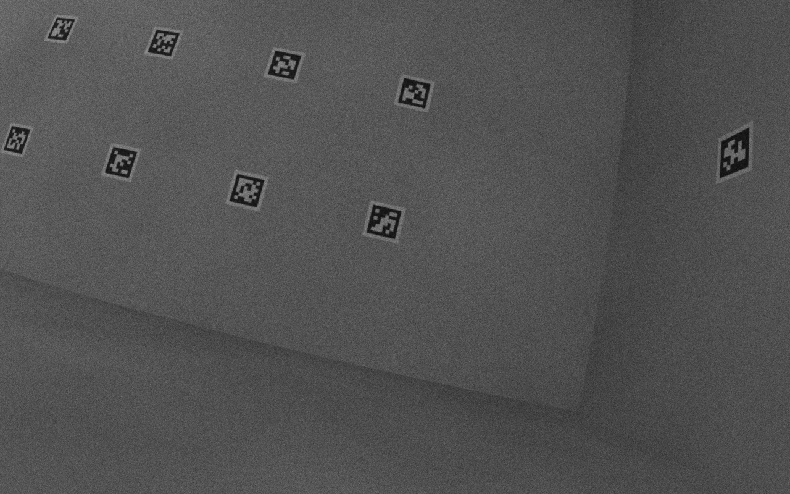
test_images/sensor/grad_005.png
