MurderBot1/apriltag-processor/test_images/sensor/grad_006.png

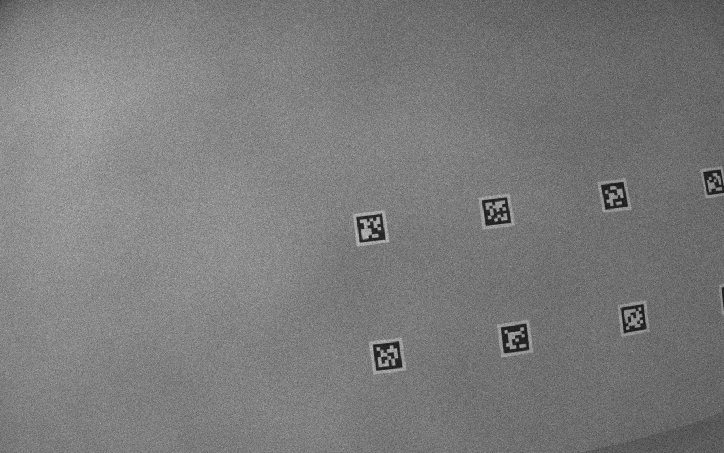
test_images/sensor/grad_006.png
