MurderBot1/apriltag-processor/test_images/sensor/grad_007.png

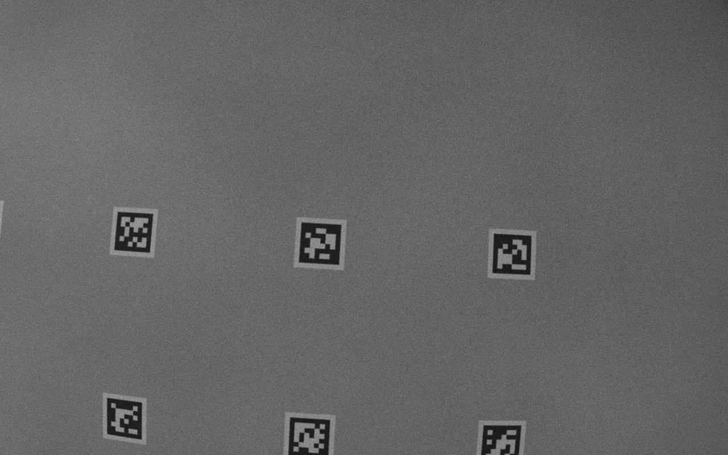
test_images/sensor/grad_007.png
