MurderBot1/apriltag-processor/test_images/sensor/grad_008.png

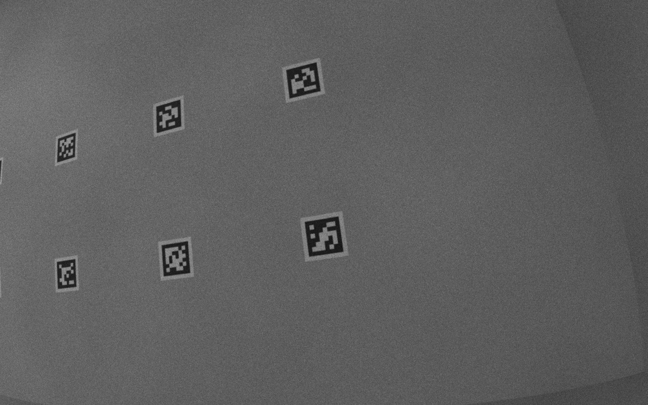
test_images/sensor/grad_008.png
