MurderBot1/apriltag-processor/test_images/sensor/grad_009.png

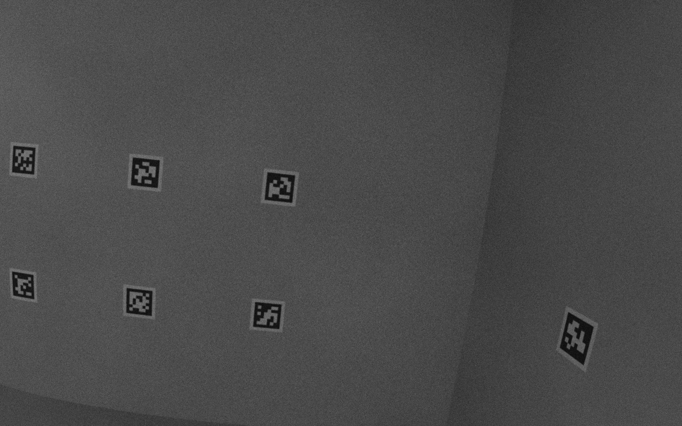
test_images/sensor/grad_009.png
