MurderBot1/apriltag-processor/test_images/sensor/lowcon_000.png

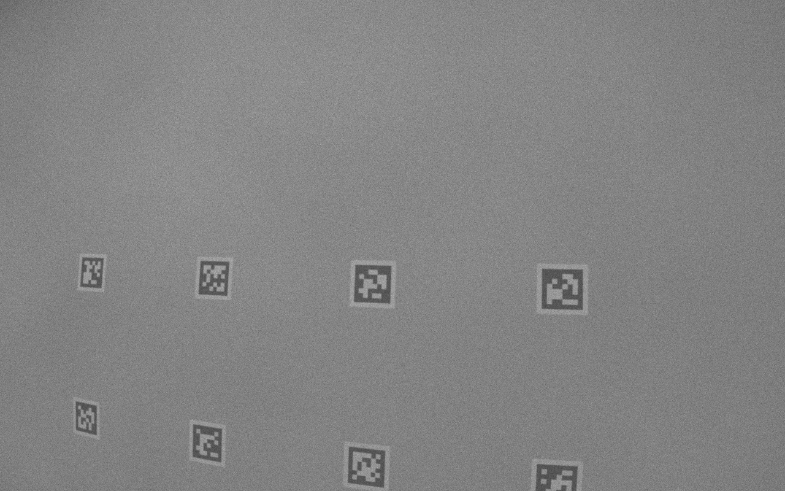
test_images/sensor/lowcon_000.png
