MurderBot1/apriltag-processor/test_images/sensor/lowcon_001.png

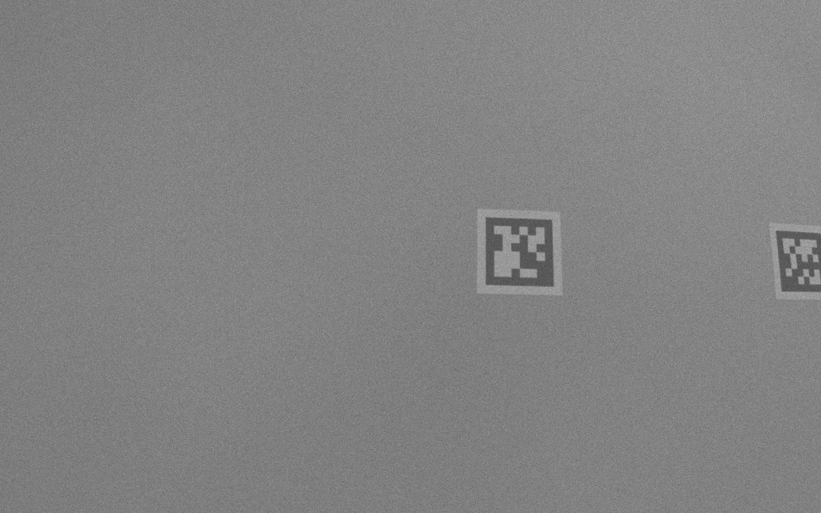
test_images/sensor/lowcon_001.png
