MurderBot1/apriltag-processor/test_images/sensor/lowcon_002.png

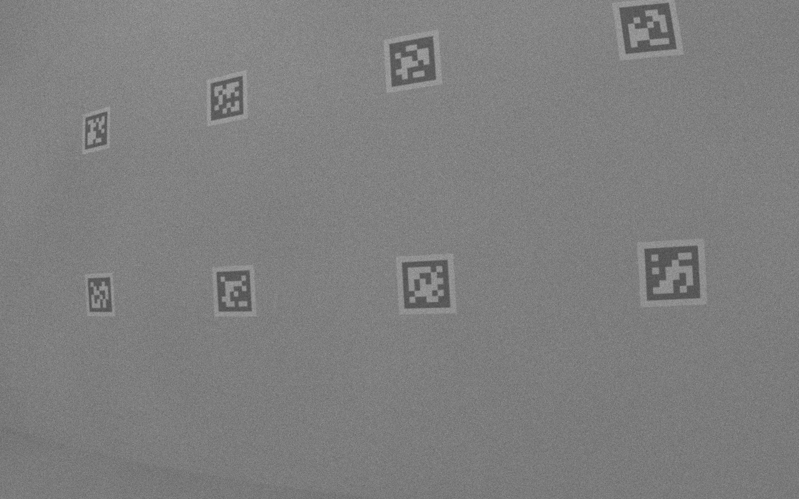
test_images/sensor/lowcon_002.png
