MurderBot1/apriltag-processor/test_images/sensor/lowcon_003.png

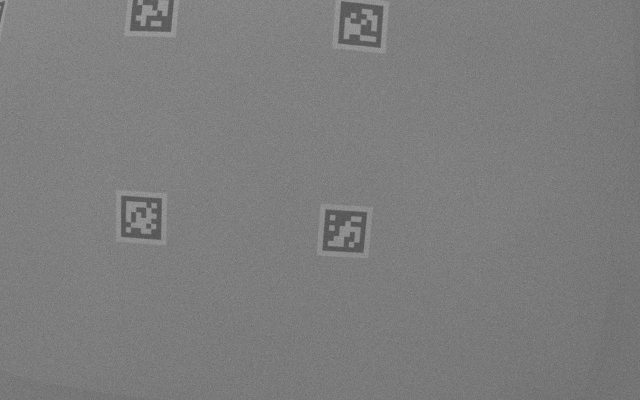
test_images/sensor/lowcon_003.png
