MurderBot1/apriltag-processor/test_images/sensor/lowcon_004.png

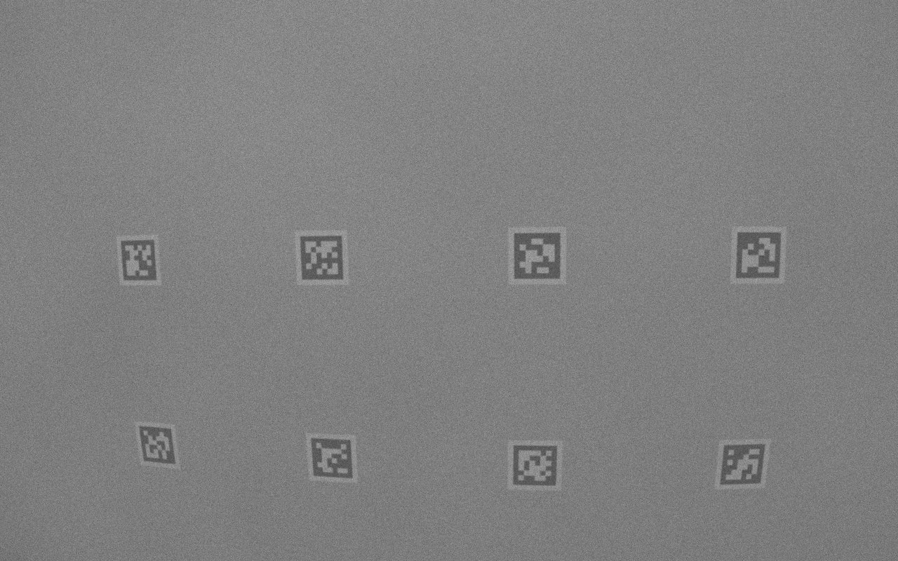
test_images/sensor/lowcon_004.png
