MurderBot1/apriltag-processor/test_images/sensor/lowcon_005.png

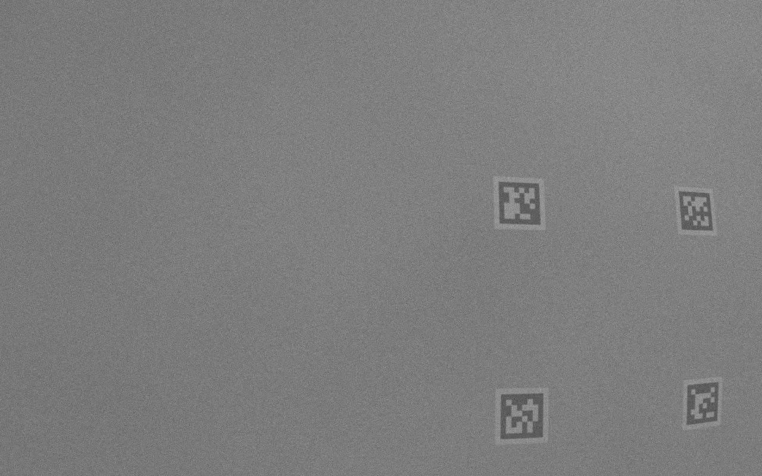
test_images/sensor/lowcon_005.png
