MurderBot1/apriltag-processor/test_images/sensor/lowcon_006.png

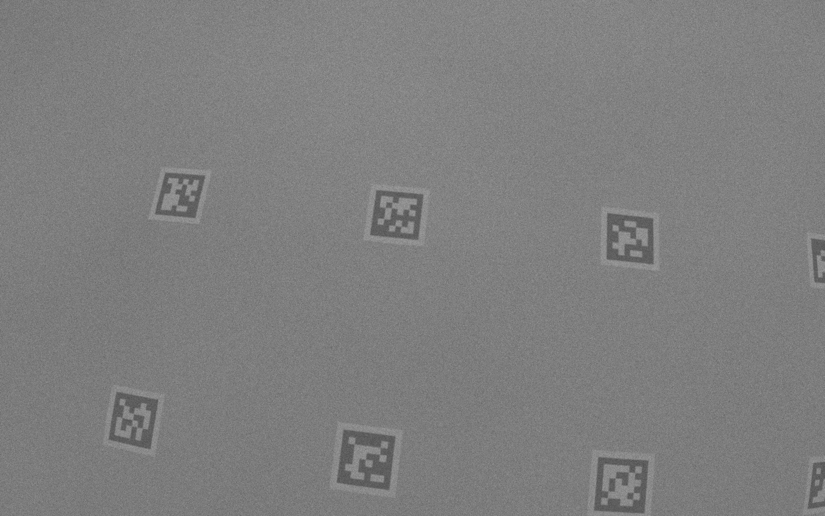
test_images/sensor/lowcon_006.png
