MurderBot1/apriltag-processor/test_images/sensor/lowcon_007.png

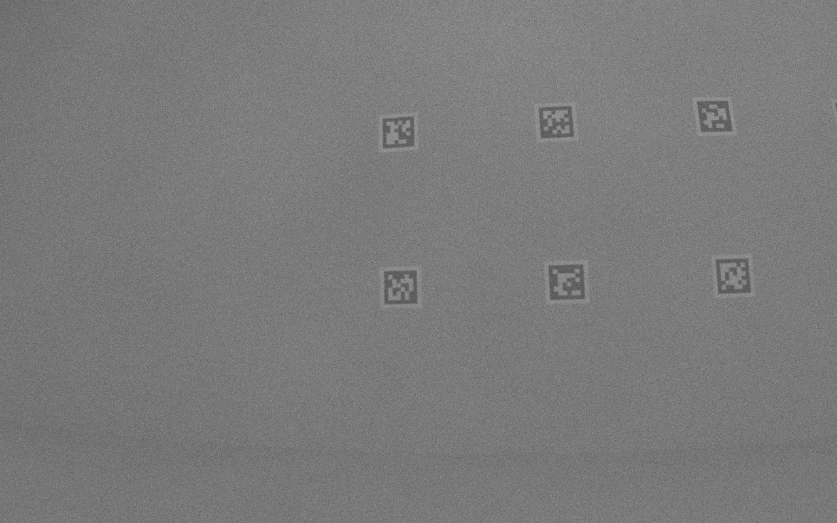
test_images/sensor/lowcon_007.png
