MurderBot1/apriltag-processor/test_images/sensor/lowcon_008.png

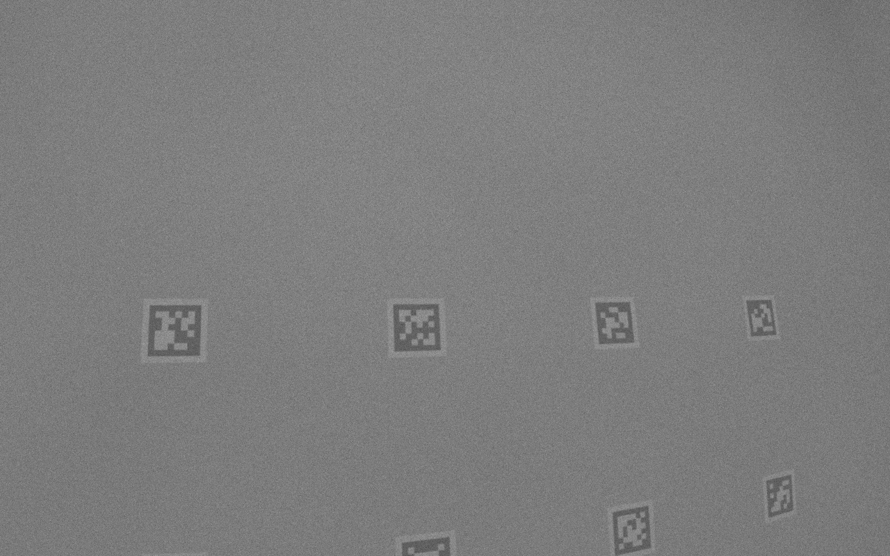
test_images/sensor/lowcon_008.png
