MurderBot1/apriltag-processor/test_images/sensor/lowcon_009.png

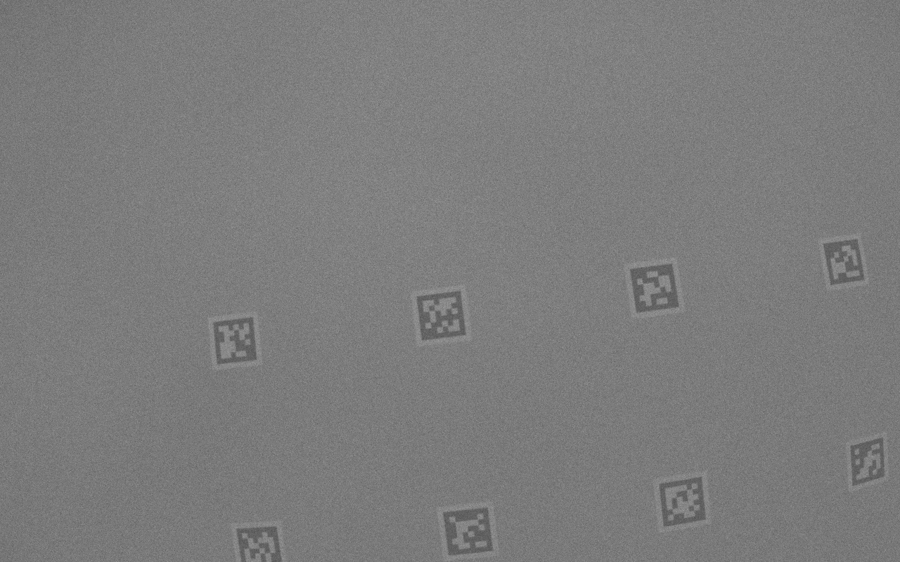
test_images/sensor/lowcon_009.png
