MurderBot1/apriltag-processor/test_images/sensor/noise_000.png

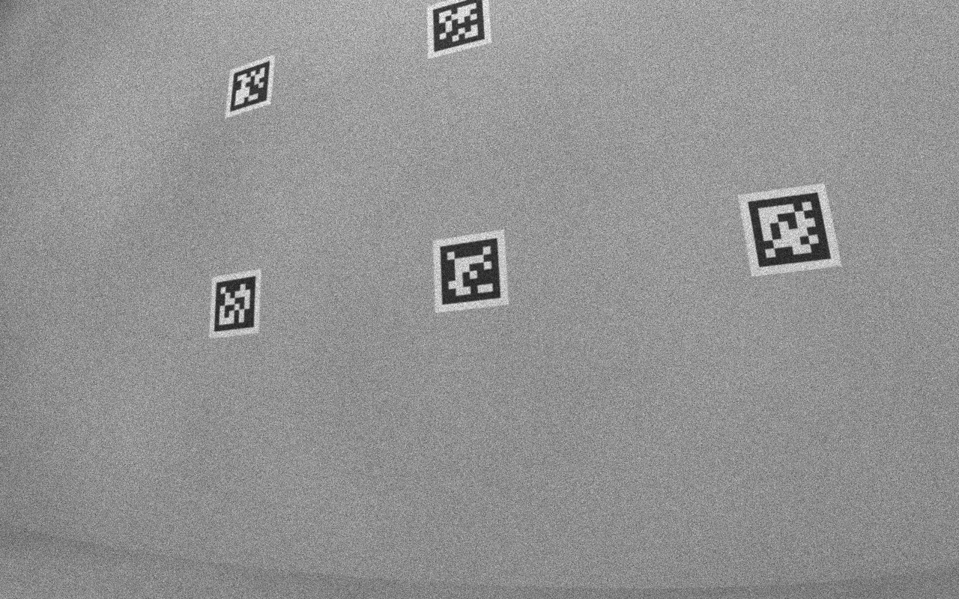
test_images/sensor/noise_000.png
