MurderBot1/apriltag-processor/test_images/sensor/noise_001.png

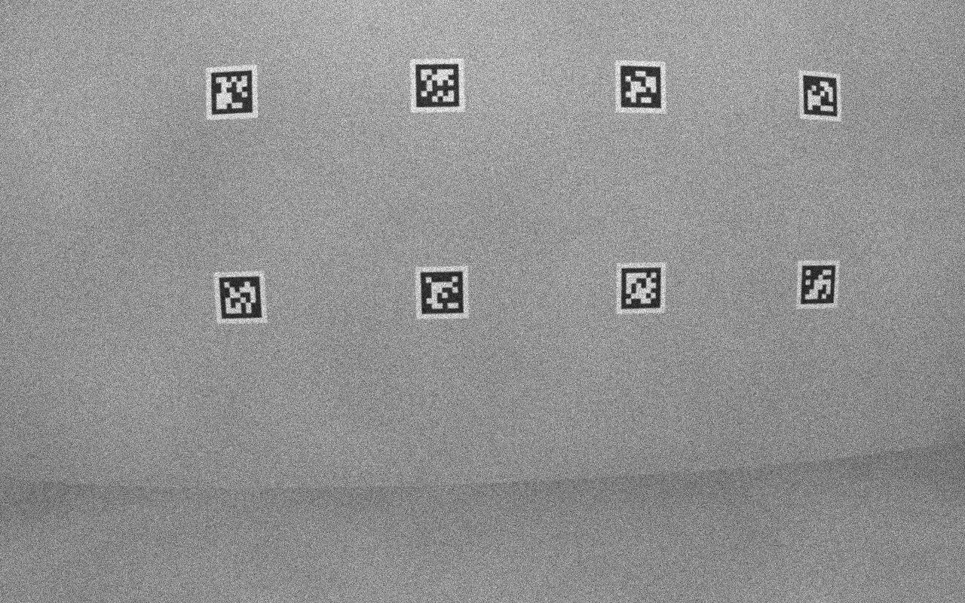
test_images/sensor/noise_001.png
