MurderBot1/apriltag-processor/test_images/sensor/noise_002.png

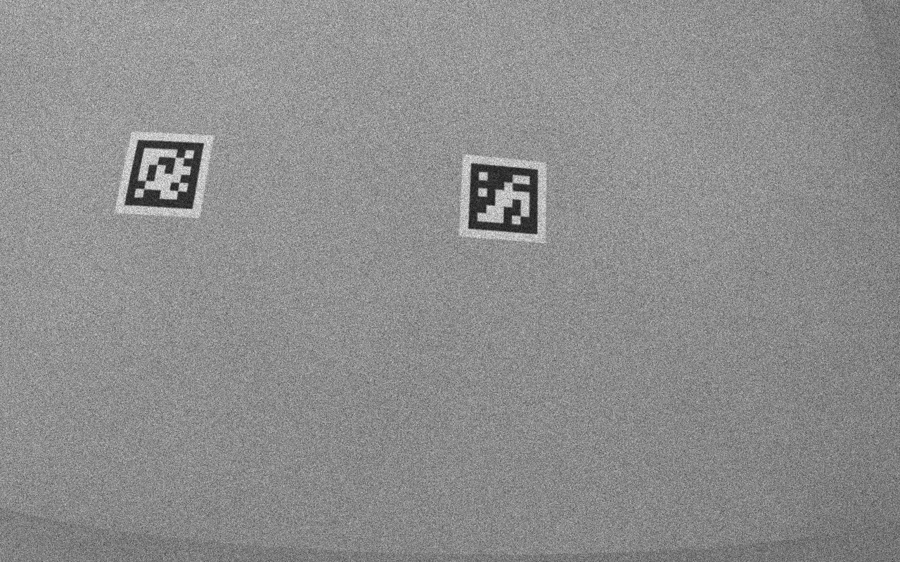
test_images/sensor/noise_002.png
