MurderBot1/apriltag-processor/test_images/sensor/noise_003.png

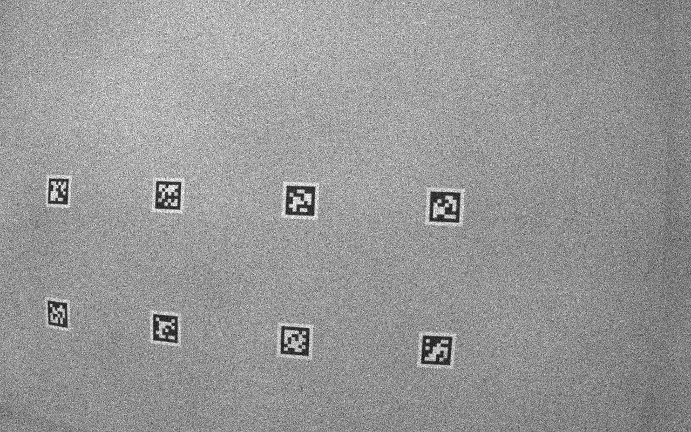
test_images/sensor/noise_003.png
