MurderBot1/apriltag-processor/test_images/sensor/noise_004.png

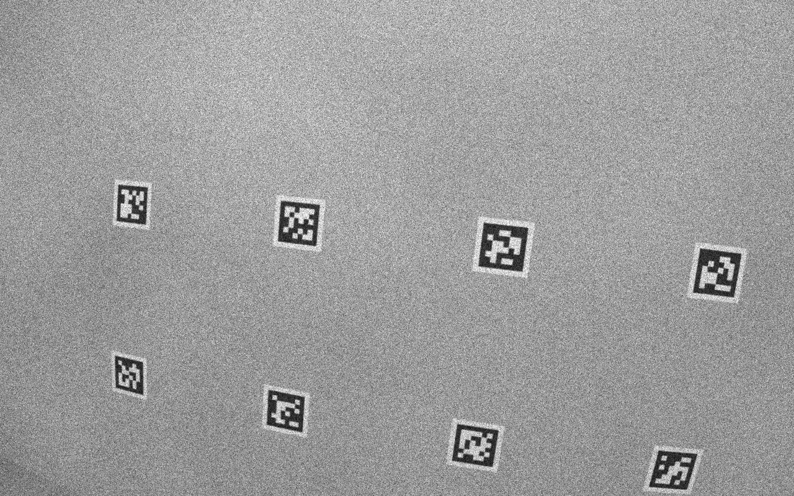
test_images/sensor/noise_004.png
