MurderBot1/apriltag-processor/test_images/sensor/noise_005.png

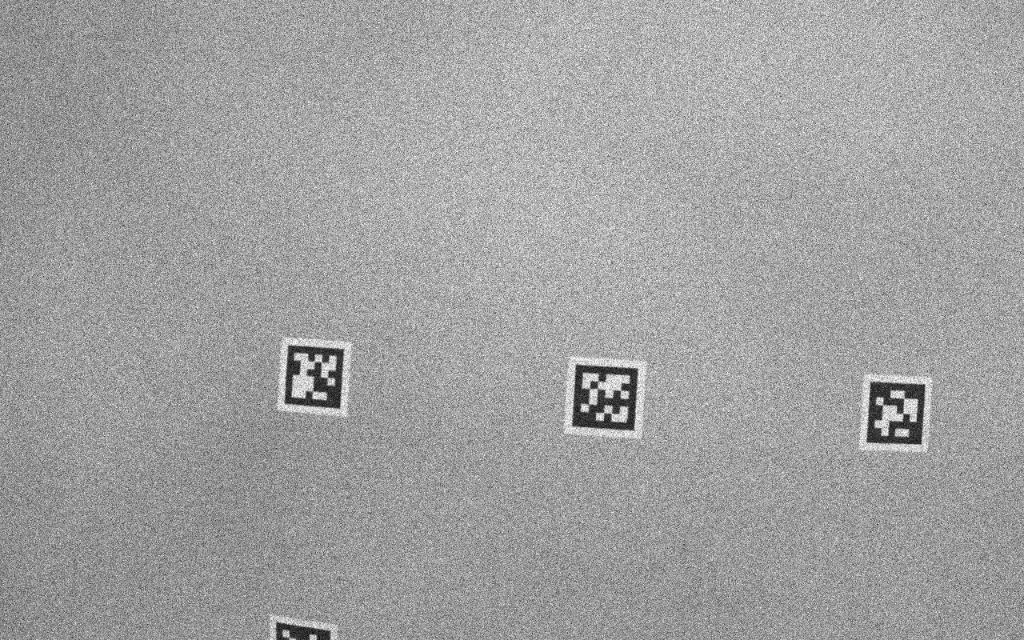
test_images/sensor/noise_005.png
