MurderBot1/apriltag-processor/test_images/sensor/noise_006.png

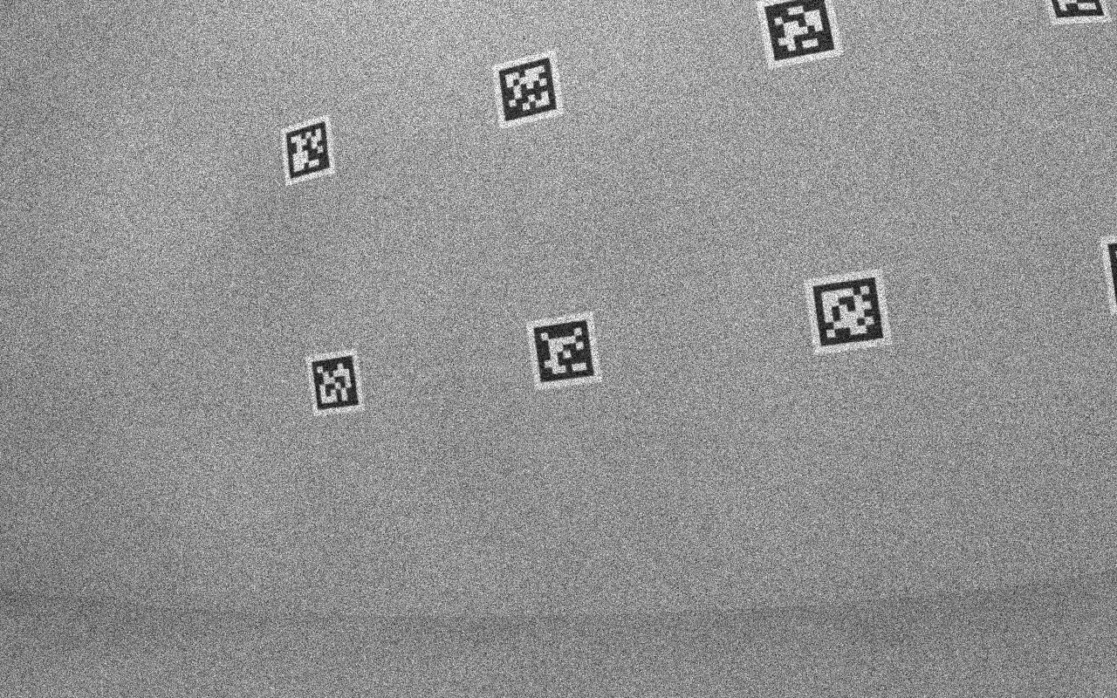
test_images/sensor/noise_006.png
