MurderBot1/apriltag-processor/test_images/sensor/noise_007.png

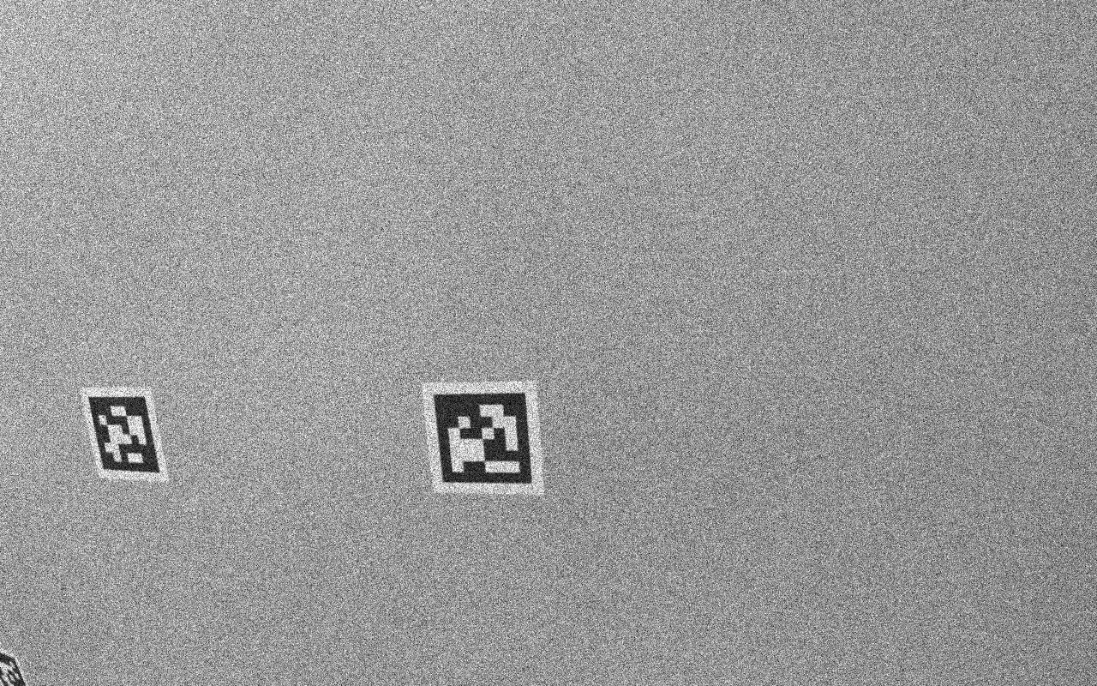
test_images/sensor/noise_007.png
