MurderBot1/apriltag-processor/test_images/sensor/noise_008.png

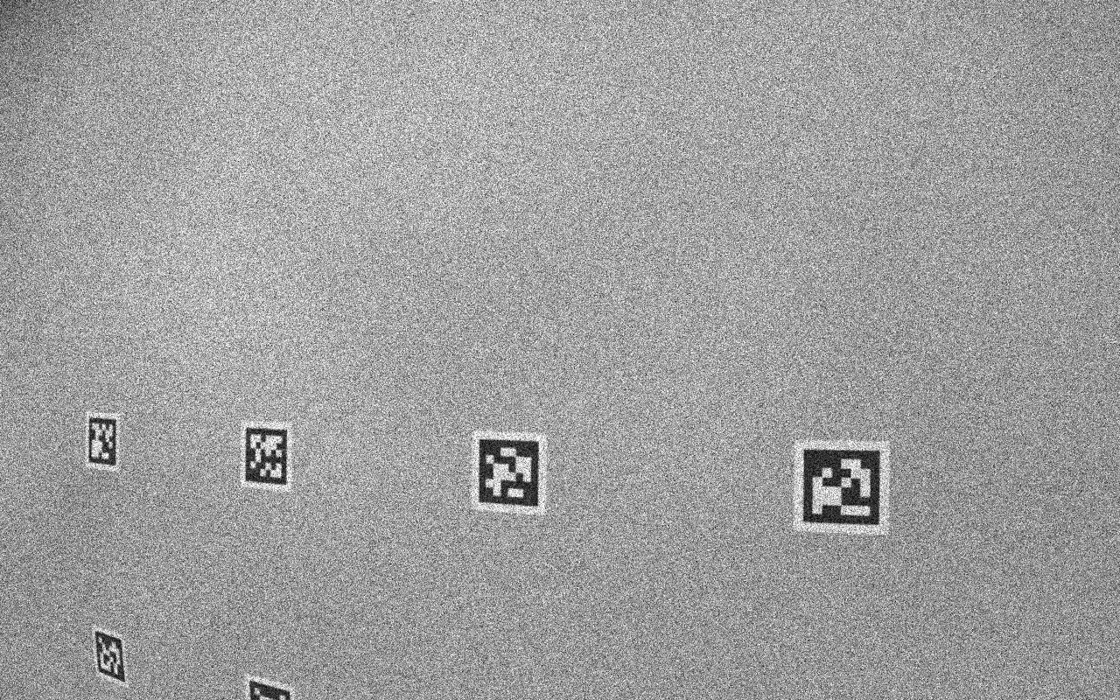
test_images/sensor/noise_008.png
