MurderBot1/apriltag-processor/test_images/sensor/noise_009.png

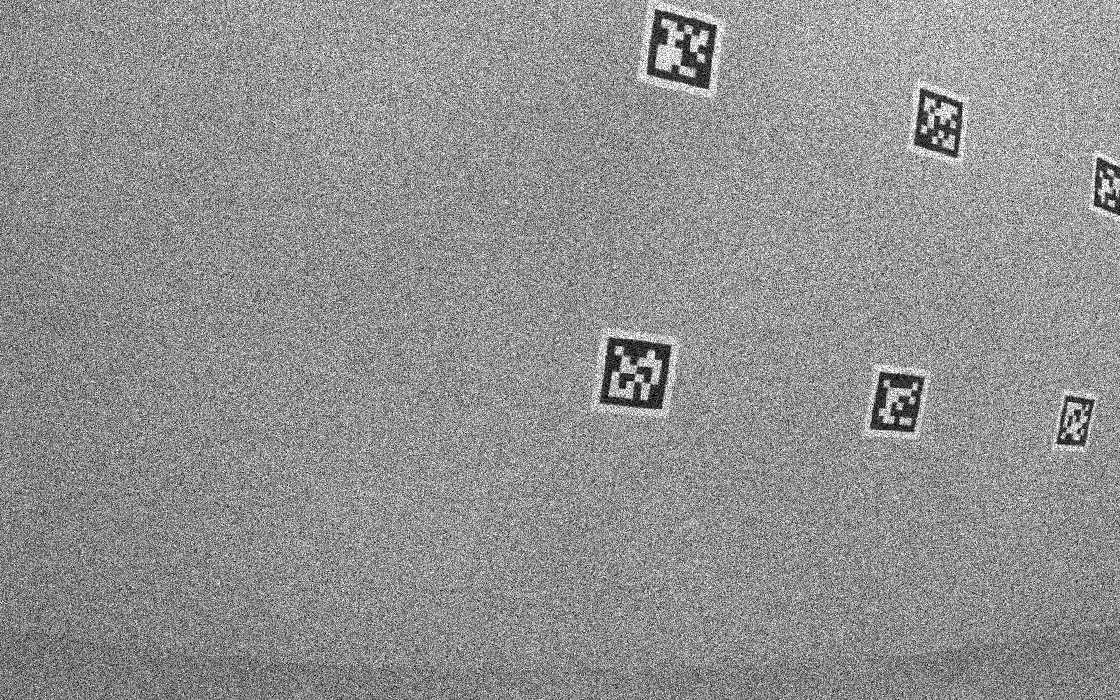
test_images/sensor/noise_009.png
