MurderBot1/apriltag-processor/test_images/sensor/normal_000.png

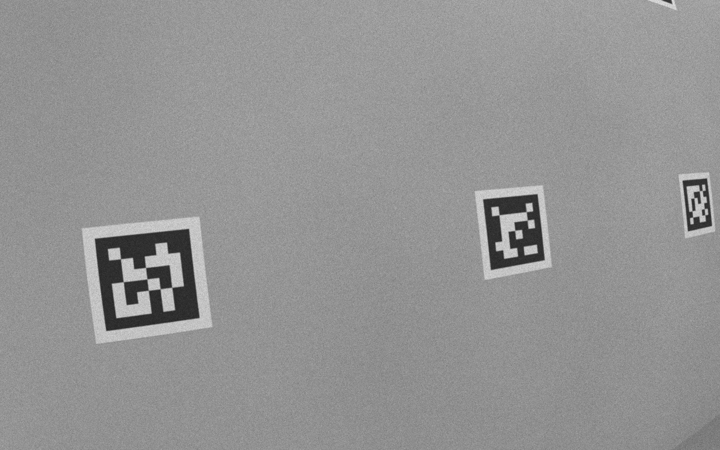
test_images/sensor/normal_000.png
