MurderBot1/apriltag-processor/test_images/sensor/normal_001.png

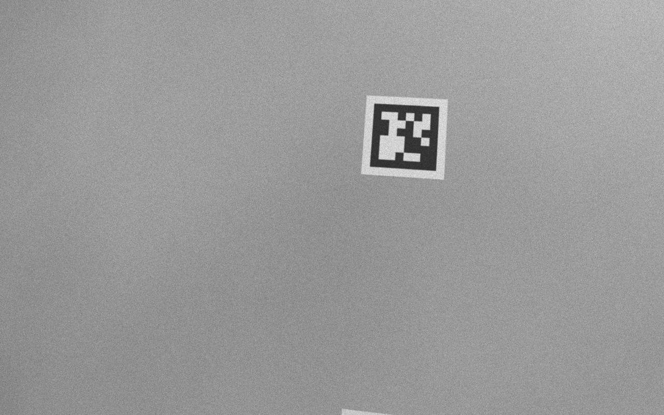
test_images/sensor/normal_001.png
