MurderBot1/apriltag-processor/test_images/sensor/normal_002.png

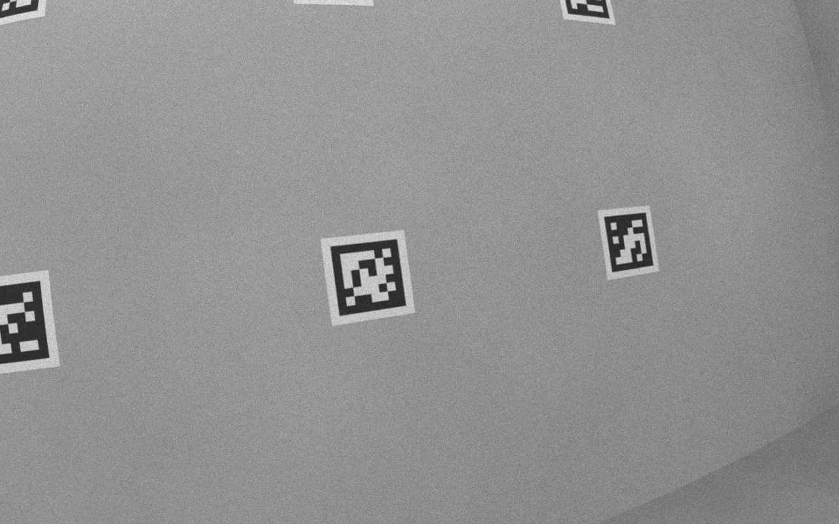
test_images/sensor/normal_002.png
