MurderBot1/apriltag-processor/test_images/sensor/normal_003.png

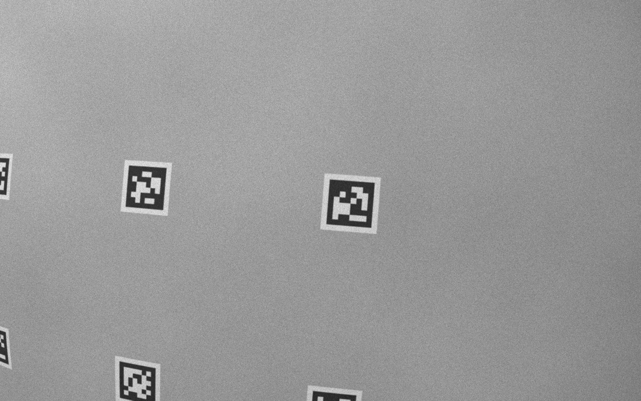
test_images/sensor/normal_003.png
