MurderBot1/apriltag-processor/test_images/sensor/normal_004.png

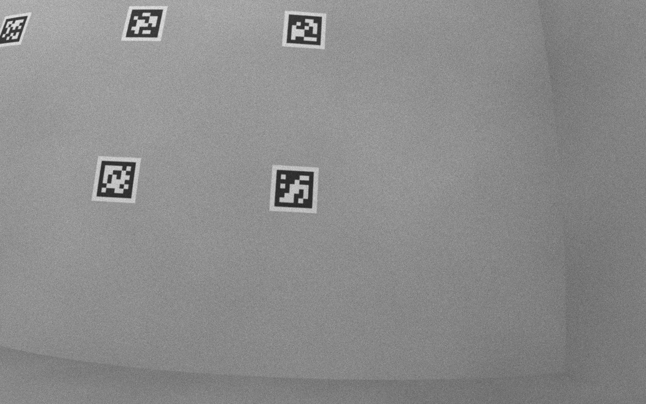
test_images/sensor/normal_004.png
