MurderBot1/apriltag-processor/test_images/sensor/normal_005.png

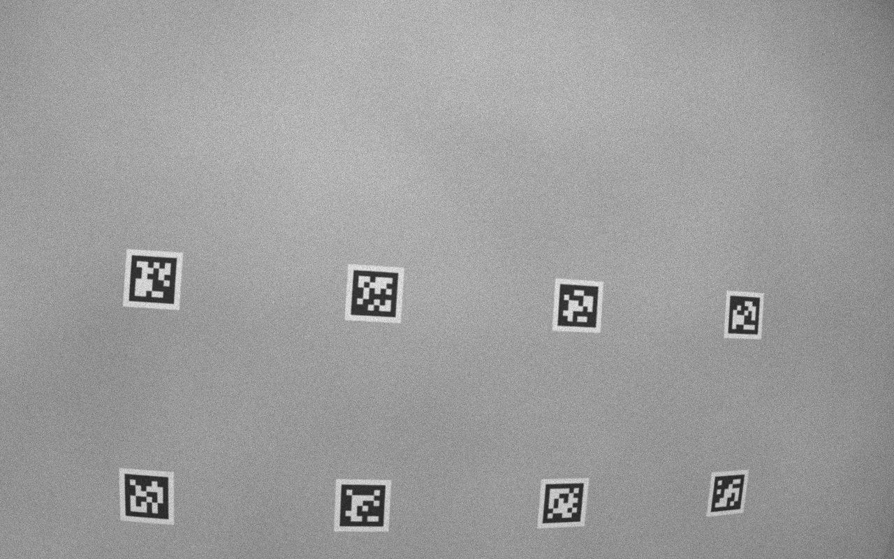
test_images/sensor/normal_005.png
