MurderBot1/apriltag-processor/test_images/sensor/normal_006.png

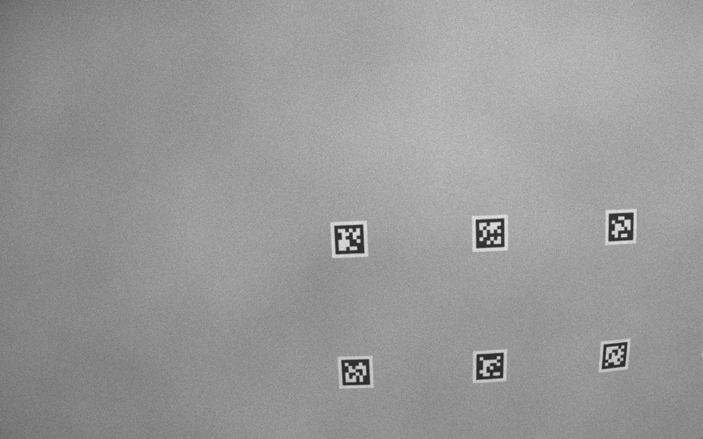
test_images/sensor/normal_006.png
