MurderBot1/apriltag-processor/test_images/sensor/normal_007.png

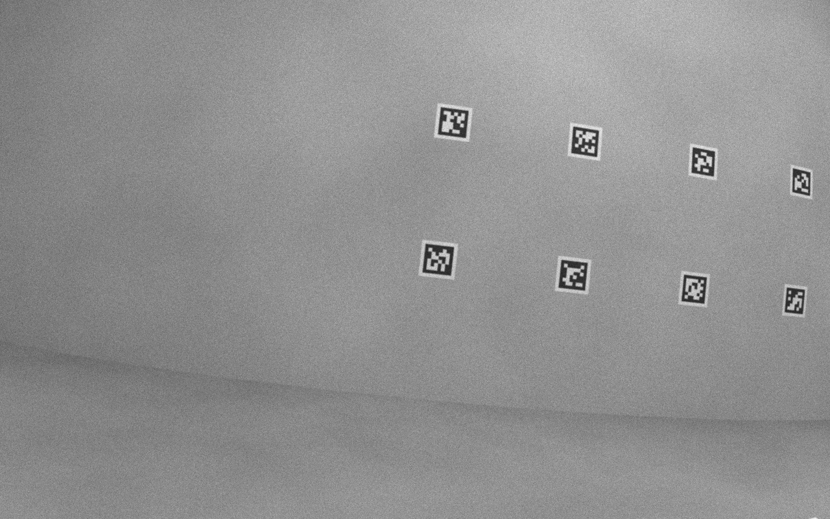
test_images/sensor/normal_007.png
