MurderBot1/apriltag-processor/test_images/sensor/normal_008.png

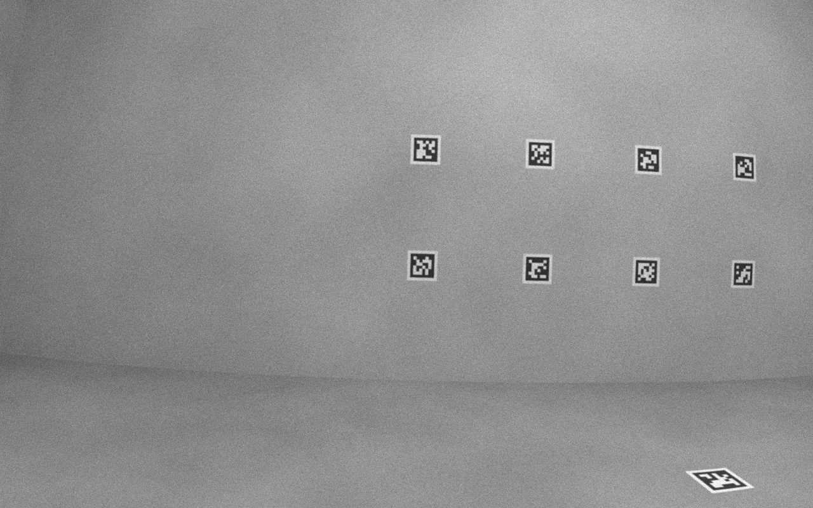
test_images/sensor/normal_008.png
