MurderBot1/apriltag-processor/test_images/sensor/normal_009.png

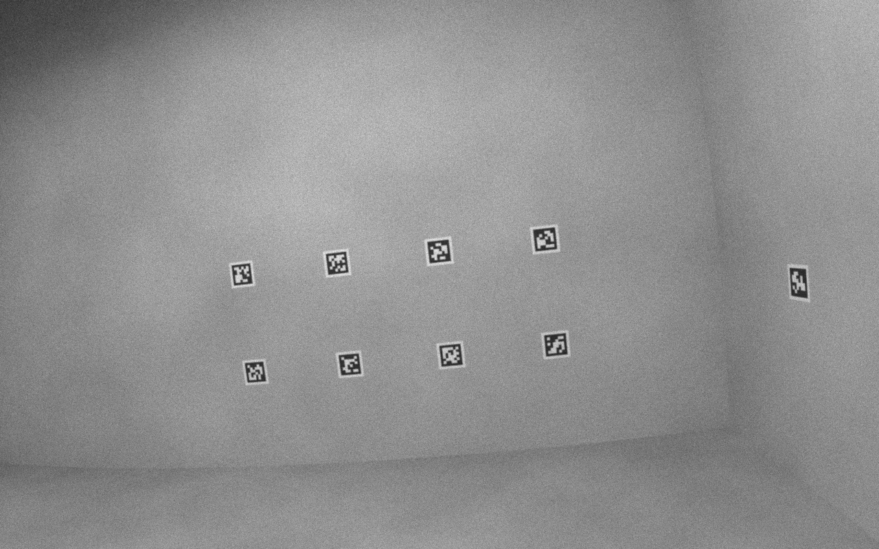
test_images/sensor/normal_009.png
