MurderBot1/apriltag-processor/test_images/sensor/persp_000.png

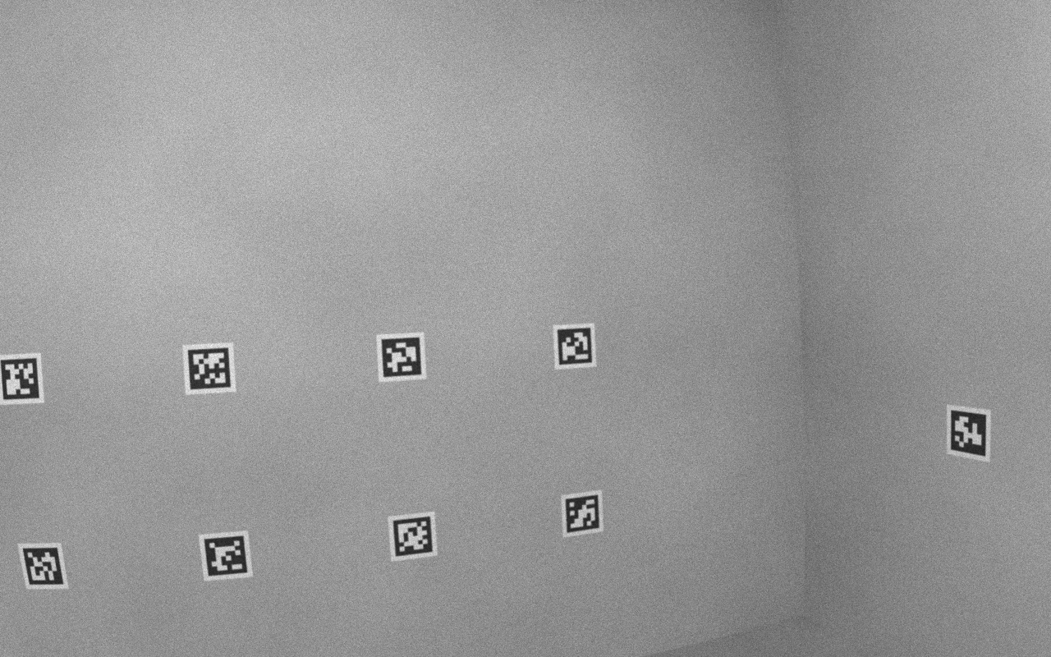
test_images/sensor/persp_000.png
