MurderBot1/apriltag-processor/test_images/sensor/persp_001.png

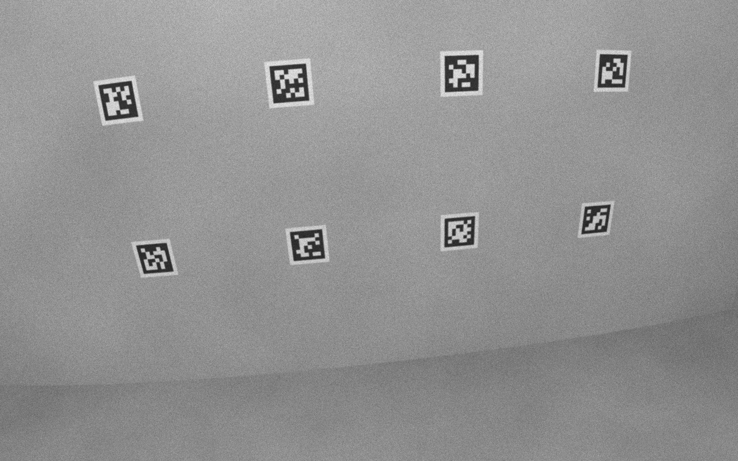
test_images/sensor/persp_001.png
