MurderBot1/apriltag-processor/test_images/sensor/persp_002.png

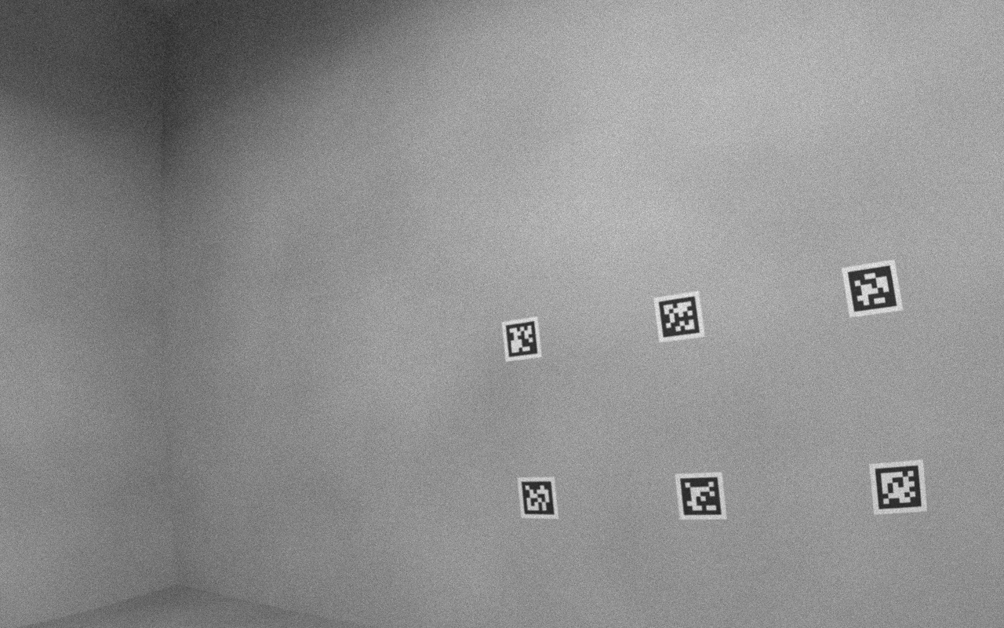
test_images/sensor/persp_002.png
