MurderBot1/apriltag-processor/test_images/sensor/persp_003.png

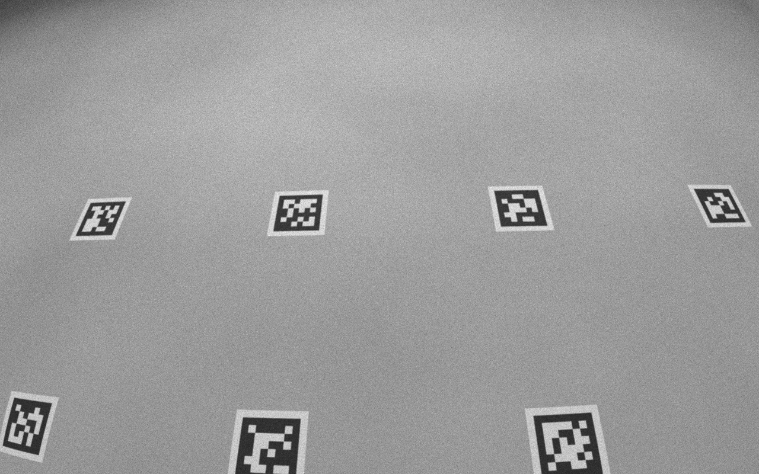
test_images/sensor/persp_003.png
