MurderBot1/apriltag-processor/test_images/sensor/persp_004.png

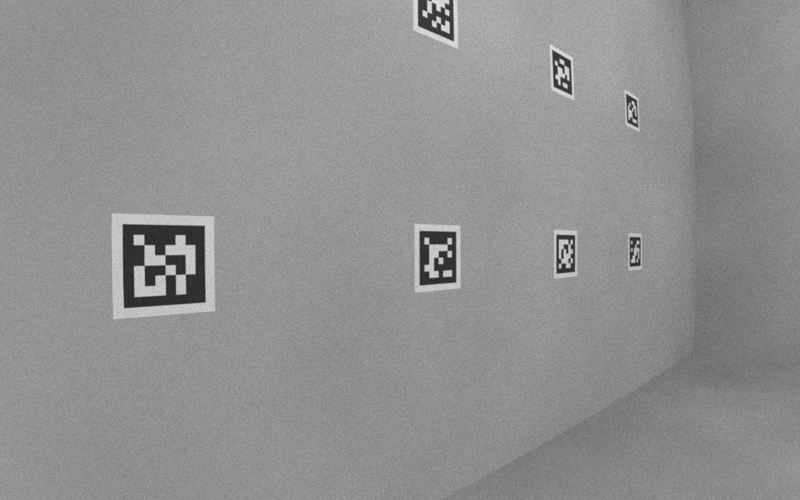
test_images/sensor/persp_004.png
