MurderBot1/apriltag-processor/test_images/sensor/persp_005.png

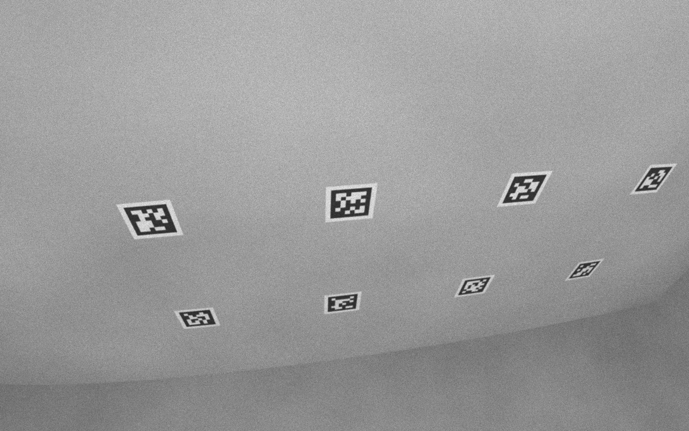
test_images/sensor/persp_005.png
