MurderBot1/apriltag-processor/test_images/sensor/persp_006.png

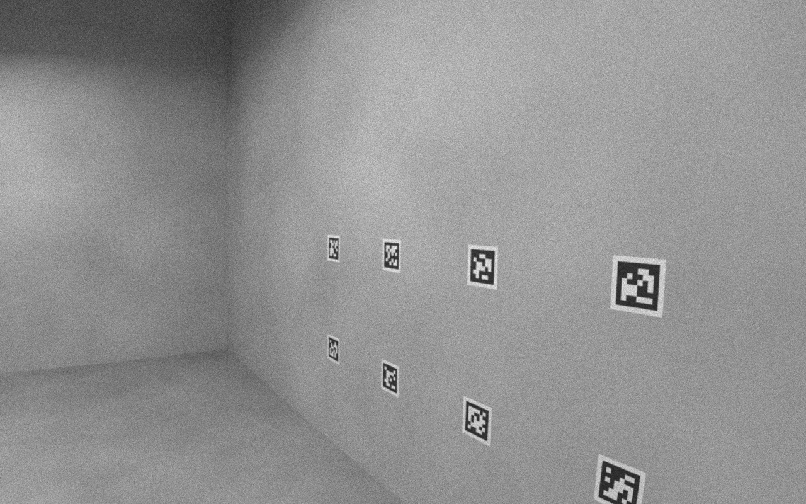
test_images/sensor/persp_006.png
