MurderBot1/apriltag-processor/test_images/sensor/persp_007.png

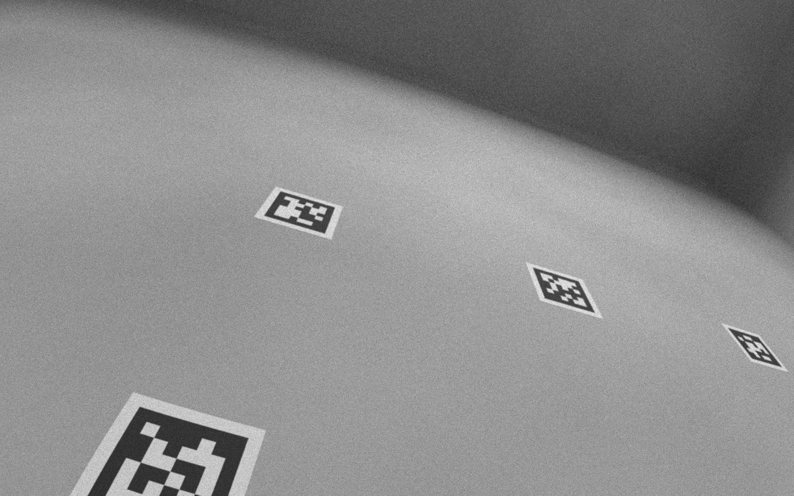
test_images/sensor/persp_007.png
