MurderBot1/apriltag-processor/test_images/sensor/persp_008.png

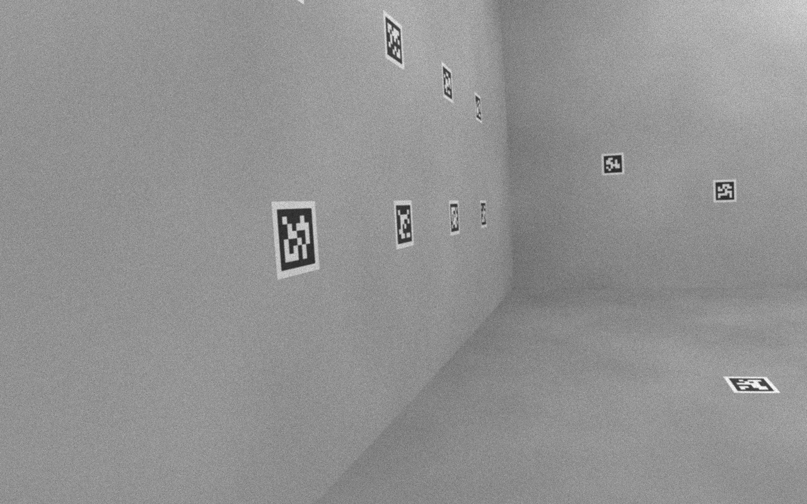
test_images/sensor/persp_008.png
