MurderBot1/apriltag-processor/test_images/sensor/persp_009.png

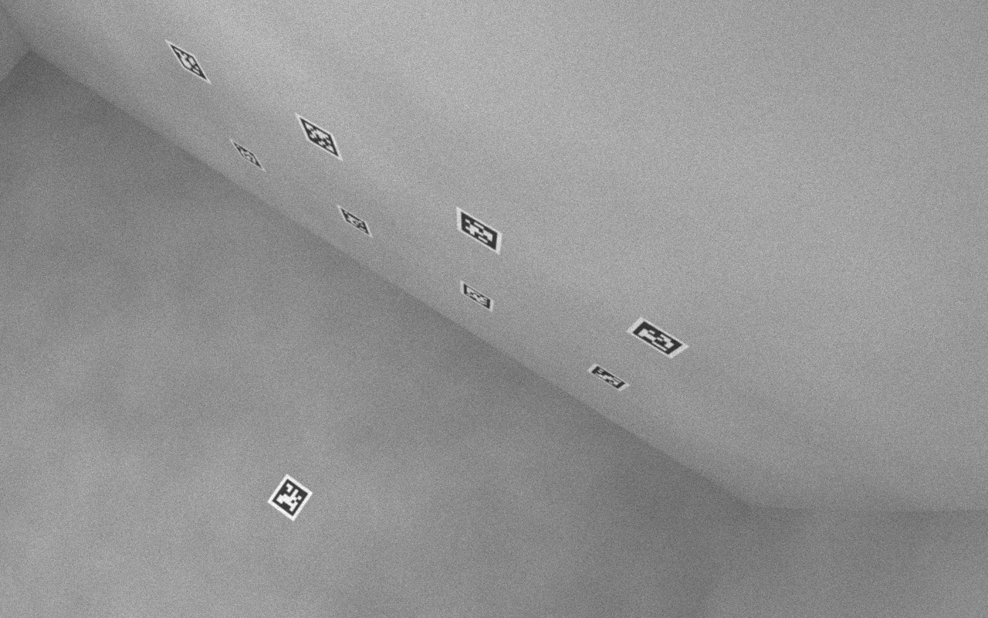
test_images/sensor/persp_009.png
