MurderBot1/apriltag-processor/test_images/sensor/shadow_000.png

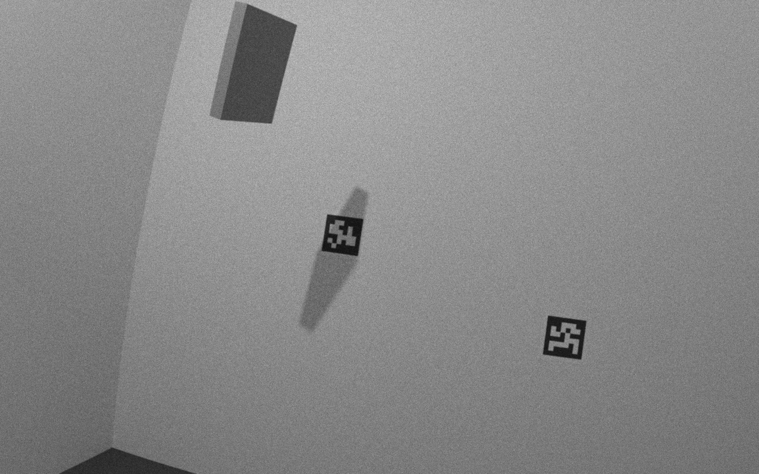
test_images/sensor/shadow_000.png
