MurderBot1/apriltag-processor/test_images/sensor/shadow_001.png

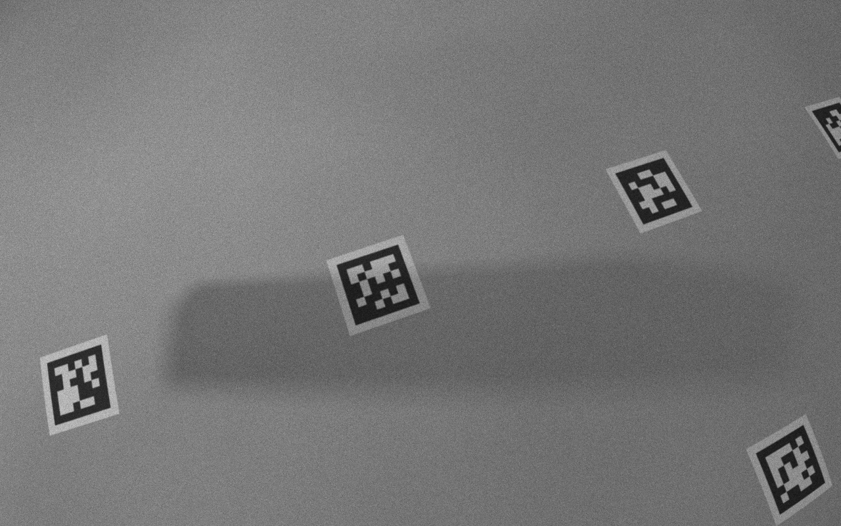
test_images/sensor/shadow_001.png
