MurderBot1/apriltag-processor/test_images/sensor/shadow_002.png

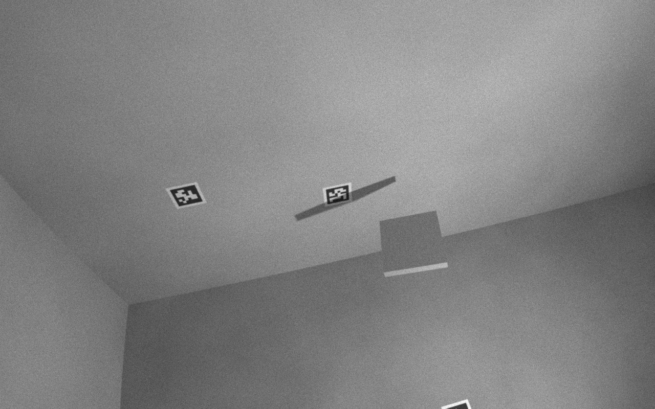
test_images/sensor/shadow_002.png
