MurderBot1/apriltag-processor/test_images/sensor/shadow_003.png

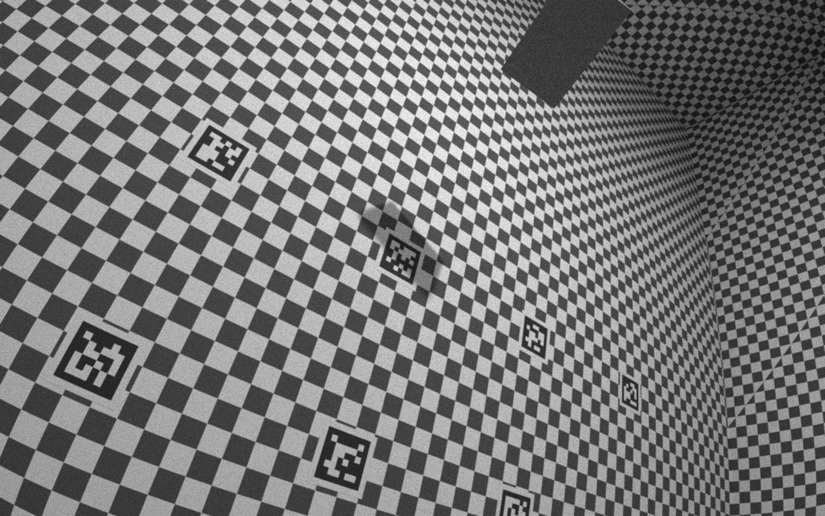
test_images/sensor/shadow_003.png
