MurderBot1/apriltag-processor/test_images/sensor/shadow_004.png

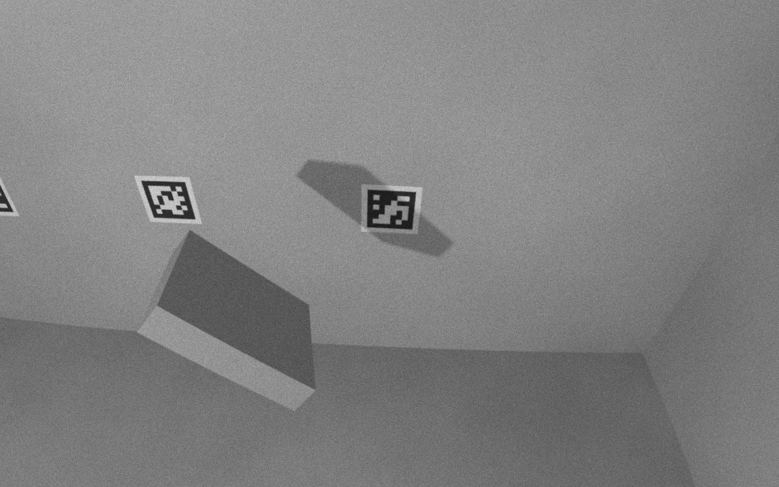
test_images/sensor/shadow_004.png
