MurderBot1/apriltag-processor/test_images/sensor/shadow_005.png

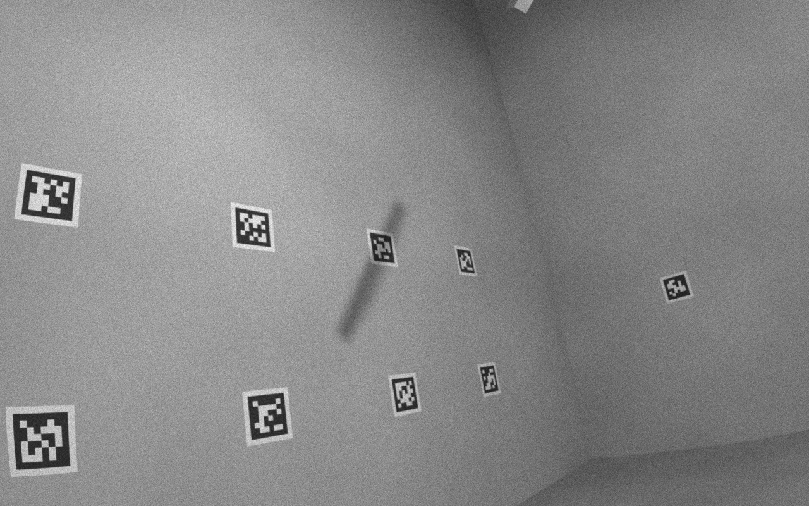
test_images/sensor/shadow_005.png
