MurderBot1/apriltag-processor/test_images/sensor/shadow_006.png

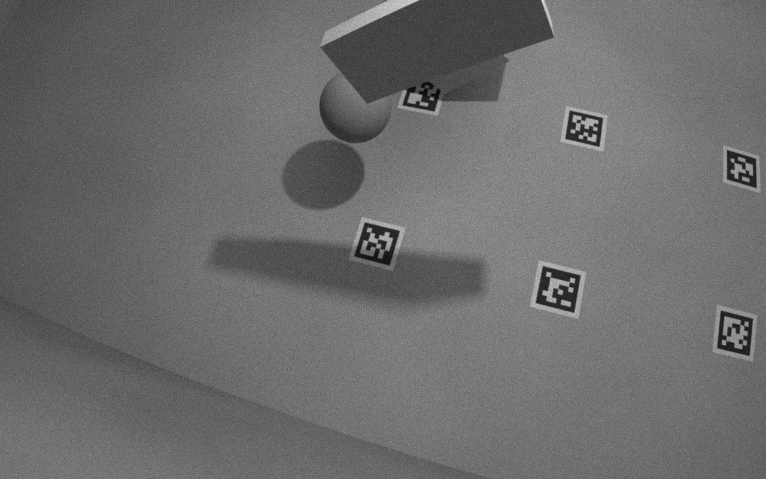
test_images/sensor/shadow_006.png
