MurderBot1/apriltag-processor/test_images/sensor/shadow_007.png

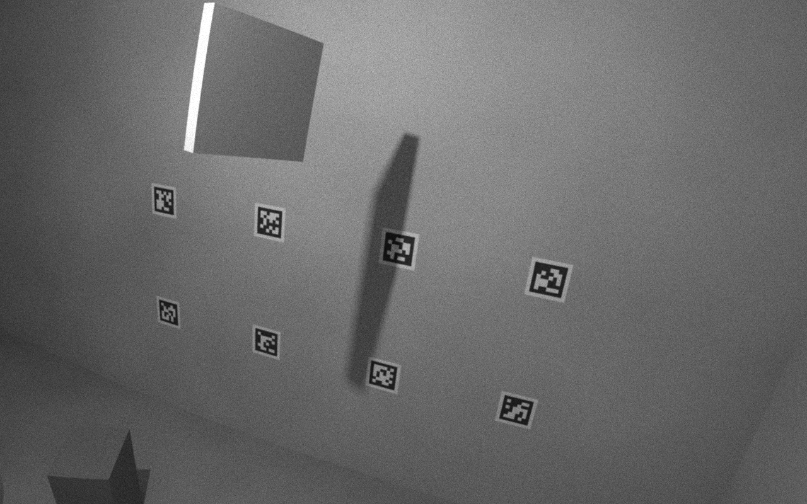
test_images/sensor/shadow_007.png
