MurderBot1/apriltag-processor/test_images/sensor/shadow_008.png

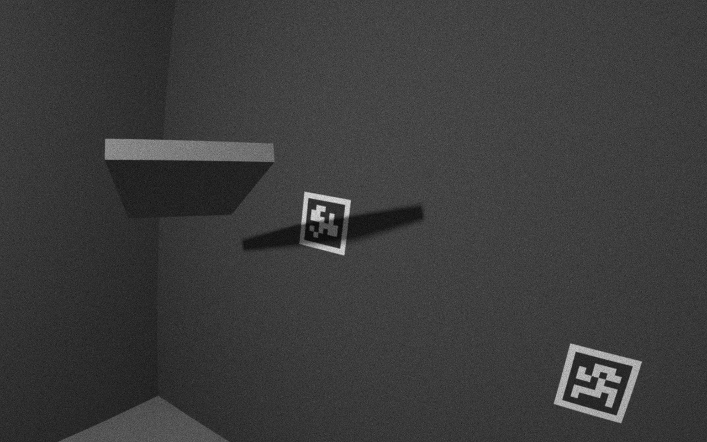
test_images/sensor/shadow_008.png
