MurderBot1/apriltag-processor/test_images/sensor/shadow_009.png

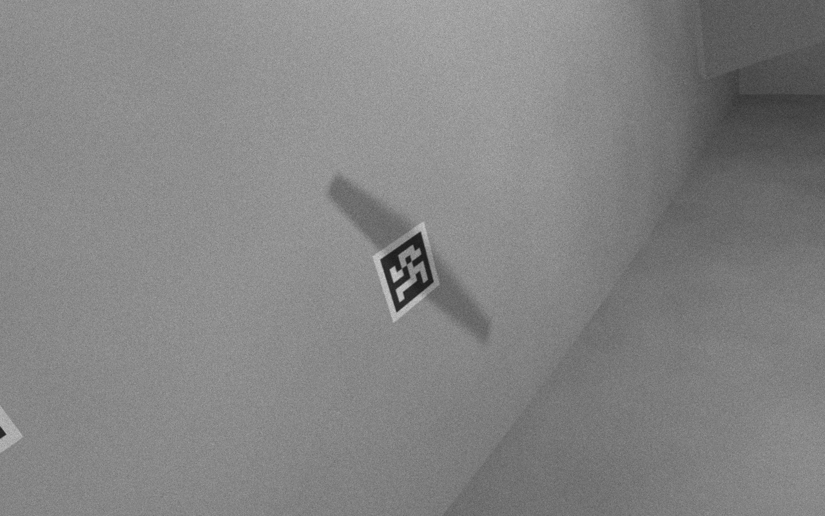
test_images/sensor/shadow_009.png
