MurderBot1/apriltag-processor/test_images/tags/tag36h11_101.png

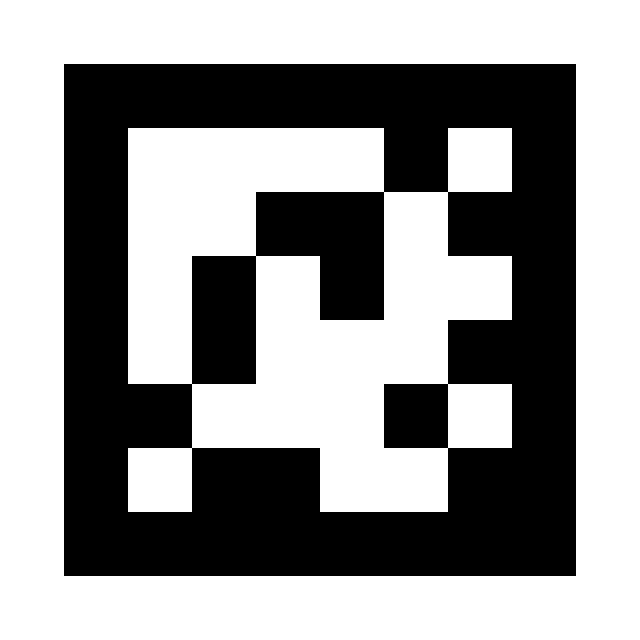
test_images/tags/tag36h11_101.png
