MurderBot1/apriltag-processor/test_images/tags/tag36h11_250.png

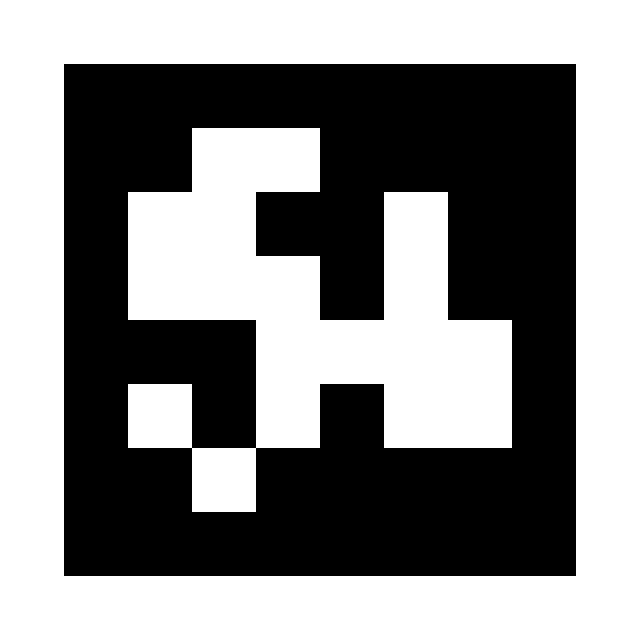
test_images/tags/tag36h11_250.png
