MurderBot1/apriltag-processor/(list of files, drawings)

Other design files:
pcb/output/apriltag_cam.dsn
pcb/pcb_params.json
