MurderBot1/apriltag-processor/pcb/output/apriltag_cam.kicad_pcb

## KiCad design pcb/output/apriltag_cam.kicad_pcb (2026-11-01)

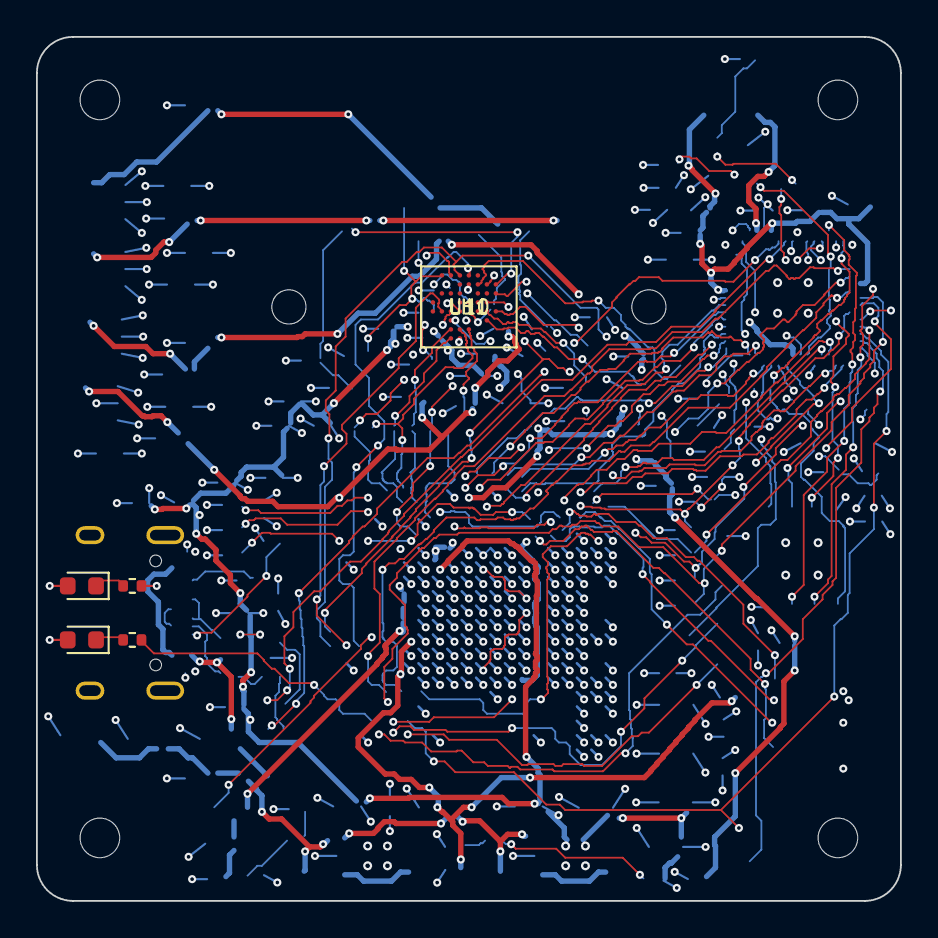
[picture p260: board apriltag_cam.kicad_pcb from above]

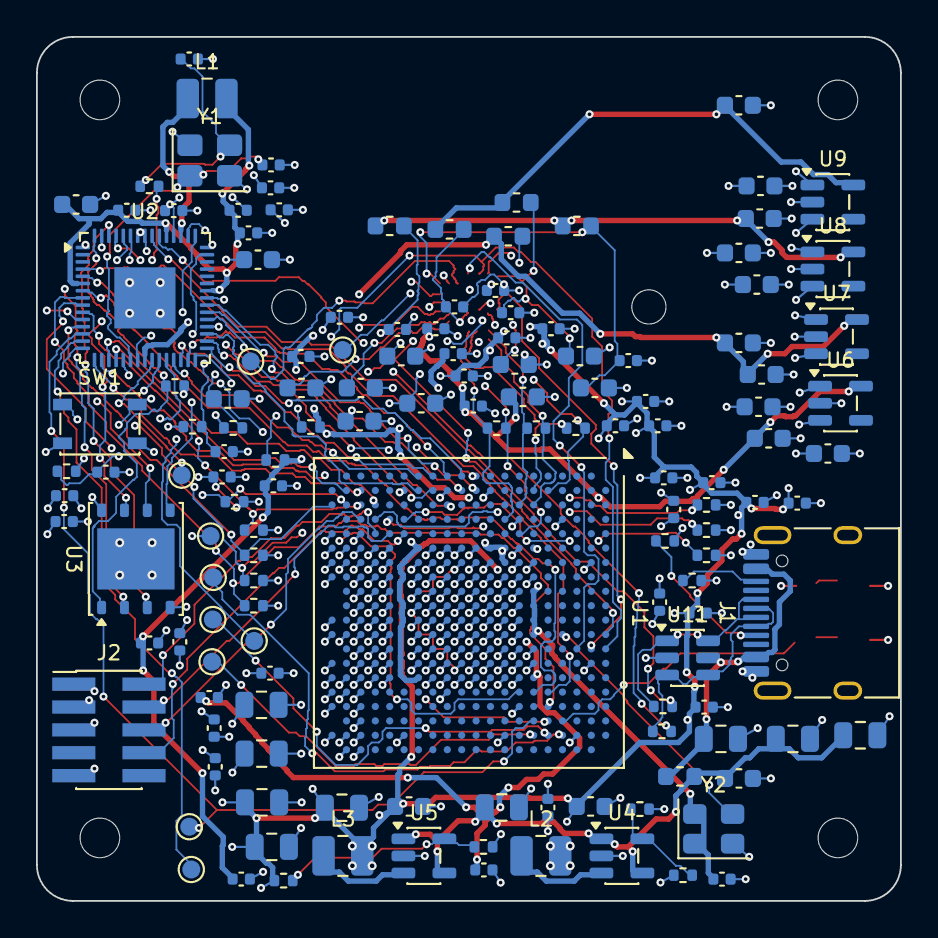
[picture p261: board apriltag_cam.kicad_pcb from below]

Board: 4 copper layers, 48.0 x 48.0 mm, 152 parts (142 on the bottom side), 95 nets.

Parts:
C1, C2, C3, C4, C5, C6, C7, C8, C9, C13, C14, C17, C38, C39, C40, C41, C42, C43, C44, C45, C46, C47, C48, C49, C50, C51, C52, C53, C54, C55, C56, C57, C58, C59, C60, C61, C62, C63, C64, C65, C70, C72, C74, C76, C77, C78: 100n; C_0402_1005Metric
C10, C11, C12, C36, C37, C66, C67, C68, C69: 4u7; C_0603_1608Metric
C15, C16: 15p; C_0402_1005Metric
C18, C19, C21, C24: 10u; C_0805_2012Metric
C20, C28, C30, C32, C34, C71, C73, C75, C79, C80, C81, C82: 1u; C_0603_1608Metric
C22, C23, C25, C26, C27: 22u; C_0805_2012Metric
C29, C31, C33, C35: 2u2; C_0603_1608Metric
D1: PWR; LED_0603_1608Metric
D2: STAT; LED_0603_1608Metric
FB1: BLM18 600R; L_0603_1608Metric
FB2, FB3, FB4, FB5, FB6: BLM18 120R; L_0603_1608Metric
J1: USB-C; USB_C_Receptacle_HRO_TYPE-C-31-M-12
J2: JTAG; PinHeader_2x05_P1.27mm_Vertical_SMD
L1: 3u3; L_1008_2520Metric
L2, L3: 2u2; L_1008_2520Metric
LH1: M12 holder 20x20; M12_LENS_MOUNT
MH1, MH2, MH3, MH4: M2; MountingHole_2.2mm_M2
R1, R2: 33R; R_0402_1005Metric
R3, R19, R20, R21, R22, R23: 10k; R_0402_1005Metric
R4, R5, R14, R15: 1k; R_0402_1005Metric
R6, R7: 5k1; R_0402_1005Metric
R8, R9: 27R; R_0402_1005Metric
R10: 453k; R_0402_1005Metric
R11, R13: 100k; R_0402_1005Metric
R12: 82k5; R_0402_1005Metric
R16, R17, R18: 4k7; R_0402_1005Metric
R24, R25, R26: 100R; R_0402_1005Metric
R27, R28: 2k2; R_0402_1005Metric
SW1: BOOTSEL; SW_SPST_PTS810
TP1: SWCLK; TestPoint_Pad_D1.0mm
TP2: SWDIO; TestPoint_Pad_D1.0mm
TP3: GND; TestPoint_Pad_D1.0mm
TP4: LED_1; TestPoint_Pad_D1.0mm
TP5: LED_2; TestPoint_Pad_D1.0mm
TP6: LED_3; TestPoint_Pad_D1.0mm
TP7: MCU_AUX; TestPoint_Pad_D1.0mm
TP8: FPGA_IRQ; TestPoint_Pad_D1.0mm
TP9: SNS_STROBE; TestPoint_Pad_D1.0mm
TP10: SNS_FSIN; TestPoint_Pad_D1.0mm
U1: LFE5U-25F-8BG381I; Lattice_caBGA-381_17x17mm_Layout20x20_P0.8mm
U2: RP2350A; QFN-60-1EP_7x7mm_P0.4mm_EP3.4x3.4mm
U3: W25Q128JVPIQ; WSON-8-1EP_6x5mm_P1.27mm_EP3.4x4.3mm
U4, U5: TLV62569; SOT-23-5
U6: ME6211C25; SOT-23-5
U7: TLV75518; SOT-23-5
U8: ME6211C28; SOT-23-5
U9: TLV75512; SOT-23-5
U10: OV9281; OV9281_CSP
U11: USBLC6-2SC6; SOT-23-6
Y1: 12MHz 10pF; Crystal_SMD_3225-4Pin_3.2x2.5mm
Y2: 24MHz 1.8V; Oscillator_SMD_Abracon_ASE-4Pin_3.2x2.5mm

Connections:
+1V1: C25.1, C26.1, C27.1, C38.1, C39.1, C40.1, C41.1, C42.1, C43.1, C44.1, C45.1, C46.1, C47.1, C48.1, C49.1, C66.1, C67.1, L3.2, R12.1, U1.H8, U1.H9, U1.H10, U1.H11, U1.H12, U1.H13, U1.J8, U1.J13, U1.K8, U1.K13, U1.L8, U1.L13, U1.M8, U1.M13, U1.N8, U1.N9, U1.N10, U1.N11, U1.N12, U1.N13
+1V1MCU: C7.1, C8.1, C9.1, C10.1, L1.2, U2.6, U2.23, U2.39, U2.50
+1V2: C35.1, FB3.1, FB5.1, U9.5
+1V8: C31.1, C37.1, C54.1, C55.1, C56.1, C57.1, C58.1, C70.1, FB4.1, R27.2, R28.2, U1.F9, U1.F10, U1.F11, U1.F12, U1.H6, U1.H7, U1.J6, U7.5, Y2.1, Y2.4
+2V5: C29.1, C50.1, C51.1, C52.1, C53.1, C68.1, U1.F6, U1.F15, U1.P6, U1.P15, U6.5
+2V8: C33.1, FB2.1, FB6.1, U8.5
+3V3: C1.1, C2.1, C3.1, C4.1, C5.1, C6.1, C11.1, C17.1, C22.1, C23.1, C28.1, C30.1, C32.1, C34.1, C36.1, C59.1, C60.1, C61.1, C62.1, C63.1, C64.1, C65.1, C69.1, D1.2, D2.2, J2.1, L2.2, R1.1, R2.1, R3.2, R10.1, R16.2, R19.2, R20.2, R21.2, R22.2, R23.2, U1.H14, U1.H15, U1.J15, U1.L6, U1.L7, U1.L14, U1.L15, U1.M6, U1.M15, U1.P9, U1.P10, U2.1, U2.11, U2.20, U2.30, U2.38, U2.45, U2.49, U2.53, U2.54, U3.8, U6.1, U6.3, U7.1, U7.3, U8.1, U8.3, U9.1, U9.3
+5V: C18.1, C20.1, C21.1, C24.1, FB1.2, U4.1, U4.4, U5.1, U5.4
ADC_AVDD: C13.1, R2.2, U2.44
AVDD_S: C71.1, C72.1, FB2.2, U10.B8
BOOT_N: R5.2, SW1.1
CC1: J1.A5, R6.1
CC2: J1.B5, R7.1
CFG0: R16.1, U1.U4
CFG1: R17.1, U1.T4
CFG2: R18.1, U1.R4
CLK24M: U1.D12, Y2.3
DOVDD_S: C75.1, C76.1, FB4.2, U10.B7
DVDD_S: C73.1, C74.1, FB3.2, U10.A2
EVDD_S: C78.1, FB6.2, U10.F3
FB_CLK: U1.K2, U2.36
FB_D0: U1.P1, U2.27
FB_D1: U1.N1, U2.28
FB_D2: U1.M1, U2.29
FB_D3: U1.L1, U2.31
FB_D4: U1.K1, U2.32
FB_D5: U1.P2, U2.33
FB_D6: U1.N2, U2.34
FB_D7: U1.L2, U2.35
FB_FS: U1.M3, U2.37
FPGA_CCLK: U1.U3, U2.18
FPGA_CFG_CS: U1.R2, U2.17
FPGA_CFG_MISO: U1.V2, U2.16
FPGA_CFG_MOSI: U1.W2, U2.19
FPGA_DONE: R21.1, U1.Y3, U2.12
FPGA_INITN: R20.1, U1.V3, U2.10
FPGA_IRQ: TP8.1, U1.F18, U2.13
FPGA_PROGRAMN: R19.1, U1.W3, U2.9
FPGA_RST: R22.1, U1.G16, U2.15
GND: C1.2, C2.2, C3.2, C4.2, C5.2, C6.2, C7.2, C8.2, C9.2, C10.2, C11.2, C12.2, C13.2, C14.2, C15.2, C16.2, C17.2, C18.2, C19.2, C20.2, C21.2, C22.2, C23.2, C24.2, C25.2, C26.2, C27.2, C28.2, C29.2, C30.2, C31.2, C32.2, C33.2, C34.2, C35.2, C36.2, C37.2, C38.2, C39.2, C40.2, C41.2, C42.2, C43.2, C44.2, C45.2, C46.2, C47.2, C48.2, C49.2, C50.2, C51.2, C52.2, C53.2, C54.2, C55.2, C56.2, C57.2, C58.2, C59.2, C60.2, C61.2, C62.2, C63.2, C64.2, C65.2, C66.2, C67.2, C68.2, C69.2, C70.2, C71.2, C72.2, C73.2, C74.2, C75.2, C76.2, C77.2, C78.2, C79.2, C80.2, C81.2, C82.2, J1.A1, J1.A12, J1.B1, J1.B12, J1.SH, J2.3, J2.5, J2.9, R6.2, R7.2, R11.2, R13.2, R14.2, R17.2, R18.2, SW1.2, TP3.1, U1.B7, U1.B14, U1.C19, U1.D4, U1.F7, U1.F8, U1.F13, U1.F14, U1.G4, U1.G6, U1.G7, U1.G8, U1.G9, U1.G10, U1.G11, U1.G12, U1.G13, U1.G14, U1.G15, U1.G17, U1.H19, U1.J2, U1.J7, U1.J9, U1.J10, U1.J11, U1.J12, U1.J14, U1.K6, U1.K7, U1.K9, U1.K10, U1.K11, U1.K12, U1.K14, U1.K15, U1.L9, U1.L10, U1.L11, U1.L12, U1.M2, U1.M7, U1.M9, U1.M10, U1.M11, U1.M12, U1.M14, U1.M16, U1.N6, U1.N7, U1.N14, U1.N15, U1.P7, U1.P8, U1.P11, U1.P12, U1.P13, U1.P14, U1.R19, U1.T6, U1.T7, U1.T8, U1.T9, U1.T10, U1.T11, U1.T12, U1.T13, U1.T14, U1.T15, U1.U6, U1.U7, U1.U8, U1.U9, U1.U10, U1.U11, U1.U12, U1.U13, U1.U14, U1.U15, U1.V5, U1.V6, U1.V7, U1.V8, U1.V9, U1.V10, U1.V11, U1.V12, U1.V13, U1.V14, U1.V15, U1.V16, U1.V17, U1.V18, U1.V19, U1.V20, U1.W6, U1.W7, U1.W12, U1.W15, U1.W16, U1.W19, U1.W20, U1.Y5, U1.Y6, U1.Y7, U1.Y8, U1.Y11, U1.Y12, U1.Y14, U1.Y15, U1.Y16, U1.Y17, U1.Y19, U2.47, U2.61, U3.4, U3.9, U4.2, U5.2, U6.2, U7.2, U8.2, U9.2, U10.A3, U10.C8, U10.E3, U11.2, Y1.2, Y1.4, Y2.2
JTAG_TCK: J2.4, U1.T5
JTAG_TDI: J2.8, U1.R5
JTAG_TDO: J2.6, U1.V4
JTAG_TMS: J2.2, U1.U5
LED_1: TP4.1, U1.D19
LED_2: TP5.1, U1.E19
LED_3: TP6.1, U1.F19
LED_PWR_K: D1.1, R14.1
LED_STAT: R15.1, U1.D18
LED_STAT_K: D2.1, R15.2
MCU_AUX: TP7.1, U2.14
MCU_RUN: C14.1, R3.1, U2.26
MIPI_CLK_N: R24.2, U1.E2, U10.H4
MIPI_CLK_P: R24.1, U1.F2, U10.G4
MIPI_D0_N: R25.2, U1.F3, U10.H3
MIPI_D0_P: R25.1, U1.G3, U10.G3
MIPI_D1_N: R26.2, U1.G5, U10.F5
MIPI_D1_P: R26.1, U1.H4, U10.G5
PVDD_S: C77.1, FB5.2, U10.D5
QSPI_SCLK: U2.56, U3.6
QSPI_SD0: U2.57, U3.5
QSPI_SD1: U2.59, U3.2
QSPI_SD2: U2.58, U3.3
QSPI_SD3: U2.55, U3.7
QSPI_SS: R5.1, U2.60, U3.1
SCL: R27.1, U1.A12, U10.E4
SDA: R28.1, U1.A13, U10.A4
SNS_FSIN: TP10.1, U10.B5
SNS_STROBE: TP9.1, U10.B6
SPI_CS: R23.1, U1.E17, U2.8
SPI_MISO: U1.F16, U2.7
SPI_MOSI: U1.E18, U2.5
SPI_SCK: U1.E16, U2.4
SW1V1: L3.1, U5.3
SW1V1_FB: R12.2, R13.1, U5.5
SW3V3: L2.1, U4.3
SW3V3_FB: R10.2, R11.1, U4.5
SWCLK: TP1.1, U2.24
SWDIO: TP2.1, U2.25
USB_DM_MCU: R9.2, U2.51
USB_DN: J1.A7, J1.B7, R9.1, U11.3, U11.4
USB_DP: J1.A6, J1.B6, R8.1, U11.1, U11.6
USB_DP_MCU: R8.2, U2.52
VBUS: C19.1, FB1.1, J1.A4, J1.A9, J1.B4, J1.B9, U11.5
VH: C79.1, U10.E8
VN1: C80.1, U10.D7
VN2: C81.1, U10.E7
VN3: C82.1, U10.F7
VREG_AVDD: C12.1, R1.2, U2.46
VREG_LX: L1.1, U2.48
XIN: C15.1, U2.21, Y1.1
XOUT: C16.1, R4.1, Y1.3
XOUT_R: R4.2, U2.22
XSHUTDN: U1.C13, U10.A5
XVCLK: U1.B13, U10.E2
