MurderBot1/apriltag-processor/firmware/rp2350/tusb_config.h

#pragma once
/* TinyUSB configuration: one CDC (virtual COM port) device on the RP2350 USB controller. */
#define CFG_TUSB_RHPORT0_MODE   (OPT_MODE_DEVICE)
#define CFG_TUSB_OS             OPT_OS_PICO
#define CFG_TUSB_MEM_SECTION
#define CFG_TUSB_MEM_ALIGN      __attribute__((aligned(4)))

#define CFG_TUD_ENDPOINT0_SIZE  64
#define CFG_TUD_CDC             1
#define CFG_TUD_MSC             0
#define CFG_TUD_HID             0
#define CFG_TUD_MIDI            0
#define CFG_TUD_VENDOR          0

#define CFG_TUD_CDC_RX_BUFSIZE  1024
#define CFG_TUD_CDC_TX_BUFSIZE  2048
#define CFG_TUD_CDC_EP_BUFSIZE  64
