MurderBot1/apriltag-processor/(commit log)

2026-10-29 AprilTag camera: RTL vision chip, firmware, host, client APIs, device clock
    [Lattice_caBGA-381_17x17mm_Layout20x20_P0.8mm.step, M12_LENS_MOUNT.step, OV9281_CSP.step, Oscillator_SMD_Abracon_ASE-4Pin_3.2x2.5mm.step, QFN-60-1EP_7x7mm_P0.4mm_EP3.4x3.4mm.step, TestPoint_Pad_D1.0mm.step, USB_C_Receptacle_HRO_TYPE-C-31-M-12.step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]
2026-10-29 Replace the 500-image dataset with 100 new images: 10 categories x 10 (tools/make_dataset_100.py)
    Deterministic generator (fixed seeds) for normal, bright, dark, low-contrast, gradient light, shadow, noise, clutter, blur and
    perspective frames; old 100+400 frames, cases and ground truth removed.
2026-10-29 tb_cam: per-frame CCL/TPU trace (-DTRACE) and step-0 failure-mechanism findings
    [tb_cam.v]
2026-10-29 run_ccl: fast pipelined labeller with label recycling and top-64-by-area candidates
    MAXR 64->256, row banks parameterised (BB), 4-entry prev/cur run FIFOs, ~2-3 clk/run walker,
    pipelined stats unit, narrow info mirror for a 1-orphan-per-clock termination check, free list,
    deferred release of union-absorbed labels, 64-entry area-ranked candidate table.
    Capacity limits no longer invalidate a frame (flags are diagnostics only).
    [run_ccl.v]
2026-10-29 golden: streaming CCL model with capacity limits; directed CCL tests; CCL-only 500-frame sweep
2026-10-29 Port tests, tools, results and docs to the 100-image dataset
    test_dataset.py rewritten for 10 categories x 10; chain/firmware/host/pose tests use the new frame names; results regenerated
    (reference baseline, RTL chain over all 100 frames, parameter/noise/despeckle/candidate sweeps, contact sheet). Add tests/test_clock.py
    (tb_clock) to run_all; rtlutil/atcore work on Linux; chain.run_frames takes a maxcyc budget so rejected-frame tests do not wait for 400M cycles.
2026-10-29 run_ccl: fit the chip and close 85.714 MHz
    One write port per memory (info, pool, runse), packed run RAM, pool in LUT RAM, 1024-entry absorbed list,
    2-hop root resolution in the prefetch pipeline (8-deep FIFO), registered orphan-check flags, separate decision
    and finish states, extra register stage in the root-find loops. 196/208 block RAMs; core fmax 86.8 MHz (seed 4).
2026-10-29 chain: read back all result records (not 8); 500-frame RTL chain 2651/2825 (93.8%), 0 false positives
    tb_cam read only 8 tag records so a 9th+ tag showed up as a bogus id-0 tag at (0,0) and the real tag was lost.
    Results: results/rtl_chain_results.json (new CCL), results/rtl_chain_results_before_ccl_rework.json (previous
    CCL, same harness: 2158/2825), analysis, TPU-time budget per category, CCL-only sweep at 686 clocks/line.
2026-10-29 chain tests: bound the wait for rejected frames (maxcyc), CHAIN_TAG for parallel runs
    test_chain.py took 3 h because the testbench waited 400 M clocks for results of rejected frames; now 13.6 min.
2026-10-29 RTL chain on the 100-image dataset: 562/647 (87%, was 450/647); docs and TPU budget updated
2026-10-29 BOM: re-check prices/stock (2026-10-29), fix MPNs, add lens, holder screws
    FPGA 36.31 -> 100.13, flash 0.87 -> 3.42, crystal -> ABM8-272-T3 (10 pF),
    R10 -> 0402WGF4533TCE, L1 verified on LCSC, lens CIL018-F2.8-M12B650,
    CLA020 flagged out of stock, PCB fab price removed (was 1-2 layer price).
2026-10-29 docs/bom/AUDIT.md: BOM discrepancy list, lens candidates, open items
2026-10-29 Move status LEDs to the flat part of the housing roof
    D1 PWR / D2 STAT moved from (9, 21.5) / (12, 21.5), where the front-cover roof
    is the 45 degree cone, to (-21.5, -6.5) / (-21.5, -9.5), where the roof is flat
    and the light-pipe bores are perpendicular to it. Resistors R14/R15 moved to
    the top side next to the LEDs. Only the LED nets were re-routed; the rest of
    the board is untouched. Regenerated gerbers, STEP, renders, DRC, housing STL/STEP.
    [apriltag_cam-B_Cu.gbl, apriltag_cam-B_Mask.gbs, apriltag_cam-B_Paste.gbp, apriltag_cam-B_Silkscreen.gbo, apriltag_cam-Edge_Cuts.gm1, apriltag_cam-F_Cu.gtl, apriltag_cam-F_Mask.gts, apriltag_cam-F_Paste.gtp]
2026-10-30 CLAUDE.md: BOM changes must regenerate the website
2026-10-30 Regenerate site from current main (BOM 2026-10-29 prices, 100-image gallery); track site/sim generators
    .gitignore 'sim/' also ignored site/sim, so build_site.py could not run from a clone; anchor it to /sim/.
2026-10-30 BOM: verified prices for M2x10 screws, heat-set inserts and PLA filament; fit findings
2026-10-30 LEDs: regenerate stale 3D/render/site artefacts; add engraved power/pulse symbols on the front cover
    The previous LED move only updated the PCB source, gerbers and 2D renders. The full-assembly GLB/STEP, all Blender renders, the PCB texture tiles,
    the site 3D viewer and the pcb *_unrouted/_fixed/_routed_try variants still had D1/D2 at the old (9,21.5)/(12,21.5). Regenerated with render/run_all.sh
    (whose scripts hard-coded D:/apriltag-proccessor paths; now relative to the clone) and site/build_site.py; site/pcbinfo.py reads the routed board.
    Front cover: engraved IEC 5009 power symbol above the PWR bore and a heartbeat pulse line below the STAT bore (housing.scad sym_*), test added.
    Co-Autho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
    [Lattice_caBGA-381_17x17mm_Layout20x20_P0.8mm.step, M12_LENS_MOUNT.step, OV9281_CSP.step, Oscillator_SMD_Abracon_ASE-4Pin_3.2x2.5mm.step, QFN-60-1EP_7x7mm_P0.4mm_EP3.4x3.4mm.step, TestPoint_Pad_D1.0mm.step, USB_C_Receptacle_HRO_TYPE-C-31-M-12.step, apriltag_cam_fixed.kicad_pcb]
2026-10-31 Cost-down study: CPU vs FPGA detection, ECP5 45F/25F fit, lens, BOM at 1/10/100
    Measured native AprilTag timing on the 100-frame set, MIPS-scaled to candidate SoCs,
    front-end-only nextpnr runs on 25F/45F speed grades, LCSC price reads and a BOM model.
2026-10-31 A3 architecture: TPU in RP2350 firmware, frame bus, ECP5 45F, rerouted PCB
    Moves the TPU and frame banks out of the FPGA into RP2350 firmware; U1 becomes LFE5U-45F-8BG381C. Squash keeps the 67 MB jar from branch history out of main.
    [Lattice_caBGA-381_17x17mm_Layout20x20_P0.8mm.step, M12_LENS_MOUNT.step, OV9281_CSP.step, Oscillator_SMD_Abracon_ASE-4Pin_3.2x2.5mm.step, QFN-60-1EP_7x7mm_P0.4mm_EP3.4x3.4mm.step, TestPoint_Pad_D1.0mm.step, USB_C_Receptacle_HRO_TYPE-C-31-M-12.step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]
2026-11-01 Firmware: 3 frame buffers with early release to cut frame drops
2026-11-01 Site: regenerate simulation pages for 100-frame dataset and A3 architecture
2026-11-01 BOM: production sourcing check, stock/price refresh, PRODUCTION.md
2026-11-01 Optics and housing: CIL023 lens, CLA021 holder, re-derived z stack
    [M12_LENS_MOUNT.step, apriltag_cam_full.step, apriltag_housing_pcb_lens.step, back.stl, front.stl, housing.scad, housing.step, housing_back.step]
2026-11-01 RTL: THRESH ratio field fixes lowcon (66/66 at ratio 1), firmware/host/API control
    Default ratio 0 keeps 562/647. Co-Authored-By: Claude Sonnet 5.5 <noreply@anthropic.com>
    [atapp.c, cam_core.v, camera.py]
2026-11-01 BOM: U1 becomes LFE5U-25F-8BG381I (in stock, closes timing), sourcing facts
    [apriltag_cam.kicad_pcb, bom.csv, pick_and_place.csv, placement.csv]
2026-11-01 PCB: connect floating power pads, in-stock LDOs, flash MPN, 1.9 mm screw holes, ERC tests
    DRC 69+10 unconnected -> 67+0. Co-Authored-By: Claude Sonnet 5.5 <noreply@anthropic.com>
    [apriltag_cam-B_Cu.gbl, apriltag_cam-B_Mask.gbs, apriltag_cam-B_Paste.gbp, apriltag_cam-B_Silkscreen.gbo, apriltag_cam-Edge_Cuts.gm1, apriltag_cam-F_Cu.gtl, apriltag_cam-F_Mask.gts, apriltag_cam-F_Paste.gtp]
2026-11-01 Docs, site, BOM: consistent with A3, 25F, ME6211, new RESUME.md
2026-11-02 Dataset re-rendered for CIL023 lens (82.2 deg, k1 -0.126), per-category CI thresholds
